barisyamann/2026_Arkhe/fpga/README.md

# FPGA/demo s?r?mleri

nexys_demo_20260908: d45 ortak SoC RTL + Pmod UART2 wrapper, 8 Eyl?l 16:18 bitstream'i, 17:31 demo sonu?lar?. Son UART FIFO d?zeltmesi dahil de?il.
JURI_FPGA_TESTI: 5 Eyl?l tek USB tan?lama firmware/wrapper/bitstream ve kart kay?tlar?. Bunun MCS/bit ?iftini di?er s?r?mle kar??t?rmay?n.

Her s?r?m?n kendi README/KULLANIM belgesini okuyun. Paketleme s?ras?nda kart programlanmad?; yeni fiziksel test yap?lmad?.
