barisyamann/2026_Arkhe/asic/reports/routing/wire_lengths.csv

net | length_um
clknet_2_3_1_clk_i | 6.9465mm
clknet_2_1_1_clk_i | 6.72806mm
clknet_2_0_1_clk_i | 6.52889mm
clknet_2_2_1_clk_i | 5.18468mm
clk_i | 4.64188mm
net4065 | 3.80295mm
net3651 | 3.62575mm
net3675 | 3.61629mm
_027918_ | 3.53636mm
net4210 | 3.467815mm
clknet_7_0_0_clk_i_regs | 3.466395mm
net9088 | 3.46326mm
net9084 | 3.46235mm
net4058 | 3.31082mm
net4142 | 3.075665mm
merged_m_araddr\[3\] | 3.00816mm
u_data_ram.aw_addr_reg\[3\] | 3.0053mm
clknet_7_3_0_clk_i_regs | 3.0016mm
net4051 | 2.89979mm
_027981_ | 2.88226mm
s10_rdata\[6\] | 2.72128mm
net3665 | 2.68324mm
net380 | 2.65649mm
net407 | 2.64611mm
net416 | 2.63029mm
_060634_ | 2.62514mm
net901 | 2.60818mm
net3990 | 2.58616mm
net9157 | 2.58393mm
net909 | 2.58384mm
net8920 | 2.583405mm
net8073 | 2.518835mm
net906 | 2.51304mm
net3401 | 2.49414mm
net2943 | 2.49351mm
net398 | 2.48853mm
net408 | 2.46272mm
net434 | 2.46176mm
net8071 | 2.46164mm
net389 | 2.43297mm
net11709 | 2.42556mm
net385 | 2.39201mm
s8_rdata\[16\] | 2.381375mm
net363 | 2.3696mm
net425 | 2.35906mm
net8077 | 2.353mm
net4400 | 2.34037mm
net371 | 2.33597mm
net8072 | 2.329685mm
net8079 | 2.3274mm
net4329 | 2.32138mm
net470 | 2.31865mm
net362 | 2.31157mm
net479 | 2.30705mm
net893 | 2.30635mm
net372 | 2.30579mm
net443 | 2.30098mm
net354 | 2.29474mm
net376 | 2.29187mm
net356 | 2.28807mm
net799 | 2.27771mm
net515 | 2.27461mm
net31530 | 2.25448mm
net419 | 2.25157mm
net18714 | 2.24152mm
net461 | 2.23207mm
net353 | 2.22472mm
net4248 | 2.21534mm
net987 | 2.21363mm
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
_029973_ | 479.51µm
_067338_ | 479.51µm
net6996 | 479.32µm
_054790_ | 479.28µm
_073847_ | 479.24µm
net2302 | 479.2µm
_049291_ | 479.09µm
_032130_ | 478.84µm
_054701_ | 478.52µm
_023765_ | 478.48µm
_041784_ | 478.37µm
_031653_ | 478.16µm
u_instruction_ram.aw_addr_reg\[6\] | 477.98µm
_028978_ | 477.77µm
_032556_ | 477.69µm
net1433 | 477.69µm
net1042 | 477.64µm
net317 | 477.52µm
_074388_ | 477.41µm
_037269_ | 477.32µm
net9256 | 477.24µm
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
