barisyamann/2026_Arkhe/asic/reports/signoff/full_disconnected_pins_table.txt

┏━━━━━━━━━━━━━━━━━━━━━━━━━━━━━━━━━━━┳━━━━━━━━━━━━━━━━━━━━━━━━━━━━━━━━━━━┳━━━━━━━━━━━━━━┳━━━━━━━━━━━━━━━━━━━━━━━━━━━━━━━━━━━┳━━━━━━━━━━━━━━━━━━━━━━━━━━━━━━━━━━━┓
┃ Macro/Instance                    ┃ Power Pins                        ┃ Disconnected ┃ Signal Pins                       ┃ Disconnected                      ┃
┡━━━━━━━━━━━━━━━━━━━━━━━━━━━━━━━━━━━╇━━━━━━━━━━━━━━━━━━━━━━━━━━━━━━━━━━━╇━━━━━━━━━━━━━━╇━━━━━━━━━━━━━━━━━━━━━━━━━━━━━━━━━━━╇━━━━━━━━━━━━━━━━━━━━━━━━━━━━━━━━━━━┩
│ u_data_ram.g_sram[0\].u_macro     │ u_data_ram.g_sram[0\].u_macro/vc… │              │ u_data_ram.g_sram[0\].u_macro/di… │ u_data_ram.g_sram[0\].u_macro/do… │
│                                   │ u_data_ram.g_sram[0\].u_macro/vs… │              │ u_data_ram.g_sram[0\].u_macro/di… │ u_data_ram.g_sram[0\].u_macro/do… │
│                                   │                                   │              │ u_data_ram.g_sram[0\].u_macro/di… │ u_data_ram.g_sram[0\].u_macro/do… │
│                                   │                                   │              │ u_data_ram.g_sram[0\].u_macro/di… │ u_data_ram.g_sram[0\].u_macro/do… │
│                                   │                                   │              │ u_data_ram.g_sram[0\].u_macro/di… │ u_data_ram.g_sram[0\].u_macro/do… │
│                                   │                                   │              │ u_data_ram.g_sram[0\].u_macro/di… │ u_data_ram.g_sram[0\].u_macro/do… │
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
│                                   │                                   │              │ u_instruction_ram.g_sram[3\].u_m… │                                   │
│                                   │                                   │              │ u_instruction_ram.g_sram[3\].u_m… │                                   │
│                                   │                                   │              │ u_instruction_ram.g_sram[3\].u_m… │                                   │
└───────────────────────────────────┴───────────────────────────────────┴──────────────┴───────────────────────────────────┴───────────────────────────────────┘
