barisyamann/2026_Arkhe/fpga/nexys_demo_20260908/demo/results/ARKHE_20260914_032433/report.md

# Demo Degerlendirme Raporu - ARKHE

- Tarih: 2026-09-14T03:25:24+03:00
- Harness surumu: 1.0.1
- Konfigurasyon kaynagi: `arkhe_icd.json`
- Etkin konfigurasyon: `config_used.json` (SHA256 `cae2893733a1b49e`)
- Veri seti: public_dataset/manifest.csv | seed: 1337
- Arayuzler: stream `COM12@1000000`, core `COM16@115200`

## 1. Ozet - RTL / Golden Model Uyumu

> **Olculen sey modelin dogrulugu degil, tasarimin golden modele sadakatidir.**
> Birincil olcut, donanimin urettigi sinifin golden modelin ayni vektor icin
> urettigi sinifla ayni olmasidir. Gercek etiket (truth) yalnizca bilgi
> amaciyla raporlanir ve puanlamada kullanilmaz.

| Metrik | Deger |
|---|---|
| Gonderilen ornek | 156 |
| Golden referansi olan | 156 |
| Yanitlanan | 154 |
| **Golden ile uyum** | 100.00 %  (154/154) |
| Uyusmazlik | 0 |
| Zaman asimi (referansli ornek) | 2 |
| Uyum (zaman asimlari da hata sayilirsa) | 98.72 % |
| **Golden skor hata orani (MAE)** | 0.0780 % |
| Skor karsilastirilan ornek | 154 |
| En yuksek ornek-bazli skor hatasi | 0.8675 % |
| Gecikme (medyan / p95 / max) | 23.95 / 24.25 / 29.03 ms |
| Olculen hizlanma (yazilim / donanim) | 59.2x |
| Saglamlik senaryolari | 9 / 10 (+1 opsiyonel atlandi) |

> Skor hata orani yalnizca ek bilgidir ve puanlamada kullanilmaz. UART'tan
> gelen dort skor, manifest'teki golden skorlarla ayni sinif sirasinda
> karsilastirilir. Deger 0'a yaklastikca sayisal uyum daha iyidir.

> Not: gecikme, cerceve yaziminin bittigi an ile sonuc satirinin son baytinin
> alindigi an arasidir; UART aktarim ve ISR suresini icerir. Saf hizlandirici
> cevrim sayisi icin RTL simulasyon capraz kontrolu esastir.

## 2. Uyum Matrisi (satir = golden referans, sutun = donanim ciktisi)

| golden \ donanim | silence | unknown | yes | no | TIMEOUT |
|---|---|---|---|---|---|
| **silence** | **6** | 0 | 0 | 0 | 0 |
| **unknown** | 0 | **16** | 0 | 0 | 0 |
| **yes** | 0 | 0 | **50** | 0 | 0 |
| **no** | 0 | 0 | 0 | **82** | 2 |

Kosegen = golden ile ayni sinif. Kosegen disi her hucre, RTL'in golden
modelden ayristigi bir ornektir.

### Bilgi amacli: gercek etikete (truth) gore dogruluk

_Bu bolum puanlamada KULLANILMAZ; veri setinin zorlugu hakkinda fikir verir._

| | Dogruluk |
|---|---|
| Donanim | 72.73 % |
| Golden model (yazilim) | 72.44 % |
| Fark | +0.29 puan |

## 3. Saglamlik Senaryolari (Secenek F)

| Senaryo | Sonuc | Aciklama |
|---|---|---|
| silence_zeros | PASS | cikti=no, gecikme=23.6 ms, sonraki gecerli cerceve yanitladi |
| silence_dither | PASS | cikti=no, gecikme=22.4 ms, sonraki gecerli cerceve yanitladi |
| saturate_max | PASS | cikti=unknown, gecikme=23.4 ms, sonraki gecerli cerceve yanitladi |
| saturate_min | PASS | cikti=silence, gecikme=23.8 ms, sonraki gecerli cerceve yanitladi |
| alternating | PASS | cikti=silence, gecikme=23.4 ms, sonraki gecerli cerceve yanitladi |
| back_to_back | FAIL | araliksiz 5 cerceveden 4 tanesi yanitlandi |
| truncated_frame | PASS | kesik cerceve sonrasi kurtarma basarili (cikti=no) |
| oversized_frame | PASS | fazladan bayt sonrasi kurtarma basarili (cikti=no) |
| peripheral_interleave | SKIP | ATLANDI (opsiyonel): hooks.interleave_core_hex tanimlanmamis; cevre birimi araya girme testi uygulanmadi. |
| determinism | PASS | 10 tekrarda 1 farkli sonuc; gecikme jitter=1.59 ms |
| recovery_after_idle | PASS | 3 s bosta bekledikten sonra yanit verdi (no) |

## 4. Golden Modelden Ayrisan Ornekler

| # | ornek | golden | donanim | truth (bilgi) | skor hata (%) | gecikme (ms) |
|---|---|---|---|---|---|---|
| 0 | go_f19279c4_nohash_0 | no | TIMEOUT | unknown | - | - |
| 1 | no_256c0a05_nohash_0 | no | TIMEOUT | no | - | - |

## 5. Dosyalar

- `samples.csv` - ornek bazli ham kayit ve skor hata bilgisi
- `robustness.csv` - senaryo sonuclari
- `summary.json` - makine okunabilir ozet
- `transcript.log` - core UART ham ciktisi
- `config_used.json` - kosumda gercekten kullanilan etkin ICD
