barisyamann/2026_Arkhe/docs/SARTNAME_UYUMU_VE_SAPMALAR.md

# Şartname Uyumu ve Sapmalar

**9 Eylül 2026 · Arkhe SoC · TEKNOFEST Çip Tasarım Yarışması, Mikrodenetleyici Kategorisi**

Bu belge, tasarımın 2026 Teknik Şartnamesi v1.3 ile uyumunu madde madde
kaydeder; kalan sapmaları ve yorum gerektiren noktaları açıkça belgeler. Şartname §4.2.2.1 ve EK-2
gereği alternatif bileşen kullanımı ve yorum farkları raporda ve sunumda
belirtilmek zorundadır; bu belge o yükümlülüğü karşılar.

Buradaki her sayı ölçülmüştür; kaynak dosya ve satır numarası verilmiştir.

---

## 0. RAPOR FARKI: ÖTR'de RV32IMFC, gerçekte RV32IMC

### Durum

Ön Tasarım Raporu (ÖTR) §3.6.2'de çekirdek komut seti **RV32IMFC**
olarak beyan edilmişti; **F** harfi tek duyarlıklı kayan nokta
(floating-point) eklentisini ifade eder.

Teslim edilen tasarımda **F eklentisi YOKTUR**. Gerçek komut seti
**RV32IMC**'dir.

Kanıt — `rtl/Memory/soc_top.sv` içindeki çekirdek örneklemesi:

    .COREV_PULP      (0),
    .FPU             (0),

### Neden

1. **Uygulama ihtiyacı yok.** TFLite Micro Speech modeli
   tamamen **INT8 tamsayı** aritmetiğiyle çalışır (EK-1: "1960 adet
   INT8 spektrogram değeri"). Softmax dahil tüm hesaplama NPU
   içinde Q0.12 sabit noktada yapılır. Ne firmware ne NPU tek bir
   kayan nokta buyruğu kullanır.

2. **Alan ve zamanlama maliyeti.** CV32E40P'nin FPU'su tasarımın
   en büyük tek bloğu olurdu. 46 KB SRAM zaten die alanının
   büyük kısmını tutuyor (23 makro, 6.544.380 µm²); FPU eklemek
   hem alanı hem kritik yolu belirgin biçimde büyütürdü.

3. **Şartname F eklentisini istemiyor.** §4.2.2.1 yalnızca
   "CV32E40P RISC-V çekirdek IP kullanılacaktır" der; hangi
   konfigürasyonun kullanılacağının "DDK tarafından
   netleştirileceği" yazılıdır. Zorunlu bir F isteri yoktur.

### Nerede doğru beyan ediliyor

`asic/README.md` satır 13 gerçeği yazar:

    CV32E40P (RV32IMC, FPU kapalı)

`asic/results/config/resolved.json` ve sentez raporları da
FPU'suz yapılandırmayı yansıtır; teslim edilen çıktılarla RTL
arasında **çelişki yoktur**.

### Sonuç

Bu bir tasarım eksikliği değil, **ÖTR'deki bir fazla beyandır**.
Final teslimde doğru ISA (RV32IMC) belgelenmiştir. Sunumda ÖTR'ye
atıf yapılırsa bu fark belirtilmelidir.

---

## 1. SAPMA: QSPI Flash parçası — S25FL128S

### Durum

| | |
|---|---|
| Şartnamede referans | MT25QL256ABA8E12 (Micron, 256 Mb) |
| Kullanılan | **Spansion/Cypress S25FL128S** (128 Mb, 16 MB) |
| Neden | Nexys A7-100T geliştirme kartının **üzerinde lehimli** olan parça budur |
| Kart üzerinde doğrulandı | RDID = `0xF0182001` → üretici `0x01`, tip `0x20`, kapasite `0x18` |

Şartname s.24 bu duruma izin verir:

> *"Eğer yarışan bir ekibin belirtilen bellek parçasına erişimi yoksa, bu
> bölümdeki tüm özellikleri desteklediği sürece herhangi bir NOR flash bellek
> kullanmakta özgürdür. (...) Yukarıda belirtilen parçanın kullanılmadığı her
> türlü senaryo, raporlarda ve sunumda açıkça belirtilmelidir."*

### Komut kümesi karşılaştırması — 17/17

Şartname s.24'te 17 zorunlu komut sayılır. S25FL128S bunların **tamamını**
destekler; QSPI Master RTL'inde de hepsi tanımlıdır
(`rtl/Cevre_Birimleri/qspi_master.sv:56-72`):

| Komut | Opcode | S25FL128S | RTL |
|---|---|:---:|:---:|
| READ | 0x03 | ✓ | ✓ |
| DOR (Read Dual Out) | 0x3B | ✓ | ✓ |
| QOR (Read Quad Out) | 0x6B | ✓ | ✓ |
| PP (Page Program) | 0x02 | ✓ | ✓ |
| QPP (Quad Page Program) | 0x32 | ✓ | ✓ |
| SE (Sector Erase) | 0xD8 | ✓ | ✓ |
| READ_ID | 0xAB | ✓ | ✓ |
| RDID | 0x9F | ✓ | ✓ |
| RES | 0xAB | ✓ | ✓ |
| RDSR1 | 0x05 | ✓ | ✓ |
| RDSR2 | 0x07 | ✓ | ✓ |
| RDCR | 0x35 | ✓ | ✓ |
| WRR | 0x01 | ✓ | ✓ |
| WRDI | 0x04 | ✓ | ✓ |
| WREN | 0x06 | ✓ | ✓ |
| CLSR | 0x30 | ✓ | ✓ |
| RESET | 0xF0 | ✓ | ✓ |

### Emsal DDK kararları

DDK bu konuda üç ayrı takıma cevap vermiş ve tutumu tutarlıdır:

| Tarih | Değişim | Eksik komut | DDK cevabı |
|---|---|---|---|
| 29 Ağu 2025 | S25FL128S → W25Q16BV | READ, RESET farkı | *"uygun olur"* |
| 18 Ağu 2026 | → W25Q128JV | CLSR yok | *"kullanabilirsiniz, açıkça belgelenmesi koşuluyla"* |
| 20 Ağu 2026 | → S25FL256L | READ_ID yok | *"kullanabilirsiniz, açıkça belgelenmesi koşuluyla"* |

Dikkat: 2025 şartnamesinde **referans parça S25FL128S'ti** — yani bizim
kullandığımız parça bir önceki yıl doğrudan şartname referansıydı.

**Bizim durumumuz bu üç örnekten daha rahattır: hiçbir komut eksiğimiz yok.**
Fark yalnızca parça numarası ve kapasitedir (128 Mb yerine 256 Mb). Tasarım
16 MB'ın tamamını adresleyebilir; kullanılan alan 24 kB'dır (uygulama 8 kB +
NPU ağırlıkları 16 kB).

---

## 2. ÇÖZÜLDÜ: I2C SCL = tam 400,000 kHz

### Önceki durum (9 Eylül 2026 öncesi)

`rtl/Cevre_Birimleri/i2c_peripheral.sv` SCL periyodunu **dört eşit çeyreğe**
bölüyordu:

```systemverilog
localparam int QUARTER = SYS_CLK_FREQ / (4 * I2C_FREQ);
```

50 MHz'de bu `31,25` eder; tamsayı bölme `31` verir ve gerçek SCL
**403,2 kHz** çıkardı — hedefin %0,8 üstünde.

### Kök neden

Sorun sistem saatinde değil, **eşit çeyrek varsayımındaydı**:

```
SCL periyodu = 50e6 / 400e3 = 125 çevrim     <- TAMSAYI
125 / 4 = 31,25                              <- tamsayı DEĞİL
```

Yani tam 400 kHz üretilebilirdi; yalnızca 125'i dörde eşit bölmek mümkün
değildi.

### Çözüm

Dört çeyreğin **toplamı** tam periyodu verecek şekilde son çeyreğe kalan
verildi:

```
31 + 31 + 31 + 32 = 125  ->  SCL = 50e6 / 125 = 400,000 kHz
```

```systemverilog
localparam int PERIYOT    = SYS_CLK_FREQ / I2C_FREQ;   // 125 @ 50 MHz
localparam int QUARTER    = PERIYOT / 4;               // 31
localparam int SON_CEYREK = PERIYOT - 3 * QUARTER;     // 32

assign ceyrek_uzunluk = (phase == 2'd3) ? SON_CEYREK : QUARTER;
```

Örnekleme noktası faz 2'nin **başında** olduğu için uzatmadan etkilenmez;
`bit_done` faz 3'ün sonunda olduğu için uzayan çeyrekle doğal olarak kayar.

### Ölçüm (simülasyon, 50 MHz sistem saati)

```
PERIYOT    = 125 çevrim
QUARTER    = 31
SON_CEYREK = 32
toplam     = 125

SCL periyot #1 = 125 çevrim = 400.0 kHz
SCL periyot #2 = 125 çevrim = 400.0 kHz
SCL periyot #3 = 125 çevrim = 400.0 kHz
...   (kararlı durumda hepsi 125 çevrim)
```

İlk periyot 156 çevrimdir; bu START koşulundan ilk bite geçiştir, veri
periyodu değildir.

### I2C Fast-mode zamanlama kontrolü

| Ölçüt | Değer | Standart isteri | Durum |
|---|---:|---:|:---:|
| t_LOW | 1,26 µs | ≥ 1,3 µs | sınıra çok yakın¹ |
| t_HIGH | 1,24 µs | ≥ 0,6 µs | ✓ rahat |
| LOW/HIGH oranı | 1,016 | — | dengeli |

¹ t_LOW hesabı (31+32)/50 MHz = 1,26 µs; standardın 1,3 µs isterinin %3
altında. 400 kHz'de bu değerler nominal olarak zaten sınırdadır (tam simetrik
bir 400 kHz saatte t_LOW = t_HIGH = 1,25 µs olurdu). Gerçek I2C hatlarında
yükselme süresi ve köle esnetmesi (clock stretching) bu marjı belirler.

### Doğrulama

| Test | Sonuç |
|---|---|
| Blok testi (`i2c`) | 38 denetim, geçti |
| Sistem testi (`sistem`) | 17 denetim, geçti |
| Frekans ölçümü | 125 çevrim = 400,000 kHz |

**Şartname EK-2 "SCL saat frekansı 400 kHz sabit hızında olacaktır" isteri
artık tam olarak karşılanmaktadır.**

---

## 3. YORUM FARKI: Timer TIM_PRE, PRE = 0xFFFFFFFF

### Şartnamenin kendi içindeki tutarsızlık

Şartname s.21 üç örnek verir:

| Örnek | Şartname der | `PRE+1` kuralı verir |
|---|---|---|
| `TIM_PRE = 0` | 1 periyotta 1 değişir | 1 ✓ |
| `TIM_PRE = 1` | 2 periyotta 1 değişir | 2 ✓ |
| `TIM_PRE = 0xFFFFFFFF` | **0x80000000** periyotta 1 | 0x100000000 ✗ |

İlk iki örnek `bölme oranı = PRE + 1` kuralını tanımlar. Üçüncü örnek aynı
kurala göre `0x100000000` (2³²) vermeliydi; metin `0x80000000` (2³¹) diyor —
**iki kat fark**.

Şartname v1.3 değişiklik listesinde *"[MİKRO] TMR TIM_PRE yazmaç örneği
düzeltildi"* notu bulunur; yani bu örnek bir kez düzeltilmiş, ancak hâlâ ilk
iki örnekle çelişmektedir.

### Bizim seçimimiz

RTL, **kuralı tanımlayan ilk iki örneğe** uyar
(`rtl/Cevre_Birimleri/timer_peripheral.sv:90`):

```systemverilog
if (prescaler_counter >= reg_tim_pre) begin   // PRE+1 çevrimde bir tick
```

Üçüncü örneğe uymak, ilk ikisini bozmak anlamına gelirdi.

### Kart üzerinde doğrulama

Aynı bekleme süresiyle iki ölçüm alınmıştır:

```
PRE = 0  ->  56038 sayım
PRE = 9  ->   5603 sayım        oran = 10,00×  =  (9+1)/(0+1)
```

`PRE+1` kuralı silikonda doğrulanmıştır.

---

## 4. ÇÖZÜLDÜ: QSPI 4 bayt adresleme — QSPI_FCR[2] ile

### Şartnamedeki boşluk

| Şartname konumu | İfade |
|---|---|
| s.24, anlatı | *"Tüm flash alanını kapsamak için **4-bayt adresleme modu desteği** bulunacaktır"* |
| s.26, QSPI_ADR | *"READ, DOR, QOR ve PP komutunda **3-bayt** olarak kullanılır. Yani QSPI_ADR[23:0] bitleri adres olarak gönderilir"* |
| s.25, CCR[24] | *"REZERVE"* |

4-baytı seçecek bir mekanizma **tanımlanmamıştır**.

### Neden CCR[24] değil de FCR[2]

İlk sürümde `CCR[24]` rezerve biti seçici yapılmıştı. Ancak şartname
metni yakından incelendiğinde şu ayrım görüldü:

| Yazmaç | Şartnamenin ifadesi |
|---|---|
| QSPI_CCR[24] | yalnızca *"REZERVE"* — başka hiçbir şey demiyor |
| QSPI_STA | *"Tanımlanmamış tüm bit konumları **Yarışmacı Tanımlı** / Rezerve'dir"* |
| QSPI_FCR | *"Tanımlanmamış tüm bit konumları **Yarışmacı Tanımlı** / Rezerve'dir"* |

**Rezerve bit kullanma iznimiz FCR için açıkça yazılı, CCR için değil.**
Bu yüzden 9 Eylül 2026'da mekanizma `QSPI_FCR[2]`'ye taşındı.

`QSPI_STA` da bu cümleyi taşır ama salt okunurdur (RO); yazılım oraya
yazamayacağı için kontrol biti olarak kullanılamaz. `QSPI_FCR` ise
yazılabilirdir (RW) ve `[0]`/`[1]` dışındaki 30 biti boştur.

### Çözüm

```systemverilog
assign ccr_addr_4byte = reg_adr_4byte || (reg_adr[31:24] != 8'h00);
```

| FCR[2] | ADR[31:24] | Adres | Gerekçe |
|:---:|:---:|---|---|
| 0 | 0x00 | 3 bayt | s.26 ile **birebir** (reset hali) |
| 0 | ≠ 0 | 4 bayt | adres 16 MB'ı aşıyor, zorunlu |
| 1 | 0x00 | 4 bayt | yazılım açık seçim yaptı |
| 1 | ≠ 0 | 4 bayt | ikisi birden |

**`QSPI_CCR[24]` hiç kullanılmaz ve daima 0 kalır.**

`FCR[2]` kalıcı bir kip bayrağıdır — `FCR[0]`/`FCR[1]` flush darbelerinin
aksine kendini sıfırlamaz. Geri okumada da görünür, böylece yazılım kipi
doğrulayabilir.

### Neden adres genişliği de kontrol ediliyor

Yalnızca adres genişliğine bakmak **yetmez**. `tb_qspi_mock`'un 4-bayt
bölümü bunu ölçtü: flash 4-bayt kipindeyken **düşük** adresler de
(örn. `0x00000008`) dört bayt gönderilmelidir; bu bilgi adresin kendisinde
yoktur.

```
Tek başına otomatik algılama denendi, iki denetim düştü:
  [HATA] 4-bayt: flash kelime 2: beklenen=0xa5a50002 gercek=0x000000ff
  [HATA] 4-bayt: flash kelime 3: beklenen=0xa5a50003 gercek=0x00000000
```

Bu yüzden açık seçim yolu (`FCR[2]`) korundu. Adres genişliği kontrolü ek
güvenlik sağlar: 16 MB'ı aşan bir adres verildiğinde yazılım `FCR[2]`'yi
kurmayı unutsa bile kontrolcü dört bayt basar.

### Elenen alternatifler

| Yöntem | Neden seçilmedi |
|---|---|
| CCR[24] rezerve biti | Kullanma izni şartnamede **yazılı değil** |
| 4-bayt komut varyantları (0x13, 0x12, 0x0C) | Şartnamenin **17 zorunlu komut listesinde yok** |
| Kip değiştirme komutları (0xB7 / 0xE9) | Aynı sebep; ayrıca karttaki S25FL128S 16 MB olduğu için gerçek donanımda **doğrulanamaz** |

### Ölçüm — SCK kenar sayımı (`tb_sartname_qspi`)

```
FCR[2]=0, ADR = 0x0012_3456   ->  40 kenar   (8 komut + 24 adres + 8 veri)
FCR[2]=1, ADR = 0x12AB_CDEF   ->  48 kenar   (8 komut + 32 adres + 8 veri)
FCR[2]=0, ADR = 0x34AB_CDEF   ->  48 kenar   (büyük adres, otomatik)
CCR[24]=1 yazıldı              ->  40 kenar   (bit etkisiz - GERÇEKTEN REZERVE)
```

Son satır kritiktir: `CCR[24]`'e 1 yazılsa bile davranış değişmiyor.

Ayrıca `tb_qspi_mock` (40 denetim) flash modelini 4-bayt kipine alıp
`FCR[2]=1` ile okuma yapar ve gelen verinin doğru kelime olduğunu denetler.
Test yorumu şöyle der:

> *"Bu test AYIRT EDICIDIR: 4-bayt bekleyen flash'a yalnızca 3 bayt adres
> gönderilirse model hâlâ adres fazındadır ve ilk veri baytını adresin son
> baytı sanıp yutar. Okunan kelime kayar, denetim düşer."*

### Yazılım etkisi

Yoktur. Mevcut yazılımların hiçbiri 16 MB'ı aşan adres kullanmaz (en yüksek
kullanılan adres `0x805E7F`) ve karttaki S25FL128S 16 MB'dır; 3 bayt adres
tüm alanı kapsar. `bootloader.S` ve `fpga_demo.c` hiçbir 4-bayt kip biti
yazmaz.

### Şartname uyumu

Bu değişiklikle QSPI bölümünde **şartnamede yazılı izni olmayan hiçbir
kullanım kalmamıştır**. `tb_sartname_qspi` 27 denetimin tamamını geçer.

---

## 5. Mimari not: NPU bellek erişimi

Bu bir sapma değildir; şartnameye uygunluğu kayda geçirmek için yazılmıştır.

### Yapı

```
              ANA AXI4-Lite INTERCONNECT  (tek interconnect)
                            │
            ┌───────────────┼────────────────┐
       Slave 9         Slave 10         (diğer 9 slave)
      NPU CSR        NPU BELLEĞİ       GPIO, UART×2, I2C,
    0x4006_0000      0x2001_0000       QSPI, Timer, DMA...
                          │
                  ┌───────┴───────┐
              Port A           Port B
            (yaz + oku)      (salt oku)
                  │                │
          AXI'den: CPU/DMA    yerel AXI4-Lite: NPU motoru
```

- NPU belleği **ana interconnect'te Slave 10**'dur; UART→DMA→bellek yolu
  tamamen ana AXI4-Lite üzerinden gider.
- NPU motoru ayrıca SRAM makrosunun **ikinci portundan** (Port B) okur. Bu
  ikinci bir veri yolu değil, `sky130_sram_2kbyte_1rw1r_32x512_8` makrosunun
  donanımsal olarak sunduğu porttur.
- Motorun bağlantısı da **tam AXI4-Lite**'tır (`npu_engine_axi_master.sv`:
  AW/W/B/AR/R beş kanal, valid-ready el sıkışması, bresp/rresp yanıtları).

### Şartname dayanağı

EK-2 girişi: *"bus mimarisi ve protokolü AXI-uyumlu (konfigürasyon için
AXI4-Lite, veri için AXI4/AXI4-Lite) bir arayüz olmalıdır"* — her iki yol da
AXI4-Lite'tır.

§4.2.2.2: *"YZ hızlandırıcı kendi bellek bölgesine sahip olacağı için SoC'de
aynı bellek üzerinde birden fazla master bulunmasına gerek yoktur."*

Bu mimari ÖTR ve DTR'de sunulmuş ve her iki rapor aşaması geçilmiştir.

### Ölçülen maliyet (alternatifin neden seçilmediği)

NPU motorunun TCM erişimi simülasyonda sayılmıştır
(`tb/npu_golden`, Port B sayacı):

| | Değer |
|---|---:|
| Okuma erişimi | **40.512** |
| Yazma erişimi | 4 |
| Çıkarım çevrimi | 85.589 |
| Erişim yoğunluğu | **%47,3** (her ~2 çevrimde bir) |

Motor ana yola taşınsaydı, AXI4-Lite'ta her okuma en az 2 çevrim sürdüğü için:

| Senaryo | Çevrim | Yavaşlama |
|---|---:|---:|
| Mevcut (Port B) | 85.589 | — |
| Ana yol, en iyi durum | 126.105 | 1,5× |
| Ana yol, gerçekçi | 207.137 | **2,4×** |
| Ana yol, CPU/DMA çakışması | 288.169 | 3,4× |

AXI4 burst da çözüm değildir: erişimlerin dağılımı ölçülmüştür —

| Tür | Adet | Ardışık mı |
|---|---:|---|
| FC ağırlık okuması | 4.000 | evet, burst edilebilir |
| **Konvolüsyon girdi okuması** | **36.512** | **hayır** — 10×8 pencere satır atlamalı |

Erişimlerin **%90'ı burst edilemez**; bu konvolüsyonun yapısal özelliğidir,
tasarım tercihi değil.

Şartname §4.2.2.1 hızlandırıcı performansının *"veri/saat döngüsü bazında"*
değerlendirileceğini söyler; 2,4× yavaşlama doğrudan puan kaybı olurdu.

---

## 6. Uyum özeti

### §4.2.2.1 Genel İsterler — 12/12

| İster | Durum |
|---|:---:|
| CV32E40P çekirdek | ✓ |
| 8 kB buyruk + 8 kB veri belleği | ✓ |
| 30 kB NPU belleği | ✓ |
| Boot ROM 512 B – 1 kB | ✓ (1 kB) |
| QSPI'den boot | ✓ |
| Reset'siz birim geçişi | ✓ |
| GPIO 32 pin (16 giriş + 16 çıkış) | ✓ |
| 2× UART (genel + stream) | ✓ |
| I2C Master / QSPI Master / Timer | ✓ |
| JTAG (opsiyonel, +3 bonus) | ✓ |
| AXI-uyumlu bus | ✓ |
| Bellek haritası yarışmacı tanımlı | ✓ |

### EK-1 YZ Hızlandırıcı — 6/6

| İster | Durum | Ölçüm |
|---|:---:|---|
| TFLite Micro Speech RTL gerçeklemesi | ✓ | DepthwiseConv2D + FC + Softmax |
| 1960 değer girdi → 4 sınıf | ✓ | kartta `[0, 225, 326, 3543]` |
| UART-stream → bellek → AXI → hızlandırıcı | ✓ | DMA zinciri |
| Kesme üretimi | ✓ | `irq_o` |
| Yazılıma karşı hızlanma | ✓ | **177×** (kart üzerinde ölçüldü, 14 Eylül) |
| %10 doğruluk penceresi | ✓ | altın referansla **birebir** |

### EK-2 Çevre Birimi Yazmaçları

| Birim | Durum |
|---|---|
| GPIO (IDR/ODR) | tam uyumlu |
| Timer (7 yazmaç) | tam uyumlu — PRE örneği için bkz. §3 |
| UART (CPB/STP/RDR/TDR/CFG) | tam uyumlu, v1.3 CFG[0] otomatik sıfırlama dahil |
| I2C (NBY/ADR/RDR/TDR/CFG) | tam uyumlu — SCL tam 400,000 kHz, bkz. §2 |
| QSPI (CCR/ADR/DR/STA/FCR) | tam uyumlu — 4-bayt için bkz. §4 |

### EK-3 Doğrulama

| Madde | Öncelik | Durum |
|---|---|:---:|
| Protokol kontrolleri | Zorunlu | ✓ UVM, **iki** AXI4-Lite agent, 401.729 işlem |
| YZ hızlandırıcı testleri | Zorunlu | ✓ self-checking |
| Sistem seviyesi testler | Zorunlu | ✓ |
| Çekirdek testleri (Spike ISS) | Elden gelenin en iyisi | ✓ 927 komut, 0 fark |
| Doğrulama planı | Elden gelenin en iyisi | ✓ |
| Blok seviyesi testler | Opsiyonel | ✓ **17 blok** |
| Code coverage | Opsiyonel | ✓ %81,6 satır / %74,9 dal (bizim RTL) |

**Güncel RTL ile regresyon: 37/37 test, 702 denetim, tamamı geçti** (13 Eylül 2026). Eklenen testler: 10-11 Eylül'de düzeltilen dört RTL hatası için `sram_w_yakalama`, `axi_w_yakalama`, `qspi_presc_sinir`, `axi_protokol`, `sinir_degerleri`; 12 Eylül'de ASIC saat hedefi için `i2c_scl_frekans` ve `i2c_scl_periyot`, UVM kapsam genişletmesinin açığa çıkardığı bayt-seçmeli yazma boşluğu için `wstrb_kismi_yazma`, hata enjeksiyonunun ortaya çıkardığı iki dekoratif test yerine `qspi_sck_olcum`, ve blok testi bulunmayan iki büyük modül için `interconnect_adres` (13 slave adres çözme) ile `npu_accelerator`; JTAG saat alani gecisi icin `jtag_cdc`; kullanilmayan giris portu taramasinin ortaya cikardigi iki islevsel eksiklik icin `jtag_yanit_kodu` (AXI yanit kodu denetimi) ve `i2c_saat_germe` (I2C clock stretching). 13 Eylul'de iki eksik daha kapatildi: regresyonda kayitli OLMAYAN `tb_sram_registered` (sram_module teslim edilen tasarimin parcasidir, filelist.f satir 23) eklendi; `npu_accelerator` hakemliginin MOTOR dali (A1) uyandirilip veri yolu denetimiyle dogrulandi. Ayrica aktif UVM testi (`uvm_aktif`) regresyona baglandi: kodda mevcut olan driver/sequencer/sequence altyapisi artik ana kosumda calisir ve pasif izlemenin uyaramadigi WSTRB/yanit kapsam bin'lerini kapatir.

Testlerin gerçekten hata yakaladığı **ölçülmüştür**: `scripts/hata_enjeksiyon.py` RTL'e kasıtlı hata sokup ilgili testin kırmızıya döndüğünü doğrular. 9/9 mutasyon yakalanmaktadır; kampanya sonrası 57/57 RTL dosyası birebir korunur. Döküm: `evidence/denetim_20260910/HATA_ENJEKSIYONU.md`.

### §5.2 Ödül Minimum Kriterleri

> Aşağıdaki tablo **kendi ölçümlerimizi** verir; puanlama jürinin
> takdirindedir. Her satırda hem sağlanan hem de açık kalan yön
> belirtilmiştir.

| Kriter | Ölçülen durum | Kanıt |
|---|---|---|
| FPGA'da test senaryoları | Kart üzerinde resmi araçla **156/156 örnek, altın referansla %100 uyum, 0 zaman aşımı**, ölçülen hızlanma **177×**. Ayrı bir koşumda dört sınıf skoru da altın referansla karşılaştırıldı: **MAE %0,078**. Sağlamlık senaryoları **9 PASS / 1 FAIL / 1 SKIP** — `back_to_back` beş çerçevenin dördüne yanıt veriyor (bilinen sınırlama, §6'da) | `evidence/fpga_demo_20260914_normal/`, `evidence/fpga_demo_20260914_skorlu/`, `evidence/FPGA_DEMO_A_IKI_KOSUM.md` |
| Self-checking boot + çevre birimi | Gerçek QSPI boot zinciri (Boot ROM → Flash → I-RAM → `jalr` → uygulama) simülasyonda; kart üzerinde **2×86 öztest**, 21 NPU çıkarımı, elle GPIO/LED kontrolleri dahil. **I2C harici ESP32 slave ile gerçek yaz-oku doğrulandı** | `sistem_gercek_boot`, `evidence/fpga_democ_20260914/` |
| AXI protokol kontrolü | 2 UVM pasif agent + 5 SVA checker, **401.729 işlem, 0 protokol ihlali**, 13 adres bölgesinin tamamı uyarıldı | `verification/AXI_UVM_KAPSAM_MATRISI.md` |
| YZ hızlandırıcı test senaryosu | Altın vektör + dört sınıflı doğruluk + sarmalayıcı entegrasyonu; kart üzerinde 21 çıkarım, referansla 0 uyuşmazlık | `npu_golden`, `npu_dogruluk`, `npu_accelerator` |
| GDSII üretimi ve fiziksel imzalama | GDSII üretildi. **Temiz:** LVS (GDS kaynaklı dahil), KLayout DRC, detailed-route DRC, XOR, anten, PDN — hepsi 0. **Açık:** Magic DRC 7.658 (tamamı `nwell.4`, makro kaynaklı), max slew 16.030, max cap 1.952, fanout 81 | `asic/README.md` §9, §11 |

**Üretime hazır (production-ready) iddiasında bulunmuyoruz.** Magic DRC
ve elektriksel DRV kalemleri açıktır; kök nedenleri ölçülmüş ve
`asic/README.md` §9'da belgelenmiştir. Şartname açık ihlallerin
teslimi geçersiz kılmadığını, ancak gizlenmemesi gerektiğini söyler.

---

## 7. Sunumda söylenecekler

Şartname §3.3.2 puanlama tablosunda *"Şartnameye göre eksikliklerin açık bir
şekilde anlatımı ve analizi"* başlığı vardır. Yukarıdaki dört madde sunumda
şu çerçevede aktarılmalıdır:

1. **Flash parçası** — kart üstü S25FL128S; 17/17 komut destekli; DDK'nın
   benzer üç başvuruya verdiği onaylar emsaldir.
2. **I2C** — 9 Eylül 2026'da tam 400,000 kHz'e çekildi (eşit olmayan
   çeyrek yapısı); sapma kalmadı.
3. **Timer PRE** — şartnamenin üç örneğinden ikisi `PRE+1` der, üçüncüsü
   çelişir; kuralı tanımlayan örneklere uyulmuştur.
4. **QSPI 4-bayt adresleme** — şartname 4-bayt ister ama seçim mekanizması
   tanımlamaz. Şartnamenin *"Yarışmacı Tanımlı"* dediği `QSPI_FCR[2]`
   kullanıldı; `CCR[24]` hiç kullanılmıyor.
