barisyamann/2026_Arkhe/evidence/coverage_islevsel/fcov_rapor/cekirdek_izi/functionalCoverageReport/grp0.html

Dashboard Groups

Group - tb_soc_top::cg_soc_verification

Group Info : cg_soc_verification

Score | Num Insts | Avg Insts Score | Weight | Goal | Merge Insts | Get Inst Crvg | Per Inst | Auto Bin Max | Print Missing | Comment
13.4375 | 1 | 13.4375 | 1 | 100 | 0 | 0 | 1 | 64 | 0

Source File(s) : C:/Users/ybari/2026_Arkhe/tb/tb_soc_top.sv

Group Instance[s] Info : 1 (Total)

Name⇅ | Score⇅ | Weight | Goal | At Least | Auto Bin Max | Print Missing | Comment
cg_inst | 13.4375 | 1 | 100 | 1 | 64 | 0

Instance : cg_inst

Instance Info : cg_inst

Score | Weight | Goal | At Least | Auto Bin Max | Print Missing | Is Instantized | Comment
13.4375 | 1 | 100 | 1 | 64 | 0 | 1

Instance Variable[s] Summary : cg_inst

Cover Points | Category | Expected | Uncovered | Covered | Avg Percent
15 | Variables | 35 | 28 | 7 | 14.3333
1 | Crosses | 4 | 4 | 0 | 0

Instance Cover Point[s] Details : cg_inst

Name⇅ | Expected | Uncovered | Covered | Percent⇅ | Goal | Weight | At Least | Auto Bin Max | Comment
cov_gpio | 5 | 4 | 1 | 20 | 100 | 1 | 1 | 64
cov_jta ...cov_jtag_tms | 2 | 1 | 1 | 50 | 100 | 1 | 1 | 64
cov_axi ...cov_axi_aw | 1 | 1 | 0 | 0 | 100 | 1 | 1 | 64
cov_axi ...cov_axi_w | 1 | 1 | 0 | 0 | 100 | 1 | 1 | 64
cov_axi ...cov_axi_ar | 1 | 1 | 0 | 0 | 100 | 1 | 1 | 64
cov_axi ...cov_axi_r | 1 | 1 | 0 | 0 | 100 | 1 | 1 | 64
cov_irq ...cov_irq_npu | 1 | 1 | 0 | 0 | 100 | 1 | 1 | 64
cov_irq ...cov_irq_timer | 1 | 1 | 0 | 0 | 100 | 1 | 1 | 64
cov_irq ...cov_irq_dma | 1 | 1 | 0 | 0 | 100 | 1 | 1 | 64
cov_irq ...cov_irq_fault | 1 | 1 | 0 | 0 | 100 | 1 | 1 | 64
cov_dma ...cov_dma_state | 6 | 5 | 1 | 16.6667 | 100 | 1 | 1 | 64
cov_uar ...cov_uart2_fifo | 5 | 4 | 1 | 20 | 100 | 1 | 1 | 64
cov_npu ...cov_npu_class | 4 | 3 | 1 | 25 | 100 | 1 | 1 | 64
cov_fau ...cov_fault_src | 2 | 1 | 1 | 50 | 100 | 1 | 1 | 64
cov_axi ...cov_axi_resp | 3 | 2 | 1 | 33.3333 | 100 | 1 | 1 | 64

Instance Cross[es] Details : cg_inst

Name⇅ | Expected | Uncovered | Covered | Percent⇅ | Goal | Weight | At Least | Comment
cov_irq ...cov_irq_npuxcov_npu_class | 4 | 4 | 0 | 0 | 100 | 1 | 1

Cover Points

Inst cg_inst

cov_gpio cov_jtag_tms cov_axi_aw cov_axi_w cov_axi_ar cov_axi_r cov_irq_npu cov_irq_timer cov_irq_dma cov_irq_fault cov_dma_state cov_uart2_fifo cov_npu_class cov_fault_src cov_axi_resp cov_irq_npuxcov_npu_class(cross)

Details of Instance Cover Point - cg_inst :: cov_gpio

Summary of Cover Point - cov_gpio

Category | Expected | Uncovered | Covered | Percent
User Defined Bins | 5 | 4 | 1 | 20

User Generated Bins for Instance Cover Point - cg_inst :: cov_gpio
Uncovered bins

Name ⇅ | Hit Count ⇅ | At least
cls_yes | 0 | 1
cls_no | 0 | 1
cls_sil | 0 | 1
cls_unk | 0 | 1

Covered bins

Name ⇅ | Hit Count ⇅ | At least
idle | 10008 | 1

Details of Instance Cover Point - cg_inst :: cov_jtag_tms

Summary of Cover Point - cov_jtag_tms

Category | Expected | Uncovered | Covered | Percent
User Defined Bins | 2 | 1 | 1 | 50

User Generated Bins for Instance Cover Point - cg_inst :: cov_jtag_tms
Uncovered bins

Name ⇅ | Hit Count ⇅ | At least
high | 0 | 1

Covered bins

Name ⇅ | Hit Count ⇅ | At least
low | 10008 | 1

Details of Instance Cover Point - cg_inst :: cov_axi_aw

Summary of Cover Point - cov_axi_aw

Category | Expected | Uncovered | Covered | Percent
User Defined Bins | 1 | 1 | 0 | 0

User Generated Bins for Instance Cover Point - cg_inst :: cov_axi_aw
Uncovered bins

Name ⇅ | Hit Count ⇅ | At least
hit | 0 | 1

Details of Instance Cover Point - cg_inst :: cov_axi_w

Summary of Cover Point - cov_axi_w

Category | Expected | Uncovered | Covered | Percent
User Defined Bins | 1 | 1 | 0 | 0

User Generated Bins for Instance Cover Point - cg_inst :: cov_axi_w
Uncovered bins

Name ⇅ | Hit Count ⇅ | At least
hit | 0 | 1

Details of Instance Cover Point - cg_inst :: cov_axi_ar

Summary of Cover Point - cov_axi_ar

Category | Expected | Uncovered | Covered | Percent
User Defined Bins | 1 | 1 | 0 | 0

User Generated Bins for Instance Cover Point - cg_inst :: cov_axi_ar
Uncovered bins

Name ⇅ | Hit Count ⇅ | At least
hit | 0 | 1

Details of Instance Cover Point - cg_inst :: cov_axi_r

Summary of Cover Point - cov_axi_r

Category | Expected | Uncovered | Covered | Percent
User Defined Bins | 1 | 1 | 0 | 0

User Generated Bins for Instance Cover Point - cg_inst :: cov_axi_r
Uncovered bins

Name ⇅ | Hit Count ⇅ | At least
hit | 0 | 1

Details of Instance Cover Point - cg_inst :: cov_irq_npu

Summary of Cover Point - cov_irq_npu

Category | Expected | Uncovered | Covered | Percent
User Defined Bins | 1 | 1 | 0 | 0

User Generated Bins for Instance Cover Point - cg_inst :: cov_irq_npu
Uncovered bins

Name ⇅ | Hit Count ⇅ | At least
fired | 0 | 1

Details of Instance Cover Point - cg_inst :: cov_irq_timer

Summary of Cover Point - cov_irq_timer

Category | Expected | Uncovered | Covered | Percent
User Defined Bins | 1 | 1 | 0 | 0

User Generated Bins for Instance Cover Point - cg_inst :: cov_irq_timer
Uncovered bins

Name ⇅ | Hit Count ⇅ | At least
fired | 0 | 1

Details of Instance Cover Point - cg_inst :: cov_irq_dma

Summary of Cover Point - cov_irq_dma

Category | Expected | Uncovered | Covered | Percent
User Defined Bins | 1 | 1 | 0 | 0

User Generated Bins for Instance Cover Point - cg_inst :: cov_irq_dma
Uncovered bins

Name ⇅ | Hit Count ⇅ | At least
fired | 0 | 1

Details of Instance Cover Point - cg_inst :: cov_irq_fault

Summary of Cover Point - cov_irq_fault

Category | Expected | Uncovered | Covered | Percent
User Defined Bins | 1 | 1 | 0 | 0

User Generated Bins for Instance Cover Point - cg_inst :: cov_irq_fault
Uncovered bins

Name ⇅ | Hit Count ⇅ | At least
fired | 0 | 1

Details of Instance Cover Point - cg_inst :: cov_dma_state

Summary of Cover Point - cov_dma_state

Category | Expected | Uncovered | Covered | Percent
User Defined Bins | 6 | 5 | 1 | 16.6667

User Generated Bins for Instance Cover Point - cg_inst :: cov_dma_state
Uncovered bins

Name ⇅ | Hit Count ⇅ | At least
read_req | 0 | 1
read_wait | 0 | 1
write_req | 0 | 1
write_wait | 0 | 1
done | 0 | 1

Covered bins

Name ⇅ | Hit Count ⇅ | At least
idle | 10008 | 1

Details of Instance Cover Point - cg_inst :: cov_uart2_fifo

Summary of Cover Point - cov_uart2_fifo

Category | Expected | Uncovered | Covered | Percent
User Defined Bins | 5 | 4 | 1 | 20

User Generated Bins for Instance Cover Point - cg_inst :: cov_uart2_fifo
Uncovered bins

Name ⇅ | Hit Count ⇅ | At least
az | 0 | 1
orta | 0 | 1
cok | 0 | 1
dolu | 0 | 1

Covered bins

Name ⇅ | Hit Count ⇅ | At least
bos | 10008 | 1

Details of Instance Cover Point - cg_inst :: cov_npu_class

Summary of Cover Point - cov_npu_class

Category | Expected | Uncovered | Covered | Percent
User Defined Bins | 4 | 3 | 1 | 25

User Generated Bins for Instance Cover Point - cg_inst :: cov_npu_class
Uncovered bins

Name ⇅ | Hit Count ⇅ | At least
unknown | 0 | 1
yes | 0 | 1
no | 0 | 1

Covered bins

Name ⇅ | Hit Count ⇅ | At least
silence | 10008 | 1

Details of Instance Cover Point - cg_inst :: cov_fault_src

Summary of Cover Point - cov_fault_src

Category | Expected | Uncovered | Covered | Percent
User Defined Bins | 2 | 1 | 1 | 50
Illegal bin[s] | 1

User Generated Bins for Instance Cover Point - cg_inst :: cov_fault_src
Uncovered bins

Name ⇅ | Hit Count ⇅ | At least
veri_kopru | 0 | 1

Covered bins

Name ⇅ | Hit Count ⇅ | At least
yok | 10008 | 1

Illegal Bins for Instance Cover Point - cg_inst :: cov_fault_src
Illegal bins

Name | Hit Count
buyruk_kopru | 0

Details of Instance Cover Point - cg_inst :: cov_axi_resp

Summary of Cover Point - cov_axi_resp

Category | Expected | Uncovered | Covered | Percent
User Defined Bins | 3 | 2 | 1 | 33.3333

User Generated Bins for Instance Cover Point - cg_inst :: cov_axi_resp
Uncovered bins

Name ⇅ | Hit Count ⇅ | At least
slverr | 0 | 1
decerr | 0 | 1

Covered bins

Name ⇅ | Hit Count ⇅ | At least
okay | 69 | 1

Details of Instance Cross Point - cg_inst :: cov_irq_npuxcov_npu_class

Samples Crossed : cov_irq_npuxcov_npu_class

Summary of Cross Point - cov_irq_npuxcov_npu_class

Category | Expected | Uncovered | Covered | Percent
Total | 4 | 4 | 0 | 0
Auto Generated Bins | 4 | 4 | 0 | 0

Automatically Generated Bins for Group Cross Point - cg_inst :: cov_irq_npuxcov_npu_class
Uncovered bins

cov_irq_npu | cov_npu_class | Hit Count | At least
fired | * | 0 | 1
