barisyamann/2026_Arkhe/evidence/coverage_islevsel/fcov_rapor/npu_blok/functionalCoverageReport/grp0.html

Dashboard Groups

Group - tb_npu_compute_engine::cg_npu_inference

Group Info : cg_npu_inference

Score | Num Insts | Avg Insts Score | Weight | Goal | Merge Insts | Get Inst Crvg | Per Inst | Auto Bin Max | Print Missing | Comment
100 | 1 | 100 | 1 | 100 | 0 | 0 | 1 | 64 | 0

Source File(s) : C:/Users/ybari/2026_Arkhe/tb/tb_npu_compute_engine.sv

Group Instance[s] Info : 1 (Total)

Name⇅ | Score⇅ | Weight | Goal | At Least | Auto Bin Max | Print Missing | Comment
cg_inst | 100 | 1 | 100 | 1 | 64 | 0

Instance : cg_inst

Instance Info : cg_inst

Score | Weight | Goal | At Least | Auto Bin Max | Print Missing | Is Instantized | Comment
100 | 1 | 100 | 1 | 64 | 0 | 1

Instance Variable[s] Summary : cg_inst

Cover Points | Category | Expected | Uncovered | Covered | Avg Percent
1 | Variables | 4 | 0 | 4 | 100

Instance Cover Point[s] Details : cg_inst

Name⇅ | Expected | Uncovered | Covered | Percent⇅ | Goal | Weight | At Least | Auto Bin Max | Comment
cov_cla ...cov_class | 4 | 0 | 4 | 100 | 100 | 1 | 1 | 64

Cover Points

Inst cg_inst

cov_class

Details of Instance Cover Point - cg_inst :: cov_class

Summary of Cover Point - cov_class

Category | Expected | Uncovered | Covered | Percent
User Defined Bins | 4 | 0 | 4 | 100

User Generated Bins for Instance Cover Point - cg_inst :: cov_class
Covered bins

Name ⇅ | Hit Count ⇅ | At least
silence | 427968 | 1
unknown | 2 | 1
yes | 2 | 1
no | 4 | 1
