barisyamann/2026_Arkhe/evidence/coverage_islevsel/fcov_rapor/sartname_uart_stream/functionalCoverageReport/grp0.html

Dashboard Groups

Group - tb_sartname_uart_stream::cg_stream

Group Info : cg_stream

Score | Num Insts | Avg Insts Score | Weight | Goal | Merge Insts | Get Inst Crvg | Per Inst | Auto Bin Max | Print Missing | Comment
100 | 1 | 100 | 1 | 100 | 0 | 0 | 1 | 64 | 0

Source File(s) : C:/Users/ybari/2026_Arkhe/tb/sartname/tb_sartname_uart_stream.sv

Group Instance[s] Info : 1 (Total)

Name⇅ | Score⇅ | Weight | Goal | At Least | Auto Bin Max | Print Missing | Comment
cg | 100 | 1 | 100 | 1 | 64 | 0

Instance : cg

Instance Info : cg

Score | Weight | Goal | At Least | Auto Bin Max | Print Missing | Is Instantized | Comment
100 | 1 | 100 | 1 | 64 | 0 | 1

Instance Variable[s] Summary : cg

Cover Points | Category | Expected | Uncovered | Covered | Avg Percent
2 | Variables | 9 | 0 | 9 | 100

Instance Cover Point[s] Details : cg

Name⇅ | Expected | Uncovered | Covered | Percent⇅ | Goal | Weight | At Least | Auto Bin Max | Comment
cov_fif ...cov_fifo_level | 5 | 0 | 5 | 100 | 100 | 1 | 1 | 64
cov_pac ...cov_pack_cnt | 4 | 0 | 4 | 100 | 100 | 1 | 1 | 64

Cover Points

Inst cg

cov_fifo_level cov_pack_cnt

Details of Instance Cover Point - cg :: cov_fifo_level

Summary of Cover Point - cov_fifo_level

Category | Expected | Uncovered | Covered | Percent
User Defined Bins | 5 | 0 | 5 | 100

User Generated Bins for Instance Cover Point - cg :: cov_fifo_level
Covered bins

Name ⇅ | Hit Count ⇅ | At least
bos | 534 | 1
az | 31604 | 1
orta | 64104 | 1
cok | 32134 | 1
dolu | 12232 | 1

Details of Instance Cover Point - cg :: cov_pack_cnt

Summary of Cover Point - cov_pack_cnt

Category | Expected | Uncovered | Covered | Percent
User Defined Bins | 4 | 0 | 4 | 100

User Generated Bins for Instance Cover Point - cg :: cov_pack_cnt
Covered bins

Name ⇅ | Hit Count ⇅ | At least
b0 | 140594 | 1
b1 | 4 | 1
b2 | 4 | 1
b3 | 4 | 1
