barisyamann/2026_Arkhe/evidence/coverage_islevsel/fcov_rapor/sistem/functionalCoverageReport/grp0.html

Dashboard Groups

Group - tb_soc_top::cg_soc_verification

Group Info : cg_soc_verification

Score | Num Insts | Avg Insts Score | Weight | Goal | Merge Insts | Get Inst Crvg | Per Inst | Auto Bin Max | Print Missing | Comment
100 | 1 | 100 | 1 | 100 | 0 | 0 | 1 | 64 | 0

Source File(s) : C:/Users/ybari/2026_Arkhe/tb/tb_soc_top.sv

Group Instance[s] Info : 1 (Total)

Name⇅ | Score⇅ | Weight | Goal | At Least | Auto Bin Max | Print Missing | Comment
cg_inst | 100 | 1 | 100 | 1 | 64 | 0

Instance : cg_inst

Instance Info : cg_inst

Score | Weight | Goal | At Least | Auto Bin Max | Print Missing | Is Instantized | Comment
100 | 1 | 100 | 1 | 64 | 0 | 1

Instance Variable[s] Summary : cg_inst

Cover Points | Category | Expected | Uncovered | Covered | Avg Percent
15 | Variables | 35 | 0 | 35 | 100
1 | Crosses | 4 | 0 | 4 | 100

Instance Cover Point[s] Details : cg_inst

Name⇅ | Expected | Uncovered | Covered | Percent⇅ | Goal | Weight | At Least | Auto Bin Max | Comment
cov_gpio | 5 | 0 | 5 | 100 | 100 | 1 | 1 | 64
cov_jta ...cov_jtag_tms | 2 | 0 | 2 | 100 | 100 | 1 | 1 | 64
cov_axi ...cov_axi_aw | 1 | 0 | 1 | 100 | 100 | 1 | 1 | 64
cov_axi ...cov_axi_w | 1 | 0 | 1 | 100 | 100 | 1 | 1 | 64
cov_axi ...cov_axi_ar | 1 | 0 | 1 | 100 | 100 | 1 | 1 | 64
cov_axi ...cov_axi_r | 1 | 0 | 1 | 100 | 100 | 1 | 1 | 64
cov_irq ...cov_irq_npu | 1 | 0 | 1 | 100 | 100 | 1 | 1 | 64
cov_irq ...cov_irq_timer | 1 | 0 | 1 | 100 | 100 | 1 | 1 | 64
cov_irq ...cov_irq_dma | 1 | 0 | 1 | 100 | 100 | 1 | 1 | 64
cov_irq ...cov_irq_fault | 1 | 0 | 1 | 100 | 100 | 1 | 1 | 64
cov_dma ...cov_dma_state | 6 | 0 | 6 | 100 | 100 | 1 | 1 | 64
cov_uar ...cov_uart2_fifo | 5 | 0 | 5 | 100 | 100 | 1 | 1 | 64
cov_npu ...cov_npu_class | 4 | 0 | 4 | 100 | 100 | 1 | 1 | 64
cov_fau ...cov_fault_src | 2 | 0 | 2 | 100 | 100 | 1 | 1 | 64
cov_axi ...cov_axi_resp | 3 | 0 | 3 | 100 | 100 | 1 | 1 | 64

Instance Cross[es] Details : cg_inst

Name⇅ | Expected | Uncovered | Covered | Percent⇅ | Goal | Weight | At Least | Comment
cov_irq ...cov_irq_npuxcov_npu_class | 4 | 0 | 4 | 100 | 100 | 1 | 1

Cover Points

Inst cg_inst

cov_gpio cov_jtag_tms cov_axi_aw cov_axi_w cov_axi_ar cov_axi_r cov_irq_npu cov_irq_timer cov_irq_dma cov_irq_fault cov_dma_state cov_uart2_fifo cov_npu_class cov_fault_src cov_axi_resp cov_irq_npuxcov_npu_class(cross)

Details of Instance Cover Point - cg_inst :: cov_gpio

Summary of Cover Point - cov_gpio

Category | Expected | Uncovered | Covered | Percent
User Defined Bins | 5 | 0 | 5 | 100

User Generated Bins for Instance Cover Point - cg_inst :: cov_gpio
Covered bins

Name ⇅ | Hit Count ⇅ | At least
idle | 2427192 | 1
cls_yes | 4695 | 1
cls_no | 1710573 | 1
cls_sil | 1710742 | 1
cls_unk | 1692934 | 1

Details of Instance Cover Point - cg_inst :: cov_jtag_tms

Summary of Cover Point - cov_jtag_tms

Category | Expected | Uncovered | Covered | Percent
User Defined Bins | 2 | 0 | 2 | 100

User Generated Bins for Instance Cover Point - cg_inst :: cov_jtag_tms
Covered bins

Name ⇅ | Hit Count ⇅ | At least
low | 7545706 | 1
high | 430 | 1

Details of Instance Cover Point - cg_inst :: cov_axi_aw

Summary of Cover Point - cov_axi_aw

Category | Expected | Uncovered | Covered | Percent
User Defined Bins | 1 | 0 | 1 | 100

User Generated Bins for Instance Cover Point - cg_inst :: cov_axi_aw
Covered bins

Name ⇅ | Hit Count ⇅ | At least
hit | 16297 | 1

Details of Instance Cover Point - cg_inst :: cov_axi_w

Summary of Cover Point - cov_axi_w

Category | Expected | Uncovered | Covered | Percent
User Defined Bins | 1 | 0 | 1 | 100

User Generated Bins for Instance Cover Point - cg_inst :: cov_axi_w
Covered bins

Name ⇅ | Hit Count ⇅ | At least
hit | 16297 | 1

Details of Instance Cover Point - cg_inst :: cov_axi_ar

Summary of Cover Point - cov_axi_ar

Category | Expected | Uncovered | Covered | Percent
User Defined Bins | 1 | 0 | 1 | 100

User Generated Bins for Instance Cover Point - cg_inst :: cov_axi_ar
Covered bins

Name ⇅ | Hit Count ⇅ | At least
hit | 1 | 1

Details of Instance Cover Point - cg_inst :: cov_axi_r

Summary of Cover Point - cov_axi_r

Category | Expected | Uncovered | Covered | Percent
User Defined Bins | 1 | 0 | 1 | 100

User Generated Bins for Instance Cover Point - cg_inst :: cov_axi_r
Covered bins

Name ⇅ | Hit Count ⇅ | At least
hit | 1 | 1

Details of Instance Cover Point - cg_inst :: cov_irq_npu

Summary of Cover Point - cov_irq_npu

Category | Expected | Uncovered | Covered | Percent
User Defined Bins | 1 | 0 | 1 | 100

User Generated Bins for Instance Cover Point - cg_inst :: cov_irq_npu
Covered bins

Name ⇅ | Hit Count ⇅ | At least
fired | 286175 | 1

Details of Instance Cover Point - cg_inst :: cov_irq_timer

Summary of Cover Point - cov_irq_timer

Category | Expected | Uncovered | Covered | Percent
User Defined Bins | 1 | 0 | 1 | 100

User Generated Bins for Instance Cover Point - cg_inst :: cov_irq_timer
Covered bins

Name ⇅ | Hit Count ⇅ | At least
fired | 720 | 1

Details of Instance Cover Point - cg_inst :: cov_irq_dma

Summary of Cover Point - cov_irq_dma

Category | Expected | Uncovered | Covered | Percent
User Defined Bins | 1 | 0 | 1 | 100

User Generated Bins for Instance Cover Point - cg_inst :: cov_irq_dma
Covered bins

Name ⇅ | Hit Count ⇅ | At least
fired | 748 | 1

Details of Instance Cover Point - cg_inst :: cov_irq_fault

Summary of Cover Point - cov_irq_fault

Category | Expected | Uncovered | Covered | Percent
User Defined Bins | 1 | 0 | 1 | 100

User Generated Bins for Instance Cover Point - cg_inst :: cov_irq_fault
Covered bins

Name ⇅ | Hit Count ⇅ | At least
fired | 464 | 1

Details of Instance Cover Point - cg_inst :: cov_dma_state

Summary of Cover Point - cov_dma_state

Category | Expected | Uncovered | Covered | Percent
User Defined Bins | 6 | 0 | 6 | 100

User Generated Bins for Instance Cover Point - cg_inst :: cov_dma_state
Covered bins

Name ⇅ | Hit Count ⇅ | At least
idle | 3627352 | 1
read_req | 3907020 | 1
read_wait | 1960 | 1
write_req | 7840 | 1
write_wait | 1960 | 1
done | 4 | 1

Details of Instance Cover Point - cg_inst :: cov_uart2_fifo

Summary of Cover Point - cov_uart2_fifo

Category | Expected | Uncovered | Covered | Percent
User Defined Bins | 5 | 0 | 5 | 100

User Generated Bins for Instance Cover Point - cg_inst :: cov_uart2_fifo
Covered bins

Name ⇅ | Hit Count ⇅ | At least
bos | 6655129 | 1
az | 319895 | 1
orta | 65500 | 1
cok | 32000 | 1
dolu | 473612 | 1

Details of Instance Cover Point - cg_inst :: cov_npu_class

Summary of Cover Point - cov_npu_class

Category | Expected | Uncovered | Covered | Percent
User Defined Bins | 4 | 0 | 4 | 100

User Generated Bins for Instance Cover Point - cg_inst :: cov_npu_class
Covered bins

Name ⇅ | Hit Count ⇅ | At least
silence | 4306823 | 1
unknown | 1574768 | 1
yes | 112047 | 1
no | 1552498 | 1

Details of Instance Cover Point - cg_inst :: cov_fault_src

Summary of Cover Point - cov_fault_src

Category | Expected | Uncovered | Covered | Percent
User Defined Bins | 2 | 0 | 2 | 100
Illegal bin[s] | 1

User Generated Bins for Instance Cover Point - cg_inst :: cov_fault_src
Covered bins

Name ⇅ | Hit Count ⇅ | At least
yok | 7546134 | 1
veri_kopru | 2 | 1

Illegal Bins for Instance Cover Point - cg_inst :: cov_fault_src
Illegal bins

Name | Hit Count
buyruk_kopru | 0

Details of Instance Cover Point - cg_inst :: cov_axi_resp

Summary of Cover Point - cov_axi_resp

Category | Expected | Uncovered | Covered | Percent
User Defined Bins | 3 | 0 | 3 | 100

User Generated Bins for Instance Cover Point - cg_inst :: cov_axi_resp
Covered bins

Name ⇅ | Hit Count ⇅ | At least
okay | 17059 | 1
slverr | 1 | 1
decerr | 1 | 1

Details of Instance Cross Point - cg_inst :: cov_irq_npuxcov_npu_class

Samples Crossed : cov_irq_npuxcov_npu_class

Summary of Cross Point - cov_irq_npuxcov_npu_class

Category | Expected | Uncovered | Covered | Percent
Total | 4 | 0 | 4 | 100
Auto Generated Bins | 4 | 0 | 4 | 100

Automatically Generated Bins for Group Cross Point - cg_inst :: cov_irq_npuxcov_npu_class
Covered bins

cov_irq_npu | cov_npu_class | Hit Count | At least
fired | silence | 71444 | 1
fired | unknown | 71577 | 1
fired | yes | 71577 | 1
fired | no | 71577 | 1
