barisyamann/2026_Arkhe/dtr_demo/Ekran çıktısı_demo_sonucu.png

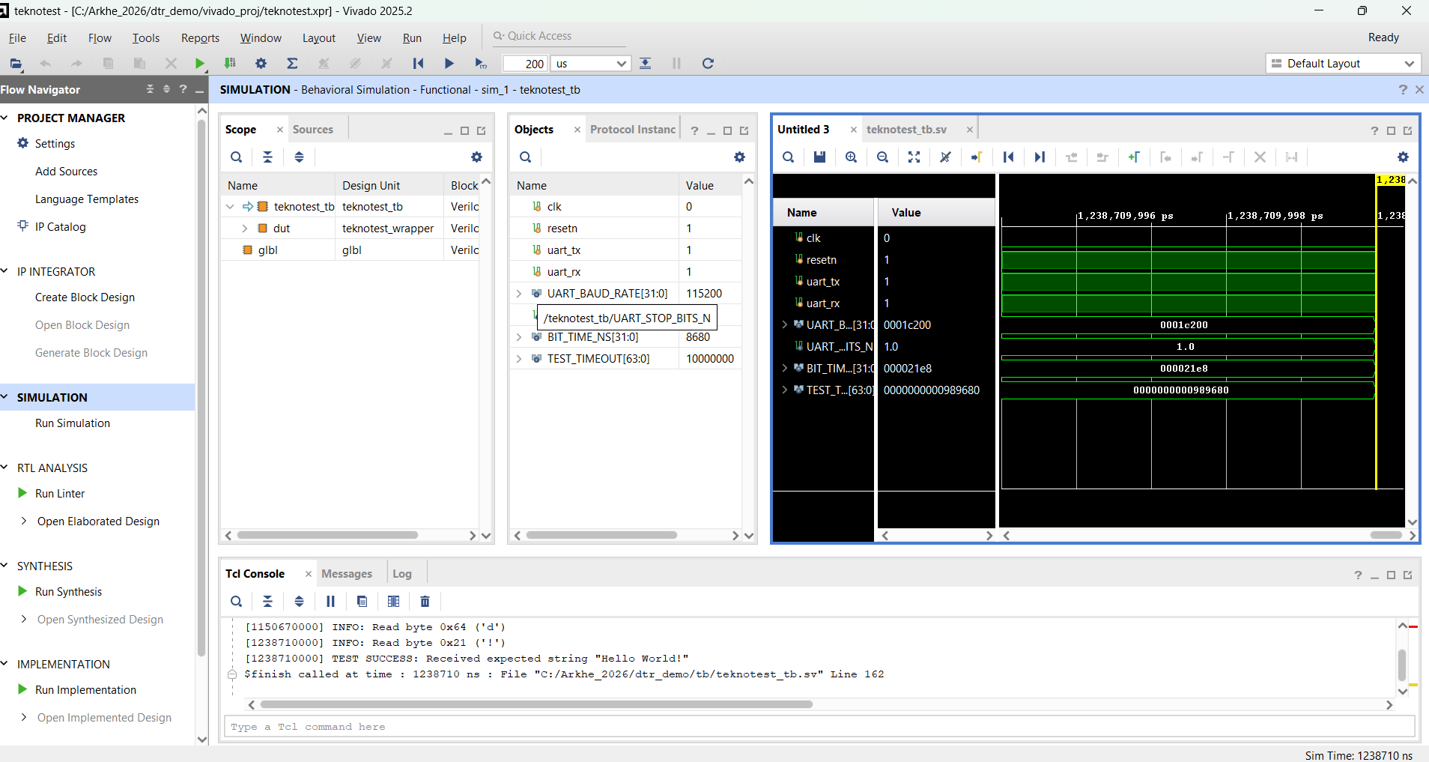
dtr_demo/Ekran çıktısı_demo_sonucu.png
