barisyamann/2026_Arkhe/sunum/arkhe_soc_top_6000px.png

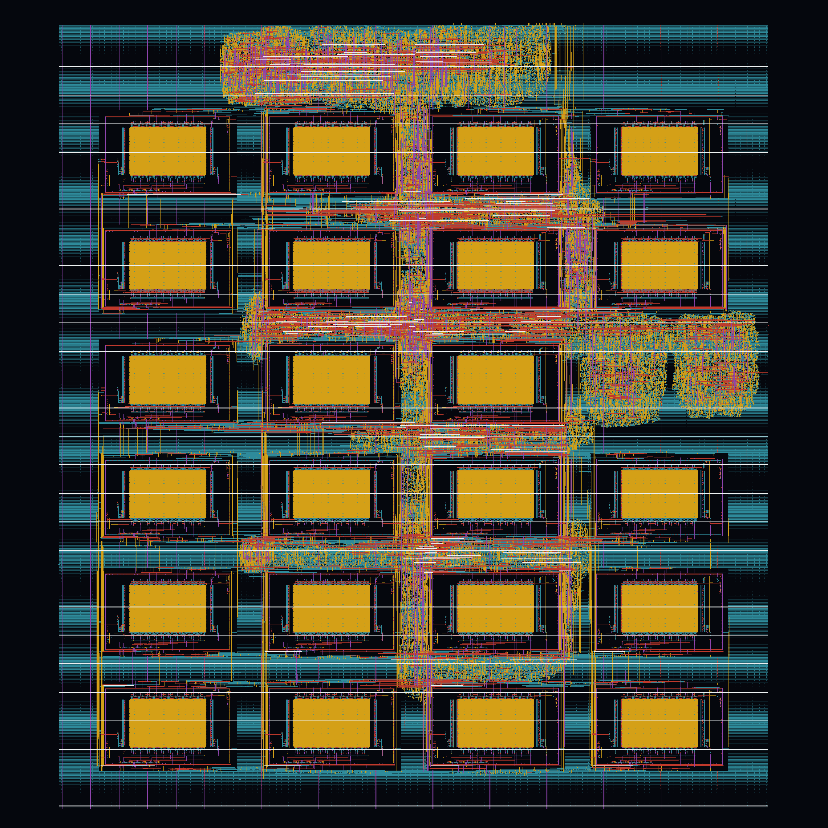
sunum/arkhe_soc_top_6000px.png
