barisyamann/2026_Arkhe/sunum/arkhe_soc_top_katmanli_5000px.png

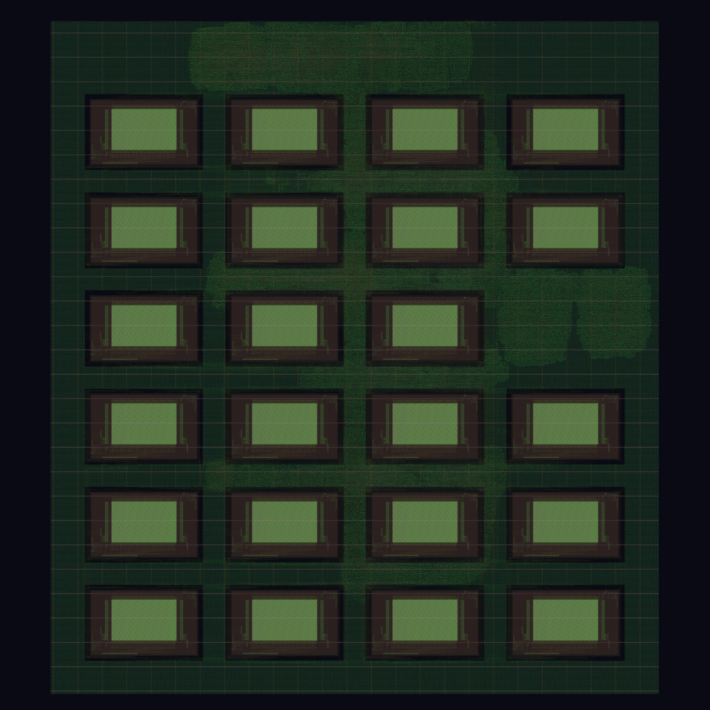
sunum/arkhe_soc_top_katmanli_5000px.png
