barisyamann/2026_Arkhe/fpga/JURI_FPGA_TESTI/build_result.txt

STATUS write_bitstream Complete!
WNS 1.397639
TNS 0.000000
WHS 0.082924
THS 0.000000
