barisyamann/2026_Arkhe/tb/T1.2_soc_system_level/T1.2_test_report.md

# T1.2: Sistem Seviyesi Entegrasyon Doğrulama Raporu

Bu rapor, Yeniden Yapılandırılmış Yapısal YZ Hızlandırıcı (NPU) ve işlemci çekirdeğinin (CV32E40P) entegre bir şekilde çalıştığı sistem seviyesi testbench ortamındaki (`tb_soc_top.sv`) doğrulama sonuçlarını belgelendirir.

---

## 1. Testin Amacı ve Kapsamı
Bu entegrasyon testinin amacı; RISC-V işlemci çekirdeği, QSPI denetleyicisi, interconnect yapısı, AXI/CSR ve NPU arasındaki veri akışı ve durum yönetim bütünlüğünü doğrulamaktır. 

Tasarımın şartname ve Ön Tasarım Raporu (ÖTR) gereksinimlerine göre otonom çalışması test edilmiş; NPU CSR bitleri, AXI bellek haberleşmeleri ve GPIO durum geçişleri izlenmiştir.

---

## 2. Doğrulama Senaryosu ve İş Akışı
Simülasyonda aşağıdaki adımlar otonom olarak gerçekleştirilmiştir:

1. **Boot ve Shadowing Aşaması:** İşlemci sıfırlamadan (Reset) kurtulduktan sonra QSPI Flash içerisine gömülü bootloader yazılımını çalıştırmıştır. QSPI RX FIFO'sundaki 24 kelimelik yapay zeka hızlandırıcı programını okuyarak veri veriyolu üzerinden **I-RAM (Instruction RAM)** bellek bölgesine kopyalamıştır.
2. **Jump ve NPU İlklendirme:** Shadowing tamamlandıktan sonra CPU, I-RAM başlangıç adresine (`0x01000000`) dallanmış (jump) ve programı I-RAM üzerinden çalıştırmaya başlamıştır.
3. **Bellek ve Tetikleme:** İşlemci, ses spektrogram girdi verisini (`0x55555555` - YES deseni) NPU TCM SRAM bellek alanının ilk kelimesine (`TCM[0] = 0x20010000`) yazmıştır. Ardından NPU CSR alanındaki `REG_CTRL` yazmacının `START` bitini (`REG_CTRL[0] = 1`) aktif ederek NPU'yu başlatmıştır.
4. **Polling ve Çıkarım Aşaması:** İşlemci, NPU'nun durumunu izlemek için `REG_STATUS` (`0x40060004`) yazmacını okumaya başlamıştır. Bu esnada NPU otonom olarak TCM bellekten verileri okumuş, ROM tabanlı ağırlıklarla DepthwiseConv2D, ReLU, FullyConnected, Softmax ve Argmax adımlarını 19.2 ms boyunca çalıştırmıştır.
5. **Sonuç Okuma ve Karar:** NPU çıkarımı tamamladığında `REG_STATUS` içindeki `DONE` bitini (`done_sticky = 1`) set etmiştir. Polling yapan CPU, durumun tamamlandığını görüp `REG_CLASS_OUT` (`0x40060010`) yazmacından çıkarım sınıfını okumuştur.
6. **GPIO Çıkışı:** Çıkarım sınıfı 2 (YES) olduğu için, işlemci `gpio_o` çıkış yazmacına `0x5555` değerini sürerek simülasyonu başarıyla sonlandırmıştır (`$finish`).

---

## 3. Simülasyon Konsol Çıktısı (Raw Trace Log)
Düzeltilen `last_pc` izleyicisi sayesinde elde edilen detaylı işlemci buyruk izleme (trace) ve donanım geçiş logları aşağıdadır:

```text
[0] SoC Simülasyonu Başlatıldı.
[0] GPIO Çıkışı Değişti: gpio_o = 16'h0000
[151000] Reset kaldırıldı. İşlemci çalışıyor...
[151000] NPU donanım motorunun tamamlanması bekleniyor...

// --- Bootloader Shadowing Aşaması (QSPI -> I-RAM) ---
[5690000] PC_ID=0x00000018 | x10(a0)=0x40050000 | ... | awaddr=0x01000038 | awvalid=0
[5730000] PC_ID=0x0000001c | x10(a0)=0x40050000 | ... | awaddr=0x01000038 | awvalid=0
[5830000] PC_ID=0x0000000c | x10(a0)=0x40050000 | ... | awaddr=0x01000038 | awvalid=0
...
[8810000] PC_ID=0x00000010 | x10(a0)=0x40050000 | ... | awaddr=0x40050008 | awvalid=0
[8830000] PC_ID=0x00000014 | x10(a0)=0x40050000 | ... | awaddr=0x40050008 | awvalid=0
[8930000] PC_ID=0x00000018 | x10(a0)=0x40050000 | ... | awaddr=0x0100005c | awvalid=0
[8970000] PC_ID=0x0000001c | x10(a0)=0x40050000 | ... | awaddr=0x0100005c | awvalid=0
[9010000] PC_ID=0x00000020 | x10(a0)=0x40050000 | ... | awaddr=0x0100005c | awvalid=0

// --- I-RAM Program Çalıştırma ve NPU Tetikleme ---
[9210000] PC_ID=0x01000000 | x10(a0)=0x40050000 | ... (I-RAM'e dallanma)
[9290000] PC_ID=0x01000004 | x10(a0)=0x40000000 | ... (GPIO Base ayarla)
[9450000] PC_ID=0x0100000c | x12(a2)=0x20010000 | ... (TCM SRAM Base ayarla)
[9610000] PC_ID=0x01000014 | x13(a3)=0x55555555 | ... (YES Girdi Verisi ayarla)
[9870000] PC_ID=0x01000020 | x10(a0)=0x40000000 | ... (GPIO MODE = Output)
[9990000] PC_ID=0x01000024 | x12(a2)=0x20010000 | ... (TCM[0] = 0x55555555 yaz)
[10010000] PC_ID=0x01000028 | x12(a2)=0x20010000 | ... (NPU REG_CTRL = 1 yaz -> Tetikle)

// --- NPU Hesaplama ve Polling Aşaması (19.2 ms) ---
[19291550000] NPU donanım motoru DONE sinyalini verdi!
[19291570000] GPIO girişleri 0xA5A5 olarak ayarlandı.

// --- Sonuç Değerlendirme ve Çıkış ---
[19291930000] PC_ID=0x01000038 | x15(a5)=0x00000002 | awaddr=0x40060004 (Durum oku - Done algılandı)
[19292030000] PC_ID=0x0100003c | x15(a5)=0x00000002 | awaddr=0x40060010 (Sınıfı oku -> Class 2)
[19292090000] PC_ID=0x01000040 | x15(a5)=0x00000002 | awaddr=0x40060010 (YES testi)
[19292250000] PC_ID=0x01000050 | x15(a5)=0x00000002 | awaddr=0x40060010 (Dallan)
[19292330000] GPIO Çıkışı Değişti: gpio_o = 16'h5555                  (GPIO çıkışı YES oldu)
[19292350000] PC_ID=0x01000054 | x10(a0)=0x40000000 | ... | awaddr=0x40000004 (GPIO ODR'ye yaz)
[19292490000] PC_ID=0x0100005c | x15(a5)=0x00000002 | awaddr=0x40000004 (Sonsuz döngü)
[19296570000] SoC Simülasyonu Tamamlandı.
```

---

## 4. Değerlendirme ve Sonuç
1. **İşlemci & NPU Eş Çalışması:** CV32E40P RISC-V işlemcisi ile NPU arasındaki kontrol (polling) ve veri haberleşmesi (TCM okuma/yazma) tam doğrulukla gerçekleşmiştir.
2. **Protokol Uyumluğu:** AXI-Lite veriyolu üzerinden yapılan CSR yazmaç erişimleri ve bellek veri transferleri sırasında hiçbir protokol hatası alınmamış, AXI denetleyicimiz (`npu_axi_controller.sv`) otonom ve sorunsuz çalışmıştır.
3. **GPIO Doğrulaması:** NPU çıkarımı tamamlandığında üretilen sınıf kararı işlemci tarafından okunmuş ve GPIO çıkışına **`16'h5555`** yansıtılarak sistem entegrasyonunun **başarılı olduğu kanıtlanmıştır.**
