barisyamann/2026_Arkhe/verification/testler/T2.1_core_trace/T2.1_test_report.md

# T2.1: Çekirdek Komut İzleme (Core Trace) Doğrulama Raporu

Bu rapor, RISC-V işlemci çekirdeğinin (CV32E40P) simülasyon sırasında yürüttüğü buyrukların (PC, register durumları ve bellek erişimleri) anlık takibiyle (Core Trace) gerçekleştirilen doğrulama sonuçlarını belgelendirir.

---

## 1. Testin Amacı ve Kapsamı
Bu doğrulama adımının amacı; işlemcinin bootloader ROM kodunu ve YZ Hızlandırıcı programını tam olarak doğru sırada, dallanma ve atlama hataları olmadan koşturup koşturmadığını kontrol etmektir. 

İzleme (trace) işlemi, simülasyondaki belirsizliklerin (X-propagation) ve yazılım hatalarının erken tespiti açısından kritik öneme sahiptir.

---

## 2. Doğrulama Metodolojisi ve İzleme Yapısı
* **İzleme Mekanizması:** [tb_soc_top.sv](file:///c:/Arkhe_2026/tb/tb_soc_top.sv) testbench dosyası içerisinde yer alan izleme bloğu, her saat çevriminde işlemci çekirdeğinin iç registers dosyasını (`register_file_i.mem`) ve o anki PC adresini (`pc_id_i`) takip eder.
* **Log Filtreleme:** Simülasyon loglarının kirlenmesini önlemek amacıyla, NPU'nun tamamlanmasını bekleyen polling döngüsü adresleri (`0x0100002c`, `0x01000030`, `0x01000034`) loglama dışında tutulmuştur.
* **İzlenen Sinyaller:** PC (Program Counter), `x10 (a0)`, `x12 (a2)`, `x13 (a3)`, `x14 (a4)`, `x15 (a5)` yazmaçları, AXI adresi (`awaddr`) ve QSPI FIFO durumları.

---

## 3. Komut Çalışma Akışı Analizi

Simülasyon loglarından elde edilen önemli işlem adımları ve karşılık gelen assembly komutları şunlardır:

### 3.1. QSPI'den I-RAM'e Shadowing Aşaması (Bootloader)
CPU, `0x00000000` başlangıç adresinden boot edip QSPI FIFO'sundan gelen AI hızlandırıcı kodunu I-RAM'e yazar:
* `[5690000] PC_ID=0x00000018 ... awaddr=0x01000038` -> Bootloader, I-RAM'in `0x01000038` adresine bir buyruk kopyalıyor.
* `[8810000] PC_ID=0x00000010 ... awaddr=0x40050008` -> QSPI FIFO'dan yeni kelime okuma (okuma pointer'ı güncelleniyor: `rx_rd=24`).
* `[9070000] PC_ID=0x00000024 ...` -> Shadowing işlemi biter ve I-RAM başlangıcına dallanır.

### 3.2. Ana AI Programının Koşturulması
* `[9210000] PC_ID=0x01000000` -> `0x01000000` adresindeki ilk program buyruğu çalıştırılıyor.
* `[9290000] PC_ID=0x01000004` -> `x10(a0)` yazmacına `0x40000000` (GPIO Base) adresi yükleniyor (`lui a0, 0x40000`).
* `[9450000] PC_ID=0x0100000c` -> `x12(a2)` yazmacına `0x20010000` (TCM Base) adresi yükleniyor (`lui a2, 0x20010`).
* `[9610000] PC_ID=0x01000014` -> `x13(a3)` yazmacına YES girdi deseni `0x55555555` yükleniyor (`addi a3, a3, 0x555`).
* `[9870000] PC_ID=0x01000020` -> `a3` değeri `GPIO_MODE` yazmacına (`awaddr=0x40000008`) yazılıyor. Tüm GPIO pinleri output olarak ayarlanıyor.
* `[9990000] PC_ID=0x01000024` -> `a3` değeri `TCM[0]` adresine (`awaddr=0x20010000`) yazılıyor (NPU Spektrogram girdisi).
* `[10010000] PC_ID=0x01000028` -> `a5` yazmacına `1` yüklenip `NPU_CSR` `REG_CTRL` adresine yazılıyor (NPU başlatılıyor).

### 3.3. NPU Polling ve Bitiş Kontrolü
* NPU çalışırken CPU polling döngüsüne girer.
* `[19291930000] PC_ID=0x01000038` -> Polling döngüsünden çıkılır. Durum registerından `class_in` değeri `2` (YES) olarak okunur (`x15(a5)=2`).
* `[19292030000] PC_ID=0x0100003c` -> Sınıf 2 karşılaştırması yapılır (`beq a5, t3, 16`).
* `[19292250000] PC_ID=0x01000050` -> Koşul sağlandığı için GPIO ODR güncelleme bloğuna dallanır.
* `[19292350000] PC_ID=0x01000054` -> GPIO çıkışına `0x5555` yazılır (`awaddr=0x40000004`).
* `[19292490000] PC_ID=0x0100005c` -> Sonsuz döngüye girilir (`jal zero, 0`).

---

## 4. Buyruk İzi Denetimi — Derlenmiş Programla Karşılaştırma

### 4.1 Önceki sürümün geri çekilmesi

Bu bölüm daha önce **"Spike ISS Referans Model Uyumluluk Karşılaştırması"**
başlığını taşıyordu ve `compare_trace.py` betiğinin çıktısını sunuyordu.
Denetim sırasında bu iddianın **dayanaksız** olduğu tespit edilmiştir:

* Spike ISS **hiçbir zaman kurulmadı ve koşturulmadı.** Betiğin "referans
  model" dediği şey, kaynak kodun içine elle yazılmış 20 elemanlı sabit bir
  adres dizisiydi (`reference_trace = [...]`).
* Dizi güncel bootloader ile **uyuşmuyordu.** `bootloader.S` içinde `0x08` ve
  `0x0a` adreslerindeki `li` buyrukları RV32C ile **2 bayta sıkıştırılmıştır**;
  sabit dizi her buyruğu 4 bayt varsayarak `0x0a`'yı tamamen atlıyordu.

İkinci madde ölçülebilir: yeni denetleyiciye eski dizi verildiğinde reddediliyor.

```text
[2] 0x00000008 (li) -> 0x0000000c  beklenmeyen gecis
[HATA] 1 tutarsizlik.
```

Bu nedenle `compare_trace.py` kaldırılmış, yerine referansı uydurmayan bir
denetleyici konmuştur.

### 4.2 Yeni yöntem — `trace_check.py`

Karşılaştırma noktası artık elle yazılmış bir dizi değil, **CPU'nun koşması
beklenen programın kendisidir.** Betik `bootloader.elf` dosyasını
`riscv-none-elf-objdump` ile ayrıştırır ve simülasyon izindeki her PC için
iki şeyi denetler:

| # | Denetim | Yakaladığı hata |
|---|---|---|
| 1 | Yürütülen PC, programda gerçekten var olan bir buyruk adresi mi? | Hizasız getirme, ölü adrese sıçrama, bozuk PC |
| 2 | Ardışık PC çifti meşru bir geçiş mi? (`pc + uzunluk`, ya da disassembly'deki dal hedefi) | Kaçırılan buyruk, yanlış dal hedefi, sıkıştırılmış buyruk hatası |

Buyruk uzunluğu disassembly'deki kodlama alanından okunur, dolayısıyla
2 baytlık RV32C buyrukları doğru ele alınır. `jr`/`jalr`/`ret`/`mret` gibi
hedefi yazmaçtan gelen atlamalarda 2. denetim uygulanamaz; bu durumda
1. denetim geçerlidir.

### 4.3 Denetleyicinin kendi doğrulaması

Betiğin gerçekten hata yakaladığı üç sentetik iz ile gösterilmiştir:

| İz | Beklenen | Sonuç |
|---|---|---|
| Sıralı + dal alınmış + dal alınmamış (meşru) | geçer | ✅ çıkış 0 |
| Sıkıştırılmış buyruğu atlayan (eski sabit dizi) | reddedilir | ✅ çıkış 1 |
| Programda olmayan `0xABCD` adresine sıçrama | reddedilir | ✅ çıkış 1 |

### 4.4 Koşum

İz toplama varsayılan olarak kapalıdır (her çevrim yazdırmak simülasyonu
yavaşlatır). Açmak için Vivado'da `TRACE_ON` tanımlanır:

> Simulation Settings → Verilog Options → Defines → `TRACE_ON`

```bash
python tb/T2.1_core_trace/trace_check.py
```

Betik çıkış kodu döndürür: `0` tutarlı, `1` tutarsızlık, `2` dosya/araç eksik.

### 4.5 Kapsam sınırı — açıkça belirtilir

Bu denetim **kontrol akışını** doğrular: hangi buyruğun yürütüldüğünü ve
hangi sırayla. **Yazmaç ve bellek değerlerinin aritmetik doğruluğunu
denetlemez** — bunun için gerçek bir ISS (Spike) karşılaştırması gerekir.

Aritmetik doğruluk projede ayrı bir yoldan sağlanmaktadır: NPU çıkarım
sonuçları ve çevre birimi davranışları 6 blok testi ve tam sistem
regresyonunda (77 denetim, 0 hata) beklenen değerlerle karşılaştırılır.
Bir aritmetik hata bu testlerde sonucu değiştirirdi.

ÖTR'de Spike karşılaştırması taahhüt edilmişti; bu taahhüt
**yerine getirilmemiştir** ve rapor artık bunu gizlemek yerine
belirtmektedir.

---

## 5. Değerlendirme ve Sonuç
İşlemci komut izleme (Core Trace) analizi sonucunda:
1. Bootloader'ın kod kopyalama (shadowing) mantığının adres kayması olmadan çalıştığı,
2. İşlemcinin yazmaç dosyasındaki (`x10`, `x12`, `x13`, `x14`, `x15`) veri güncellemelerinin assembly komutlarıyla eşleştiği,
3. Yürütülen bütün PC'lerin derlenmiş programın geçerli buyruk adresleri olduğu ve geçersiz/tanımsız buyruk (Illegal Instruction) tetiklenmediği

doğrulanmıştır.

**Kapsam:** kontrol akışı doğrulanmıştır; aritmetik sonuç doğruluğu bu
testin kapsamı dışındadır (bkz. 4.5). Spike ISS karşılaştırması
yapılmamıştır.
