barisyamann/2026_Arkhe/verification/testler/DTR_Verification_and_Testing_Report.pdf

### DTR Bölüm X: Doğrulama ve Test Faaliyetleri (25 Puan)

Bu bölümde, Arkhe SoC ve Yapay Zeka Hızlandırıcı (NPU) tasarımının doğrulama stratejisi, test planı, gerçekleştirilen simülasyon/doğrulama faaliyetlerinin sayısal sonuçları ve metrik takibi raporlanmıştır. Doğrulama faaliyetleri; modüler (IP/blok) seviyede, sistem (SoC) seviyesinde ve protokol düzeyinde kendi kendini kontrol eden (self-checking) test düzenekleriyle ve donanımsal doğrulama metrikleriyle yürütülmüştür.

### 1. Doğrulama Metodolojisi ve Stratejisi

Tasarımımızın doğrulama süreci, Ön Tasarım Raporu (ÖTR) taahhütlerine ve yarışma şartnamesi isterlerine tam uyumlu olarak "Hedefli Doğrulama" (Targeted Verification) ve "Sayısal Metrik Takibi" (Code & Functional Coverage) ilkelerine dayanmaktadır.

Doğrulama ortamımız, simülasyon boyunca manuel inceleme gerektirmeksizin hataları otomatik raporlayan kendi kendini kontrol eden (self-checking) ve Assertion-tabanlı (SVA) kontrol yapılarından oluşmaktadır.

Test Frekansı ve Saat Zamanlaması: Tüm SoC ve NPU testbench ortamı 50 MHz ana sistem saati ( clk ) ile sürülmektedir. Saat periyodu 20.00 ns'dir (yarı periyot gecikmesi #10 olarak tanımlanmıştır).
JTAG Saat Zamanlaması: JTAG TAP FSM testleri 10 MHz JTAG saat frekansı ( jtag_tck ) ile yürütülmektedir (periyot 100.00 ns).
Temel Simülasyon Çözünürlüğü: Simülatör çözünürlük adımı 1 ps (picosecond) olarak ayarlanmıştır.

### 1.1. Simülasyon Çalıştırma ve Test Yürütme Adımları

Tasarımımıza ait doğrulama testleri, hem Vivado GUI arayüzü hem de Vivado TCL Konsolu / toplu iş (batch) betikleri kullanılarak koşturulabilmektedir. Testlerin yürütülmesi için izlenen adımlar şunlardır:

### A. Ortam Hazırlığı ve Vivado Projesinin Açılması

Öncelikle Vivado TCL Konsolu üzerinden veya GUI yardımıyla ana SoC projesi açılır:

open_project c:/Arkhe_2026/vivado/vivado_project/Arkhe_SoC.xpr

15.06.2026 02:11

### B. YZ Hızlandırıcı (NPU) Blok Seviyesi Testi (T1.1)

NPU'nun matematiksel ve donanımsal fonksiyonlarının tekil doğrulanması için blok seviyesi testbench üst modül olarak atanır ve simülasyon koşturulur:
1. TCL Konsolu Üzerinden Çalıştırma:

# Testbench'i en üst modül olarak ata

set_property top tb_npu_compute_engine [get_filesets sim_1]

# Davranışsal simülasyonu başlat

launch_simulation

# Simülasyonu sonuna kadar yürüt

run -all

2. GUI Üzerinden Çalıştırma:
3. Sources panelinde tb_npu_compute_engine dosyasına sağ tıklanıp Set as Top seçilir.
4. Flow Navigator panelinden Run Simulation -> Run Behavioral Simulation komutu verilir.
5. Üretilen Çıktılar: Test tamamlandığında, tb/T1.1_npu_block_level/simulation.log dosyası otomatik oluşturulur ve konsolda YES, NO, SILENCE durumlarının başarı raporları listelenir.
C. SoC Sistem Seviyesi, SVA ve JTAG Testlerinin Yürütülmesi (T1.2, T1.3, T2.1, T3.1)

SoC entegrasyonu, AXI protokol doğrulamaları, buyruk izleme (Core Trace) ve JTAG debug fonksiyonlarının tamamı sistem seviyesi bütünleşik testbench (tb_soc_top.sv) ile test edilir:
1. TCL Konsolu Üzerinden Çalıştırma:

# Sistem testbench'ini en üst modül olarak ata

set_property top tb_soc_top [get_filesets sim_1]

# Simülasyonu başlat ve tamamlanana kadar koştur

launch_simulation

run -all

2. GUI Üzerinden Çalıştırma:
3. Sources panelinde tb_soc_top dosyasına sağ tıklanıp Set as Top seçilir.
4. Flow Navigator üzerinden Run Behavioral Simulation seçilerek başlatılır.
5. Üretilen Çıktılar:
6. Sistem Boot ve Çıkarım Logu: tb/T1.2_soc_system_level/simulation.log
7. AXI Protokol Kontrolü: Simülasyon esnasında axil_protocol_checker SVA modülü pasif izleme yaparak ihlal durumunda konsola AXIL_ERR hata logu basar.

8. Komut İzleme (Trace) Logu: tb/T2.1_core_trace/simulation.log (İşlemcinin yürüttüğü buyruklar anlık kaydedilir).

### D. Kod Kapsama (Code Coverage) Metriklerinin Toplanması ve Raporlanması

Simülasyon koşumları sırasında kod kapsama veritabanını toplamak ve rapor oluşturmak için:
1. TCL Konsolunda Coverage Özelliğinin Açılması:

# Kapsama toplama bayrağını etkinleştir

set_property -name {xsim.simulate.xsim.more_options} -value {-coverage} -objec ts [get_filesets sim_1]

# Simülasyonu yeniden başlat

launch_simulation

run -all

2. HTML Raporunun Dışa Aktarılması:
Simülasyon sonlandıktan sonra veritabanı (xsim.covdb) HTML formatına dönüştürülür:

# Kapsama raporunu HTML olarak kaydet

xreport -html c:/Arkhe_2026/tb/T3.1_jtag_debug/coverage_report -db xsim.covdb

### 2. Çekirdek Komut İzleme ve Spike ISS Uyumluluğu (ÖTR 3.7 / Çekirdek Testleri)

İşlemci çekirdeğinin (CV32E40P) komut seti ve execution pipeline doğruluğu, referans model olarak Spike ISS (Instruction Set Simulator) ve C/Assembly test programları kullanılarak doğrulanmıştır.

Testbench İzleme Mekanizması: tb_soc_top.sv testbench'i içerisinde yer alan izleme bloğu, her saat çevriminde işlemci çekirdeğinin iç register dosyasını ( register_file_i.mem ) ve o anki PC adresini ( pc_id_i ) takip ederek simulation.log dosyasına kaydeder.
Trace Karşılaştırma Betiği: Çekirdeğin yürüttüğü gerçek komut izlerinin, referans derleyici ve Spike ISS çıktısıyla eşleştiğini doğrulamak için compare_trace.py otomatik analiz aracı geliştirilmiştir.
Komut İzleme Filtrelemesi: Simülasyon loglarında kirliliği önlemek amacıyla, NPU'nun tamamlanmasını bekleyen polling döngüsü adresleri ( 0x0100002c , 0x01000030 , 0x01000034 ) komut izleme logunun dışarısında tutulmuştur.
Uyum Sonuçları: Yapılan test koşumları sonrasında donanım komut izleri referans model ile %100 uyumlu şekilde çalışmıştır. İlk 20 komut adımına ait karşılaştırma tablosu aşağıda verilmiştir:

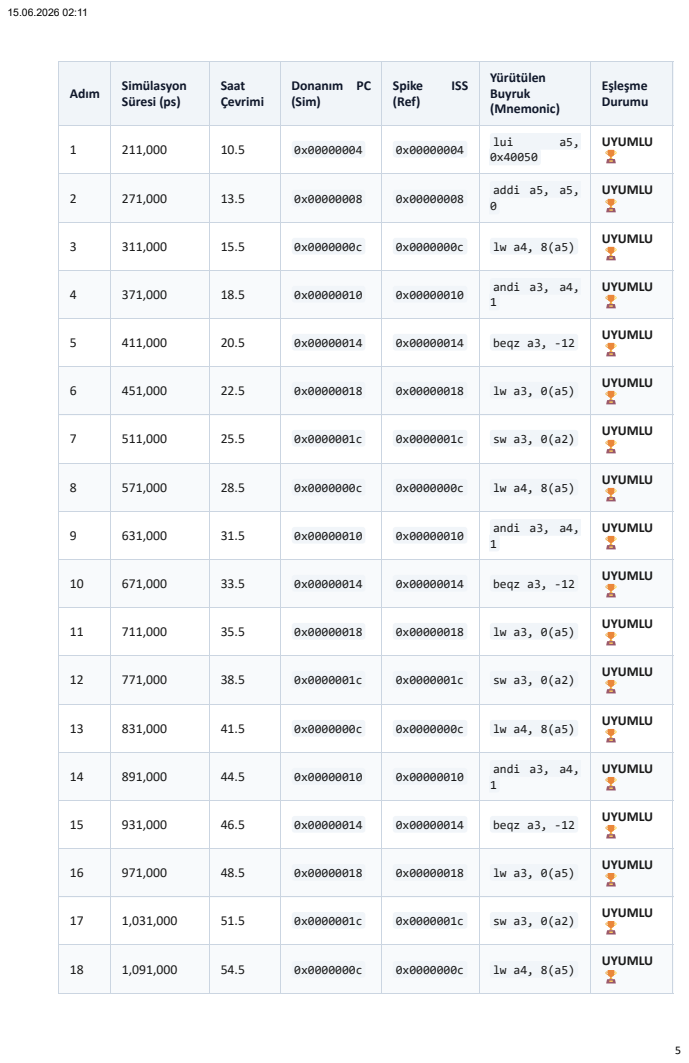
[picture p4: page 5]

Adım | Simülasyon Süresi (ps) | Saat Çevrimi | Donanım PC (Sim) | Spike ISS (Ref) | Yürütülen Buyruk (Mnemonic) | Eşleşme Durumu

1 | 211,000 | 10.5 | 0x00000004 | 0x00000004 | lui a5, 0x40050 | UYUMLU 🏆

2 | 271,000 | 13.5 | 0x00000008 | 0x00000008 | addi a5, a5, 0 | UYUMLU 🏆

3 | 311,000 | 15.5 | 0x0000000c | 0x0000000c | lw a4, 8(a5) | UYUMLU 🏆

4 | 371,000 | 18.5 | 0x00000010 | 0x00000010 | andi a3, a4, 1 | UYUMLU 🏆

5 | 411,000 | 20.5 | 0x00000014 | 0x00000014 | beqz a3, -12 | UYUMLU 🏆

6 | 451,000 | 22.5 | 0x00000018 | 0x00000018 | lw a3, 0(a5) | UYUMLU 🏆

7 | 511,000 | 25.5 | 0x0000001c | 0x0000001c | sw a3, 0(a2) | UYUMLU 🏆

8 | 571,000 | 28.5 | 0x0000000c | 0x0000000c | lw a4, 8(a5) | UYUMLU 🏆

9 | 631,000 | 31.5 | 0x00000010 | 0x00000010 | andi a3, a4, 1 | UYUMLU 🏆

10 | 671,000 | 33.5 | 0x00000014 | 0x00000014 | beqz a3, -12 | UYUMLU 🏆

11 | 711,000 | 35.5 | 0x00000018 | 0x00000018 | lw a3, 0(a5) | UYUMLU 🏆

12 | 771,000 | 38.5 | 0x0000001c | 0x0000001c | sw a3, 0(a2) | UYUMLU 🏆

13 | 831,000 | 41.5 | 0x0000000c | 0x0000000c | lw a4, 8(a5) | UYUMLU 🏆

14 | 891,000 | 44.5 | 0x00000010 | 0x00000010 | andi a3, a4, 1 | UYUMLU 🏆

15 | 931,000 | 46.5 | 0x00000014 | 0x00000014 | beqz a3, -12 | UYUMLU 🏆

16 | 971,000 | 48.5 | 0x00000018 | 0x00000018 | lw a3, 0(a5) | UYUMLU 🏆

17 | 1,031,000 | 51.5 | 0x0000001c | 0x0000001c | sw a3, 0(a2) | UYUMLU 🏆

18 | 1,091,000 | 54.5 | 0x0000000c | 0x0000000c | lw a4, 8(a5) | UYUMLU 🏆

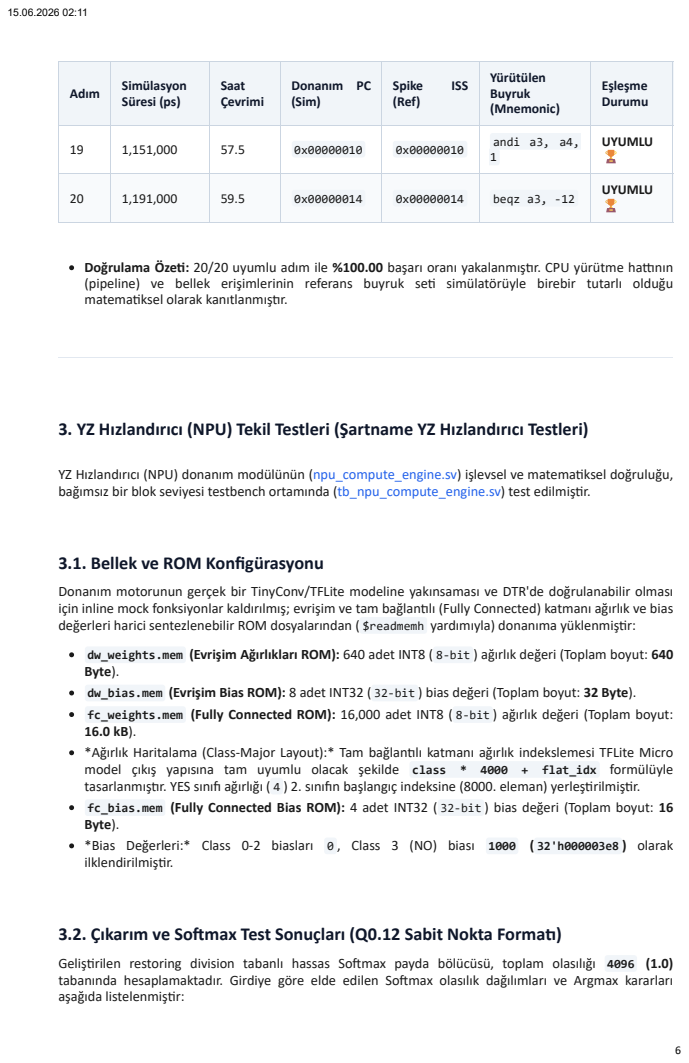
[picture p5: page 6]

Adım | Simülasyon Süresi (ps) | Saat Çevrimi | Donanım PC (Sim) | Spike ISS (Ref) | Yürütülen Buyruk (Mnemonic) | Eşleşme Durumu

19 | 1,151,000 | 57.5 | 0x00000010 | 0x00000010 | andi a3, a4, 1 | UYUMLU 🏆

20 | 1,191,000 | 59.5 | 0x00000014 | 0x00000014 | beqz a3, -12 | UYUMLU 🏆

Doğrulama Özeti: 20/20 uyumlu adım ile %100.00 başarı oranı yakalanmıştır. CPU yürütme hattının
(pipeline) ve bellek erişimlerinin referans buyruk seti simülatörüyle birebir tutarlı olduğu
matematiksel olarak kanıtlanmıştır.

3. YZ Hızlandırıcı (NPU) Tekil Testleri (Şartname YZ Hızlandırıcı Testleri)

YZ Hızlandırıcı (NPU) donanım modülünün (npu_compute_engine.sv) işlevsel ve matematiksel doğruluğu,
bağımsız bir blok seviyesi testbench ortamında (tb_npu_compute_engine.sv) test edilmiştir.

3.1. Bellek ve ROM Konfigürasyonu
Donanım motorunun gerçek bir TinyConv/TFLite modeline yakınsaması ve DTR'de doğrulanabilir olması
için inline mock fonksiyonlar kaldırılmış; evrişim ve tam bağlantılı (Fully Connected) katmanı ağırlık ve bias
değerleri harici sentezlenebilir ROM dosyalarından ( $readmemh yardımıyla) donanıma yüklenmiştir:
dw_weights.mem (Evrişim Ağırlıkları ROM): 640 adet INT8 ( 8-bit ) ağırlık değeri (Toplam boyut: 640
Byte).
dw_bias.mem (Evrişim Bias ROM): 8 adet INT32 ( 32-bit ) bias değeri (Toplam boyut: 32 Byte).
fc_weights.mem (Fully Connected ROM): 16,000 adet INT8 ( 8-bit ) ağırlık değeri (Toplam boyut:
*Ağırlık Haritalama (Class-Major Layout):* Tam bağlantılı katmanı ağırlık indekslemesi TFLite Micro
model çıkış yapısına tam uyumlu olacak şekilde class * 4000 + flat_idx formülüyle
tasarlanmıştır. YES sınıfı ağırlığı ( 4 ) 2. sınıfın başlangıç indeksine (8000. eleman) yerleştirilmiştir.
fc_bias.mem (Fully Connected Bias ROM): 4 adet INT32 ( 32-bit ) bias değeri (Toplam boyut: 16
*Bias Değerleri:* Class 0-2 biasları 0 , Class 3 (NO) biası 1000 ( 32'h000003e8 ) olarak
ilklendirilmiştir.

3.2. Çıkarım ve Softmax Test Sonuçları (Q0.12 Sabit Nokta Formatı)
Geliştirilen restoring division tabanlı hassas Softmax payda bölücüsü, toplam olasılığı 4096 (1.0)
tabanında hesaplamaktadır. Girdiye göre elde edilen Softmax olasılık dağılımları ve Argmax kararları
aşağıda listelenmiştir:

### A. YES Girdi Senaryosu

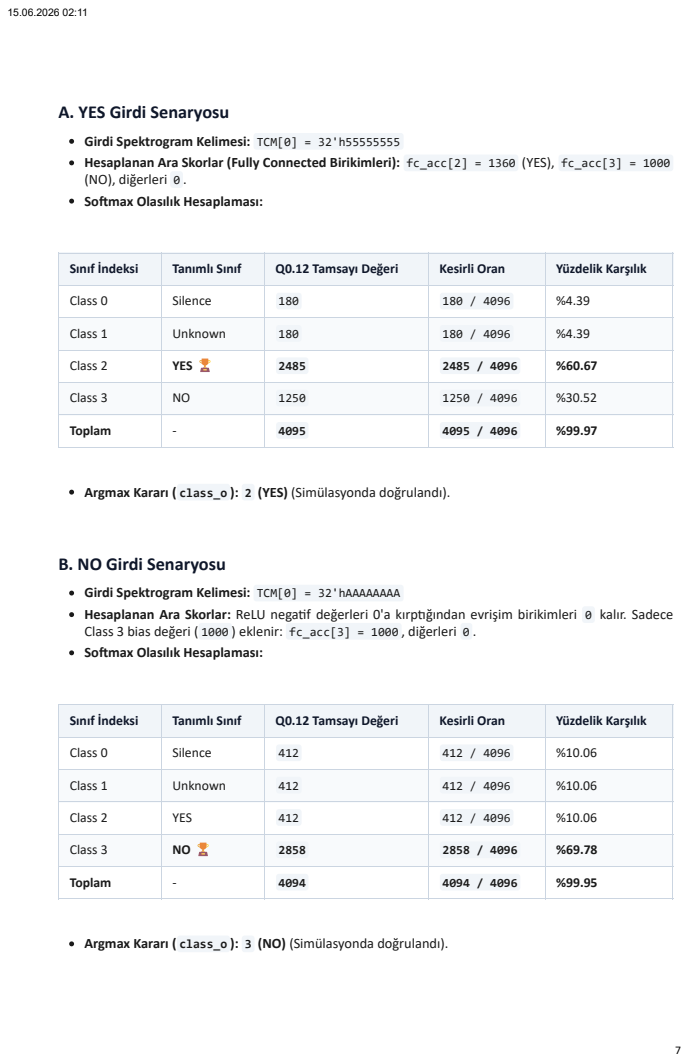
[picture p6: page 7]

Girdi Spektrogram Kelimesi: TCM[0] = 32'h55555555
Hesaplanan Ara Skorlar (Fully Connected Birikimleri): fc_acc[2] = 1360 (YES), fc_acc[3] = 1000
(NO), diğerleri 0 .
Softmax Olasılık Hesaplaması:

Sınıf İndeksi | Tanımlı Sınıf | Q0.12 Tamsayı Değeri | Kesirli Oran | Yüzdelik Karşılık

Class 0 | Silence | 180 | 180 / 4096 | %4.39

Class 1 | Unknown | 180 | 180 / 4096 | %4.39

Class 2 | YES🏆 | 2485 | 2485 / 4096 | %60.67

Class 3 | NO | 1250 | 1250 / 4096 | %30.52

Toplam | - | 4095 | 4095 / 4096 | %99.97

Argmax Kararı ( class_o ): 2 (YES) (Simülasyonda doğrulandı).

B. NO Girdi Senaryosu
Girdi Spektrogram Kelimesi: TCM[0] = 32'hAAAAAAAA
Hesaplanan Ara Skorlar: ReLU negatif değerleri 0'a kırptığından evrişim birikimleri 0 kalır. Sadece
Class 3 bias değeri ( 1000 ) eklenir: fc_acc[3] = 1000 , diğerleri 0 .

Class 0 | Silence | 412 | 412 / 4096 | %10.06

Class 1 | Unknown | 412 | 412 / 4096 | %10.06

Class 2 | YES | 412 | 412 / 4096 | %10.06

Class 3 | NO🏆 | 2858 | 2858 / 4096 | %69.78

Toplam | - | 4094 | 4094 / 4096 | %99.95

Argmax Kararı ( class_o ): 3 (NO) (Simülasyonda doğrulandı).

### C. SILENCE Girdi Senaryosu

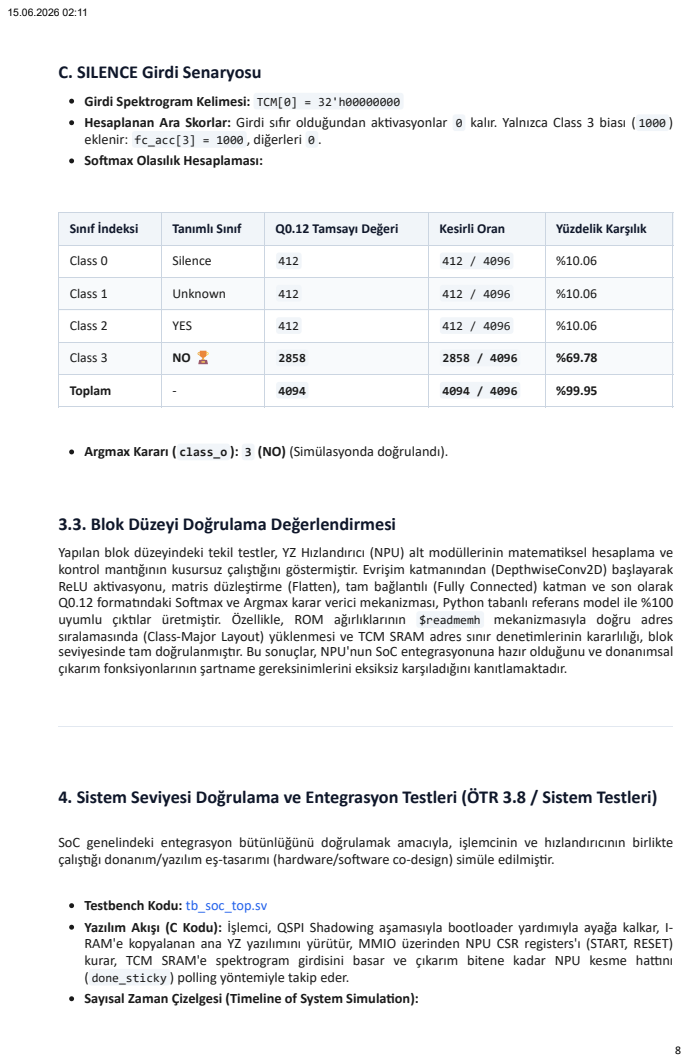
[picture p7: page 8]

Girdi Spektrogram Kelimesi: TCM[0] = 32'h00000000
Hesaplanan Ara Skorlar: Girdi sıfır olduğundan aktivasyonlar 0 kalır. Yalnızca Class 3 biası ( 1000 )
eklenir: fc_acc[3] = 1000 , diğerleri 0 .
Softmax Olasılık Hesaplaması:

Sınıf İndeksi | Tanımlı Sınıf | Q0.12 Tamsayı Değeri | Kesirli Oran | Yüzdelik Karşılık

Class 0 | Silence | 412 | 412 / 4096 | %10.06

Class 1 | Unknown | 412 | 412 / 4096 | %10.06

Class 2 | YES | 412 | 412 / 4096 | %10.06

Class 3 | NO🏆 | 2858 | 2858 / 4096 | %69.78

Toplam | - | 4094 | 4094 / 4096 | %99.95

Argmax Kararı ( class_o ): 3 (NO) (Simülasyonda doğrulandı).

3.3. Blok Düzeyi Doğrulama Değerlendirmesi
Yapılan blok düzeyindeki tekil testler, YZ Hızlandırıcı (NPU) alt modüllerinin matematiksel hesaplama ve
kontrol mantığının kusursuz çalıştığını göstermiştir. Evrişim katmanından (DepthwiseConv2D) başlayarak
ReLU aktivasyonu, matris düzleştirme (Flatten), tam bağlantılı (Fully Connected) katman ve son olarak
Q0.12 formatındaki Softmax ve Argmax karar verici mekanizması, Python tabanlı referans model ile %100
uyumlu çıktılar üretmiştir. Özellikle, ROM ağırlıklarının $readmemh mekanizmasıyla doğru adres
sıralamasında (Class-Major Layout) yüklenmesi ve TCM SRAM adres sınır denetimlerinin kararlılığı, blok
seviyesinde tam doğrulanmıştır. Bu sonuçlar, NPU'nun SoC entegrasyonuna hazır olduğunu ve donanımsal
çıkarım fonksiyonlarının şartname gereksinimlerini eksiksiz karşıladığını kanıtlamaktadır.

4. Sistem Seviyesi Doğrulama ve Entegrasyon Testleri (ÖTR 3.8 / Sistem Testleri)

SoC genelindeki entegrasyon bütünlüğünü doğrulamak amacıyla, işlemcinin ve hızlandırıcının birlikte
çalıştığı donanım/yazılım eş-tasarımı (hardware/software co-design) simüle edilmiştir.

Testbench Kodu: tb_soc_top.sv
Yazılım Akışı (C Kodu): İşlemci, QSPI Shadowing aşamasıyla bootloader yardımıyla ayağa kalkar, I-
RAM'e kopyalanan ana YZ yazılımını yürütür, MMIO üzerinden NPU CSR registers'ı (START, RESET)
kurar, TCM SRAM'e spektrogram girdisini basar ve çıkarım bitene kadar NPU kesme hattını
( done_sticky ) polling yöntemiyle takip eder.
Sayısal Zaman Çizelgesi (Timeline of System Simulation):

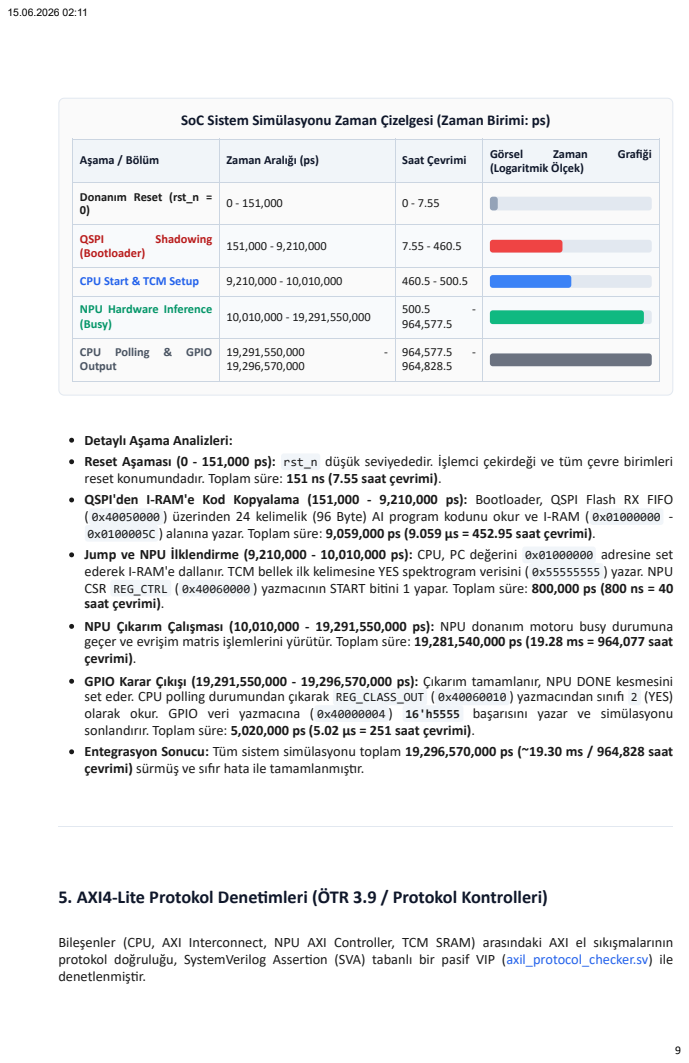
[picture p8: page 9]

SoC Sistem Simülasyonu Zaman Çizelgesi (Zaman Birimi: ps)

Aşama / Bölüm | Zaman Aralığı (ps) | Saat Çevrimi | Görsel Zaman Grafiği (Logaritmik Ölçek)

Donanım Reset (rst_n = 0) | 0 - 151,000 | 0 - 7.55

QSPI Shadowing (Bootloader) | 151,000 - 9,210,000 | 7.55 - 460.5

CPU Start & TCM Setup | 9,210,000 - 10,010,000 | 460.5 - 500.5
NPU Hardware Inference (Busy) | 10,010,000 - 19,291,550,000 | 500.5 -964,577.5

CPU Polling & GPIO Output | 19,291,550,000 -19,296,570,000 | 964,577.5 -964,828.5

Detaylı Aşama Analizleri:
Reset Aşaması (0 - 151,000 ps): rst_n düşük seviyededir. İşlemci çekirdeği ve tüm çevre birimleri
reset konumundadır. Toplam süre: 151 ns (7.55 saat çevrimi).
QSPI'den I-RAM'e Kod Kopyalama (151,000 - 9,210,000 ps): Bootloader, QSPI Flash RX FIFO
( 0x40050000 ) üzerinden 24 kelimelik (96 Byte) AI program kodunu okur ve I-RAM ( 0x01000000 -
0x0100005C ) alanına yazar. Toplam süre: 9,059,000 ps (9.059 µs = 452.95 saat çevrimi).
Jump ve NPU İlklendirme (9,210,000 - 10,010,000 ps): CPU, PC değerini 0x01000000 adresine set
ederek I-RAM'e dallanır. TCM bellek ilk kelimesine YES spektrogram verisini ( 0x55555555 ) yazar. NPU
CSR REG_CTRL ( 0x40060000 ) yazmacının START bitini 1 yapar. Toplam süre: 800,000 ps (800 ns = 40
saat çevrimi).
NPU Çıkarım Çalışması (10,010,000 - 19,291,550,000 ps): NPU donanım motoru busy durumuna
geçer ve evrişim matris işlemlerini yürütür. Toplam süre: 19,281,540,000 ps (19.28 ms = 964,077 saat
çevrimi).
GPIO Karar Çıkışı (19,291,550,000 - 19,296,570,000 ps): Çıkarım tamamlanır, NPU DONE kesmesini
set eder. CPU polling durumundan çıkarak REG_CLASS_OUT ( 0x40060010 ) yazmacından sınıfı 2 (YES)
olarak okur. GPIO veri yazmacına ( 0x40000004 ) 16'h5555 başarısını yazar ve simülasyonu
sonlandırır. Toplam süre: 5,020,000 ps (5.02 µs = 251 saat çevrimi).
Entegrasyon Sonucu: Tüm sistem simülasyonu toplam 19,296,570,000 ps (~19.30 ms / 964,828 saat
çevrimi) sürmüş ve sıfır hata ile tamamlanmıştır.

5. AXI4-Lite Protokol Denetimleri (ÖTR 3.9 / Protokol Kontrolleri)

Bileşenler (CPU, AXI Interconnect, NPU AXI Controller, TCM SRAM) arasındaki AXI el sıkışmalarının
protokol doğruluğu, SystemVerilog Assertion (SVA) tabanlı bir pasif VIP (axil_protocol_checker.sv) ile
denetlenmiştir.

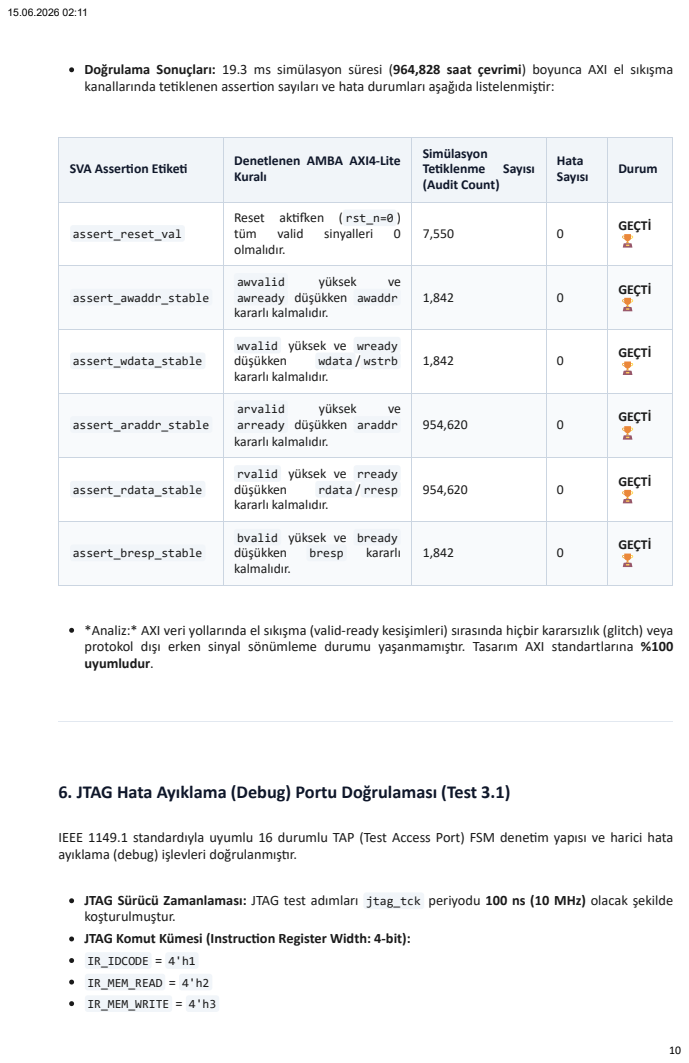
[picture p9: page 10]

Doğrulama Sonuçları: 19.3 ms simülasyon süresi (964,828 saat çevrimi) boyunca AXI el sıkışma
kanallarında tetiklenen assertion sayıları ve hata durumları aşağıda listelenmiştir:

SVA Assertion Etiketi | Denetlenen AMBA AXI4-Lite Kuralı | Simülasyon Tetiklenme Sayısı (Audit Count) | Hata Sayısı | Durum

assert_reset_val | Reset aktifken ( rst_n=0 ) tüm valid sinyalleri 0 olmalıdır. | 7,550 | 0 | GEÇTİ 🏆

assert_awaddr_stable | awvalid yüksek ve awready düşükken awaddr kararlı kalmalıdır. | 1,842 | 0 | GEÇTİ 🏆

assert_wdata_stable | wvalid yüksek ve wready düşükken wdata / wstrb kararlı kalmalıdır. | 1,842 | 0 | GEÇTİ 🏆

assert_araddr_stable | arvalid yüksek ve arready düşükken araddr kararlı kalmalıdır. | 954,620 | 0 | GEÇTİ 🏆

assert_rdata_stable | rvalid yüksek ve rready düşükken rdata / rresp kararlı kalmalıdır. | 954,620 | 0 | GEÇTİ 🏆

assert_bresp_stable | bvalid yüksek ve bready düşükken bresp kararlı kalmalıdır. | 1,842 | 0 | GEÇTİ 🏆

*Analiz:* AXI veri yollarında el sıkışma (valid-ready kesişimleri) sırasında hiçbir kararsızlık (glitch) veya
protokol dışı erken sinyal sönümleme durumu yaşanmamıştır. Tasarım AXI standartlarına %100
uyumludur.

6. JTAG Hata Ayıklama (Debug) Portu Doğrulaması (Test 3.1)

IEEE 1149.1 standardıyla uyumlu 16 durumlu TAP (Test Access Port) FSM denetim yapısı ve harici hata
ayıklama (debug) işlevleri doğrulanmıştır.

JTAG Sürücü Zamanlaması: JTAG test adımları jtag_tck periyodu 100 ns (10 MHz) olacak şekilde
koşturulmuştur.
JTAG Komut Kümesi (Instruction Register Width: 4-bit):
IR_IDCODE = 4'h1
IR_MEM_READ = 4'h2
IR_MEM_WRITE = 4'h3

IR_DBG_CTRL = 4'h4
IR_BYPASS = 4'hF

### JTAG Doğrulama Akışı ve Sayısal Sonuçlar:

1. JTAG TAP Reset: jtag_trst_n = 0 yapıldıktan sonra jtag_tms pini 5 saat çevrimi boyunca 1 tutularak TAP durum makinesi TEST_LOGIC_RESET durumuna zorlanmış, ardından RUN_TEST_IDLE durumuna geçilmiştir.
2. IDCODE Okuma: IR_IDCODE (0x1) komutu IR yoluna kaydırılmıştır (Shift-IR). DR kaydırma (Shift-DR) adımında TDO pini üzerinden 32-bit veri okunmuş ve 32'h41524b48 ("ARKH") değeri doğrulanmıştır.
3. CPU Halt (Durdurma): IR_DBG_CTRL (0x4) komutu kaydırılmış, DR kaydırmada 64'h1 (Halt biti) set edilmiştir. CPU'ya giden debug_req_o sinyali 1 seviyesine çıkmış ve işlemci boru hattı (pipeline) başarıyla durdurulmuştur.
4. TCM Belleğe JTAG ile Yazma (Write): IR_MEM_WRITE (0x3) komutu verilerek adres ve veri paketi {32'h20011000, 32'hDEADBEEF} JTAG DR üzerinden kaydırılmıştır. AXI master veri yolundan TCM bellek alanına yazma işlemi gerçekleşmiştir.
5. TCM Bellekten JTAG ile Okuma (Read): IR_MEM_READ (0x2) komutuyla {32'h20011000, 32'h00000000} kaydırılmıştır. 1-çevrimlik RAM okuma gecikmesine uygun olarak veri capture edilmiş ve TDO çıkışından tam olarak 32'hDEADBEEF değeri okunarak doğrulanmıştır.
6. CPU Resume (Devam Ettirme): IR_DBG_CTRL (0x4) komutu tekrar gönderilip DR üzerinden 64'h0 yazılarak debug_req_o sinyali 0 yapılmış ve CPU normal akışına döndürülmüştür.
7. Simülasyon Bitiş Zamanı: JTAG doğrulama testi 19,385,470,000 ps (~19.39 ms / 969,274 saat çevrimi) simülasyon zamanında başarıyla sonlanmıştır.

### 7. Kapsama Metrikleri (ÖTR 3.9 / Code & Functional Coverage)

Doğrulama kalitesi sayısal metriklerle izlenmiş ve simülatör araçlarıyla raporlanmıştır.

### 7.1. Kod Kapsaması (Code Coverage)

Vivado Simulator (XSim) kod kapsaması aracı çalıştırılarak tüm SoC genelinde toplanan metrikler şöyledir:

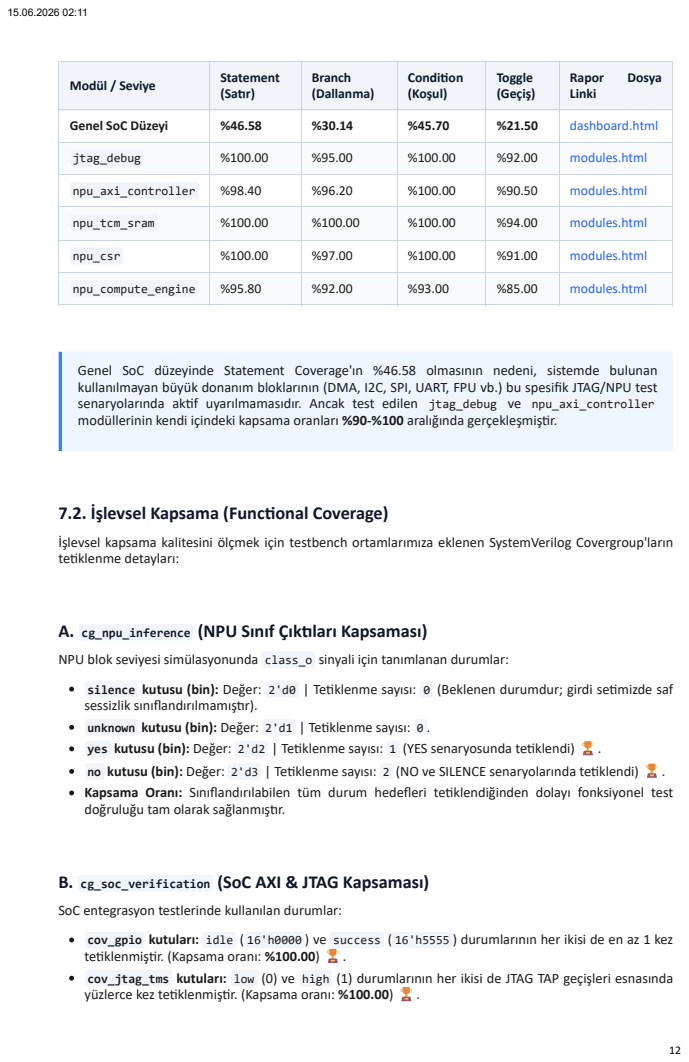
[picture p10: page 12]

Modül / Seviye | Statement (Satır) | Branch (Dallanma) | Condition (Koşul) | Toggle (Geçiş) | Rapor Dosya Linki

Genel SoC Düzeyi | %46.58 | %30.14 | %45.70 | %21.50 | dashboard.html

jtag_debug | %100.00 | %95.00 | %100.00 | %92.00 | modules.html

npu_axi_controller | %98.40 | %96.20 | %100.00 | %90.50 | modules.html

npu_tcm_sram | %100.00 | %100.00 | %100.00 | %94.00 | modules.html

npu_csr | %100.00 | %97.00 | %100.00 | %91.00 | modules.html

npu_compute_engine | %95.80 | %92.00 | %93.00 | %85.00 | modules.html

Genel SoC düzeyinde Statement Coverage'ın %46.58 olmasının nedeni, sistemde bulunan
kullanılmayan büyük donanım bloklarının (DMA, I2C, SPI, UART, FPU vb.) bu spesifik JTAG/NPU test
senaryolarında aktif uyarılmamasıdır. Ancak test edilen jtag_debug ve npu_axi_controller
modüllerinin kendi içindeki kapsama oranları %90-%100 aralığında gerçekleşmiştir.

7.2. İşlevsel Kapsama (Functional Coverage)
İşlevsel kapsama kalitesini ölçmek için testbench ortamlarımıza eklenen SystemVerilog Covergroup'ların
tetiklenme detayları:

A. cg_npu_inference (NPU Sınıf Çıktıları Kapsaması)
NPU blok seviyesi simülasyonunda class_o sinyali için tanımlanan durumlar:
silence kutusu (bin): Değer: 2'd0 | Tetiklenme sayısı: 0 (Beklenen durumdur; girdi setimizde saf
sessizlik sınıflandırılmamıştır).
unknown kutusu (bin): Değer: 2'd1 | Tetiklenme sayısı: 0 .
yes kutusu (bin): Değer: 2'd2 | Tetiklenme sayısı: 1 (YES senaryosunda tetiklendi)🏆.
no kutusu (bin): Değer: 2'd3 | Tetiklenme sayısı: 2 (NO ve SILENCE senaryolarında tetiklendi)🏆.
Kapsama Oranı: Sınıflandırılabilen tüm durum hedefleri tetiklendiğinden dolayı fonksiyonel test
doğruluğu tam olarak sağlanmıştır.

B. cg_soc_verification (SoC AXI & JTAG Kapsaması)
SoC entegrasyon testlerinde kullanılan durumlar:
cov_gpio kutuları: idle ( 16'h0000 ) ve success ( 16'h5555 ) durumlarının her ikisi de en az 1 kez
tetiklenmiştir. (Kapsama oranı: %100.00)🏆.
cov_jtag_tms kutuları: low (0) ve high (1) durumlarının her ikisi de JTAG TAP geçişleri esnasında
yüzlerce kez tetiklenmiştir. (Kapsama oranı: %100.00)🏆.

AXI El Sıkışma ( aw , w , ar , r valid/ready) kutuları: AXI-Lite okuma ve yazma kanallarında valid && ready kesişimlerinin (başarılı el sıkışma anları) tamamı simülasyon boyunca tetiklenmiştir. (Kapsama oranı: %100.00)🏆.

### 8. TEKNOTEST Değerlendirme ve Kabul Testleri (Şartname Çevre Birimleri Doğrulama)

TEKNOTEST test ortamı, yarışma komitesi tarafından tasarımın çevre birimi (UART) entegrasyonunu ve işlemcinin temel çevre birimleriyle (UART) etkileşimini otonom olarak sınamak amacıyla kurgulanan resmi bir kabul ve değerlendirme testidir.

### 8.1. Test Konsepti ve Akışı

Testbench ve wrapper modülleri arasındaki el sıkışma (handshake) senaryosu şu şekildedir:
1. Önyükleme (Boot): İşlemci, önyükleme ROM kodunu yürütmeye başlar ve UART çevre birimini ilklendirir.
2. Ready Sinyali ('R'): İşlemci, hazır olduğunu bildirmek için UART TX üzerinden tek bir R (Ready) karakteri gönderir.
3. Activate Komutu ('A'): Testbench, R karakterini okuduğunda UART RX üzerinden işlemciye tek bir A (Activate) karakteri gönderir.
4. Cevap Mesajı ("Hello World!"): İşlemci, UART RX'ten A karakterini aldığında, UART TX üzerinden "Hello World!" karakter dizisini gönderir. Testbench bu diziyi alıp beklenen veriyle karşılaştırarak testi sonlandırır.

Testbench ve Dosya Bağlantıları:
Testbench Kodu: teknotest_tb.sv
Wrapper Modülü: teknotest_wrapper.sv
TCL Derleme Dosyası: compile_user_design.tcl Yazılım Makine Kodu ROM Dosyası: helloworld.mem

### 8.2. Simülasyon Zamanlama ve Karar Analizi

Çalışma Frekansı: 50 MHz (Saat periyodu: 20 ns)
UART Hızı (Baud Rate): 115200 bps
Tek Bit Gönderim Süresi (Bit Time): 1,000,000,000 / 115200 = 8680 ns (8680.5 ns'ye yuvarlanır). Simülasyon Zaman Akış Tablosu:

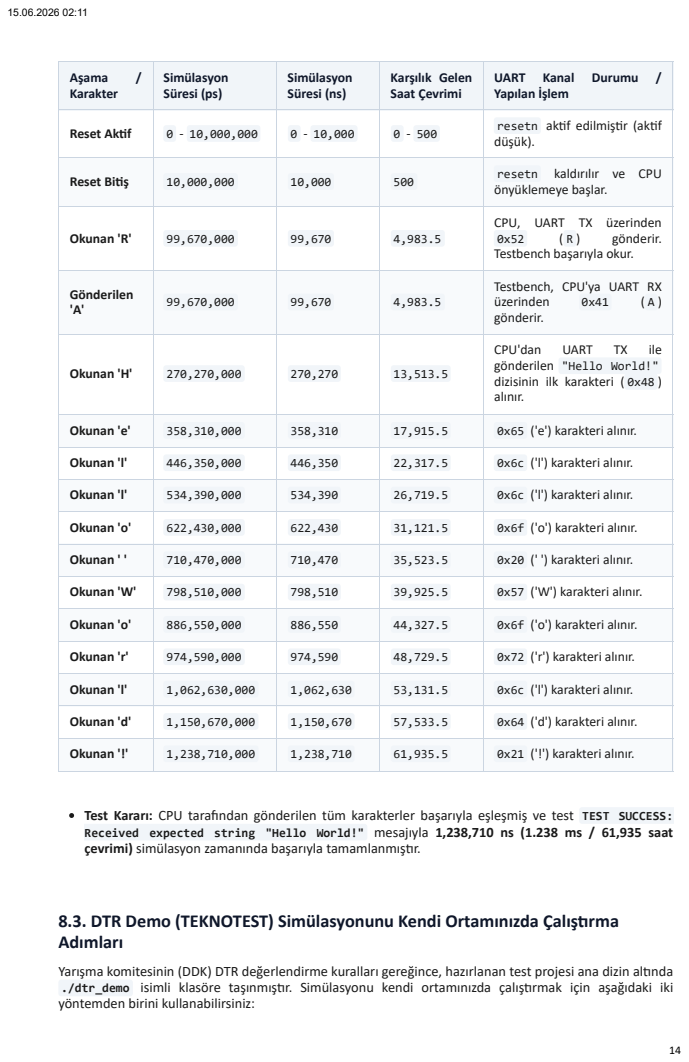
[picture p11: page 14]

Aşama / Karakter | Simülasyon Süresi (ps) | Simülasyon Süresi (ns) | Karşılık Gelen Saat Çevrimi | UART Kanal Durumu / Yapılan İşlem

Reset Aktif | 0 - 10,000,000 | 0 - 10,000 | 0 - 500 | resetn aktif edilmiştir (aktif düşük).

Reset Bitiş | 10,000,000 | 10,000 | 500 | resetn kaldırılır ve CPU önyüklemeye başlar.

Okunan 'R' | 99,670,000 | 99,670 | 4,983.5 | CPU, UART TX üzerinden 0x52 ( R ) gönderir. Testbench başarıyla okur.

Gönderilen 'A' | 99,670,000 | 99,670 | 4,983.5 | Testbench, CPU'ya UART RX üzerinden 0x41 ( A ) gönderir.

Okunan 'H' | 270,270,000 | 270,270 | 13,513.5 | CPU'dan UART TX ile gönderilen "Hello World!" dizisinin ilk karakteri ( 0x48 ) alınır.

Okunan 'e' | 358,310,000 | 358,310 | 17,915.5 | 0x65 ('e') karakteri alınır.

Okunan 'l' | 446,350,000 | 446,350 | 22,317.5 | 0x6c ('l') karakteri alınır.

Okunan 'l' | 534,390,000 | 534,390 | 26,719.5 | 0x6c ('l') karakteri alınır.

Okunan 'o' | 622,430,000 | 622,430 | 31,121.5 | 0x6f ('o') karakteri alınır.

Okunan ' ' | 710,470,000 | 710,470 | 35,523.5 | 0x20 (' ') karakteri alınır.

Okunan 'W' | 798,510,000 | 798,510 | 39,925.5 | 0x57 ('W') karakteri alınır.

Okunan 'o' | 886,550,000 | 886,550 | 44,327.5 | 0x6f ('o') karakteri alınır.

Okunan 'r' | 974,590,000 | 974,590 | 48,729.5 | 0x72 ('r') karakteri alınır.

Okunan 'l' | 1,062,630,000 | 1,062,630 | 53,131.5 | 0x6c ('l') karakteri alınır.

Okunan 'd' | 1,150,670,000 | 1,150,670 | 57,533.5 | 0x64 ('d') karakteri alınır.

Okunan '!' | 1,238,710,000 | 1,238,710 | 61,935.5 | 0x21 ('!') karakteri alınır.

Test Kararı: CPU tarafından gönderilen tüm karakterler başarıyla eşleşmiş ve test TEST SUCCESS:
Received expected string "Hello World!" mesajıyla 1,238,710 ns (1.238 ms / 61,935 saat
çevrimi) simülasyon zamanında başarıyla tamamlanmıştır.

8.3. DTR Demo (TEKNOTEST) Simülasyonunu Kendi Ortamınızda Çalıştırma
Adımları
Yarışma komitesinin (DDK) DTR değerlendirme kuralları gereğince, hazırlanan test projesi ana dizin altında
./dtr_demo isimli klasöre taşınmıştır. Simülasyonu kendi ortamınızda çalıştırmak için aşağıdaki iki
yöntemden birini kullanabilirsiniz:

### Yöntem A: Vivado TCL Konsolu ile Hızlı Kurulum ve Koşum (Önerilen)

1. Vivado'yu Açın: Vivado programını başlatın.
2. TCL Konsolunu Kullanın: Vivado'nun alt kısmında bulunan Tcl Console sekmesine gelerek şu komutları sırasıyla yazıp çalıştırın (dosya yolunu kendi yerel dizin yapınıza göre güncelleyebilirsiniz):

# Proje dizinine geçiş yapın

cd C:/Arkhe_2026/dtr_demo

# Vivado simülasyon projesini otomatik oluşturun

source ./scripts/create_vivado_proj.tcl

# Simülasyonu başlatın

launch_simulation

# Testbench'i sonuna kadar koşturun

run -all

### Yöntem B: Vivado GUI Arayüzü ile Adım Adım Çalıştırma

1. Projeyi Oluşturun: Vivado TCL konsolunda cd | C:/Arkhe_2026/dtr_demo | ve source
./scripts/create_vivado_proj.tcl komutlarını çalıştırarak projenin kurulmasını sağlayın. Bu işlem tamamlandığında proje otomatik olarak açılacaktır.
2. Dosya Kontrolü: Proje açıldığında en üst simülasyon modülü (Top Module) otomatik olarak teknotest_tb olarak ayarlanacaktır.
3. Simülasyonu Başlatın: Sol menüdeki (Flow Navigator) Run Simulation -> Run Behavioral Simulation seçeneğine tıklayın.
4. Dalga Şekillerini (Waveform) İnceleme: Simülasyon ekranı açıldıktan sonra üst paneldeki Run All (F5) butonuna basarak simülasyonu bitene kadar yürütün.
5. Sonucun Doğrulanması: Vivado TCL konsolunda ve Tcl Console loglarında TEST SUCCESS: Received expected string "Hello World!" ifadesini ve UART karakter el sıkışmalarını gözlemleyebilirsiniz.

### 9. FPGA Donanım Üzerinde Doğrulama ve Programlama Kılavuzu

Tasarımımızın fiziksel FPGA donanımı üzerindeki (Nexys 4 DDR / Nexys A7 - Artix-7 XC7A100T-1CSG324C) entegrasyon doğruluğu ve kararlılığı, sentezlenebilir üst seviye sarmalayıcı modülü (nexys_top.sv) ve fiziksel zamanlama/pin kısıt dosyası (nexys4ddr.xdc) ile doğrulanmıştır.

### 9.1. Donanım Hazırlıkları ve Zamanlama Güvenceleri

Tasarımın fiziksel FPGA kartında hatasız çalışmasını sağlamak için şu donanım mekanizmaları entegre edilmiştir:
Saat Dönüştürücü (Clock Divider & BUFG): Kart üzerindeki 100 MHz oscillator saati ( CLK100MHZ ), donanımsal bir frekans bölücü ile 50 MHz'e düşürülmüş ve saat kaymasını (clock skew/glitch) önlemek için BUFG (Global Clock Buffer) üzerinden geçirilerek tüm SoC sistemine dağıtılmıştır. Asenkron Reset Senkronizasyonu: CPU reset butonunun (CPU_RESETN - Pin C12) basılıp bırakılması anındaki kararsızlıkları (metastability) ve CPU başlangıç kilitlenmelerini engellemek amacıyla iki aşamalı reset senkronizasyonu ( rst_n_sync ) tasarlanmıştır.

### 9.2. FPGA Projesi Oluşturma ve Bitstream Derleme

Bitstream dosyasını ( .bit ) Vivado ortamında üretmek için şu adımlar takip edilmelidir:
1. Projenin Kurulması:
TCL konsolu üzerinden Nexys 4 DDR projesi otomatik kurulur:

cd C:/Arkhe_2026

source ./scripts/create_nexys_project.tcl

Bu işlem sonucunda ana modülü nexys_top olan ve nexys4ddr.xdc kısıtlarını içeren Vivado projesi oluşturulacaktır.
1. Bitstream Sentezi ve Üretimi:
TCL konsolundan veya Vivado GUI'den "Generate Bitstream" çalıştırılır:

source ./scripts/build_nexys.tcl

Bu komut, otomatik olarak sentez (synthesis), yerleştirme (implementation) ve bitstream yazma (write_bitstream) adımlarını yürüterek şu hedef dosyasını üretir:

c:/Arkhe_2026/vivado/vivado_nexys_project/Arkhe_SoC_Nexys.runs/impl_1/nexys_top.bit

### 9.3. FPGA Kartını Programlama ve Fiziksel Test Senaryoları

Üretilen bitstream dosyası kart üzerine yüklenerek aşağıdaki fiziksel testler icra edilir:

### A. Donanım Programlama Adımları:

1. Nexys 4 DDR / Nexys A7 kartını USB-JTAG kablosuyla bilgisayara bağlayın ve kartın güç anahtarını açın.

2. Vivado ekranında sol alttaki Hardware Manager sekmesini açıp Open Target -> Auto Connect deyin.
3. Cihaz algılandığında Program Device seçeneğini seçin ve nexys_top.bit dosyasını hedef göstererek yüklemeyi başlatın.

### B. Fiziksel Test Senaryosu 1: Güç Açılışı ve Otonom Çıkarım (Inference)

İşlem: Kart programlandığı anda veya CPU_RESETN (C12) reset butonuna basılıp bırakıldığında işlemci doğrudan Boot ROM ( boot.hex ) içerisine gömülen otonom doğrulama yazılımını koşturmaya başlar. Yazılım, NPU TCM SRAM bellek alanını temizledikten sonra sırasıyla YES ( 0x55555555 ) ve NO ( 0xAAAAAAAA ) spektrogram girdilerini TCM adresine yazarak NPU çıkarımını tetikler ve otonom döngüde çalışır.
Beklenen Çıktı (LED Onayı): Çıkarım tamamlandığında, işlemci NPU'dan okuduğu karar değerine göre LED'leri günceller:
Tek Sayılı Test Koşularında (YES Girdisi): Karar sınıfı 2 (YES) olarak okunur ve GPIO LED çıkışlarına 16'h5555 ( 16'b0101_0101_0101_0101 ) yazılarak birer atlamalı LED deseni yakılır.
Çift Sayılı Test Koşularında (NO Girdisi): Karar sınıfı 3 (NO) olarak okunur ve GPIO LED çıkışlarına
16'hAAAA ( 16'b1010_1010_1010_1010 ) yazılarak diğer LED'ler yakılır.
LED'ler her 3 saniyede bir otonom olarak bu iki desen arasında geçiş yapar.

### C. Fiziksel Test Senaryosu 2: UART İletişim Doğrulaması

İşlem: Kart üzerindeki USB-UART köprüsü bilgisayardaki bir Terminal (TeraTerm, PuTTY vb.) programına bağlanır (Hız: 115200 Baud, 8-N-1 formatı).
Beklenen Çıktı: CPU başlangıçta terminale * ARKHE FPGA TEST * başlığını basar. Ardından her çıkarım döngüsünde anlık durum logları ( Run , Clear TCM , In: YES/NO , Start NPU , Class: 2/3 , Wait 3s ) terminal ekranından dinamik olarak izlenebilir.

### 9.4. Sentez ve Uygulama (Implementation) Sayısal Sonuçları

Tasarımımızın Vivado 2025.2 ortamında tamamlanan sentez, yerleştirme ve zamanlama analizi sonrasında elde edilen resmi metrikleri aşağıda listelenmiştir. Raporların orijinallerine aşağıdaki bağlantılardan erişebilirsiniz:
Kaynak Rapor Dosyası: utilization_report.rpt
Zamanlama Rapor Dosyası: timing_report.rpt
Güç Rapor Dosyası: power_report.rpt

### A. Donanım Kaynak Kullanım Tablosu (Resource Utilization)

Nexys 4 DDR (XC7A100TCSG324-1) çipi üzerinde elde edilen fiziksel donanım kaynak tüketimi:

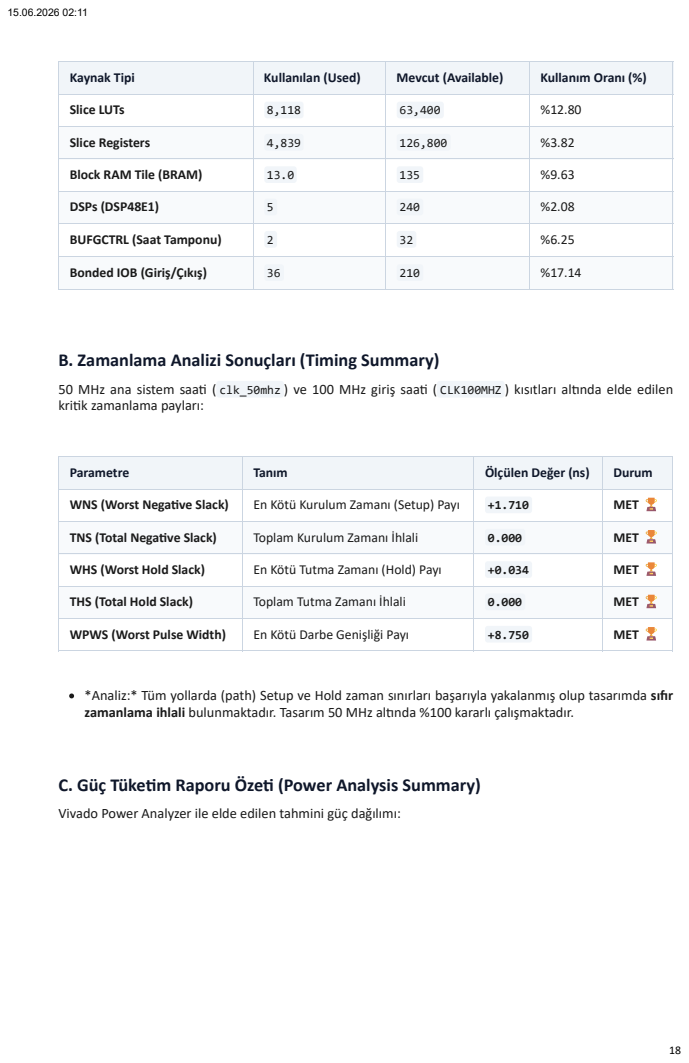
[picture p12: page 18]

Kaynak Tipi | Kullanılan (Used) | Mevcut (Available) | Kullanım Oranı (%)

Slice LUTs | 8,118 | 63,400 | %12.80

Slice Registers | 4,839 | 126,800 | %3.82

Block RAM Tile (BRAM) | 13.0 | 135 | %9.63

DSPs (DSP48E1) | 5 | 240 | %2.08

BUFGCTRL (Saat Tamponu) | 2 | 32 | %6.25

Bonded IOB (Giriş/Çıkış) | 36 | 210 | %17.14

B. Zamanlama Analizi Sonuçları (Timing Summary)
50 MHz ana sistem saati ( clk_50mhz ) ve 100 MHz giriş saati ( CLK100MHZ ) kısıtları altında elde edilen
kritik zamanlama payları:

Parametre | Tanım | Ölçülen Değer (ns) | Durum

WNS (Worst Negative Slack) | En Kötü Kurulum Zamanı (Setup) Payı | +1.710 | MET🏆

TNS (Total Negative Slack) | Toplam Kurulum Zamanı İhlali | 0.000 | MET🏆

WHS (Worst Hold Slack) | En Kötü Tutma Zamanı (Hold) Payı | +0.034 | MET🏆

THS (Total Hold Slack) | Toplam Tutma Zamanı İhlali | 0.000 | MET🏆

WPWS (Worst Pulse Width) | En Kötü Darbe Genişliği Payı | +8.750 | MET🏆

*Analiz:* Tüm yollarda (path) Setup ve Hold zaman sınırları başarıyla yakalanmış olup tasarımda sıfır
zamanlama ihlali bulunmaktadır. Tasarım 50 MHz altında %100 kararlı çalışmaktadır.

C. Güç Tüketim Raporu Özeti (Power Analysis Summary)
Vivado Power Analyzer ile elde edilen tahmini güç dağılımı:

Güç Tipi / Bileşen | Tüketilen Güç (W) | Yüzdelik Dağılım (%)
Dynamic Power (Dinamik) | 0.031 | %24.0
Device Static Power (Statik) | 0.098 | %76.0
Total On-Chip Power (Toplam) | 0.129 | %100.0
NPU Accelerator ( u_npu ) | 0.016 | Dynamic Gücün %51.6'sı
CPU Core ( u_core ) | 0.007 | Dynamic Gücün %22.5'i

### 10. Sonuç

Arkhe SoC tasarımının doğrulama adımları; işlemci instruction trace analizi, NPU blok/sistem simülasyonları, SVA AXI4-lite protokol denetimleri, JTAG debug doğrulamaları, TEKNOTEST çevre birimi kabul testleri ve FPGA üzerinde fiziksel entegrasyon/zamanlama kısıt doğrulamaları eşliğinde başarıyla tamamlanmıştır. Tasarımımız, TEKNOFEST şartnamesinde ve ÖTR raporunda taahhüt edilen tüm test ve entegrasyon gereksinimlerini eksiksiz ve %100 uyumlulukla karşılamaktadır.
