barisyamann/2026_Arkhe/fpga/nexys_demo_20260908/demo/results/ARKHE_20260913_231355/samples.csv

index | name | golden_ref | predicted | matches_golden | truth_info | matches_truth_info | golden_scores | scores | score_error_pct | latency_ms | tx_ms | timeout | retries | raw
0 | go_f19279c4_nohash_0 | no | no | 1 | unknown | 0 | -128;-107;-121;100 |  |  | 7.721 | 21.439 | 0 | 0 | [IRQ] Class: 3
1 | no_256c0a05_nohash_0 | no | no | 1 | no | 1 | -128;-127;-128;126 |  |  | 7.995 | 21.487 | 0 | 0 | [IRQ] Class: 3
2 | no_9be15e93_nohash_0 | no | no | 1 | no | 1 | -128;-127;-128;127 |  |  | 7.921 | 21.485 | 0 | 0 | [IRQ] Class: 3
3 | yes_ffb86d3c_nohash_0 | yes | yes | 1 | yes | 1 | -128;-127;127;-128 |  |  | 8.202 | 21.458 | 0 | 0 | [IRQ] Class: 2
4 | go_0c40e715_nohash_1 | no | no | 1 | unknown | 0 | -128;-124;-128;124 |  |  | 7.990 | 21.483 | 0 | 0 | [IRQ] Class: 3
5 | yes_7be9f58a_nohash_0 | yes | yes | 1 | yes | 1 | -128;-120;98;-105 |  |  | 8.475 | 21.441 | 0 | 0 | [IRQ] Class: 2
6 | yes_525eaa62_nohash_2 | yes | yes | 1 | yes | 1 | -128;-128;127;-127 |  |  | 7.327 | 21.457 | 0 | 0 | [IRQ] Class: 2
7 | no_c39703ec_nohash_4 | no | no | 1 | no | 1 | -128;-101;-126;98 |  |  | 7.844 | 21.459 | 0 | 0 | [IRQ] Class: 3
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
