barisyamann/2026_Arkhe/asic/results/images/soc_top.png

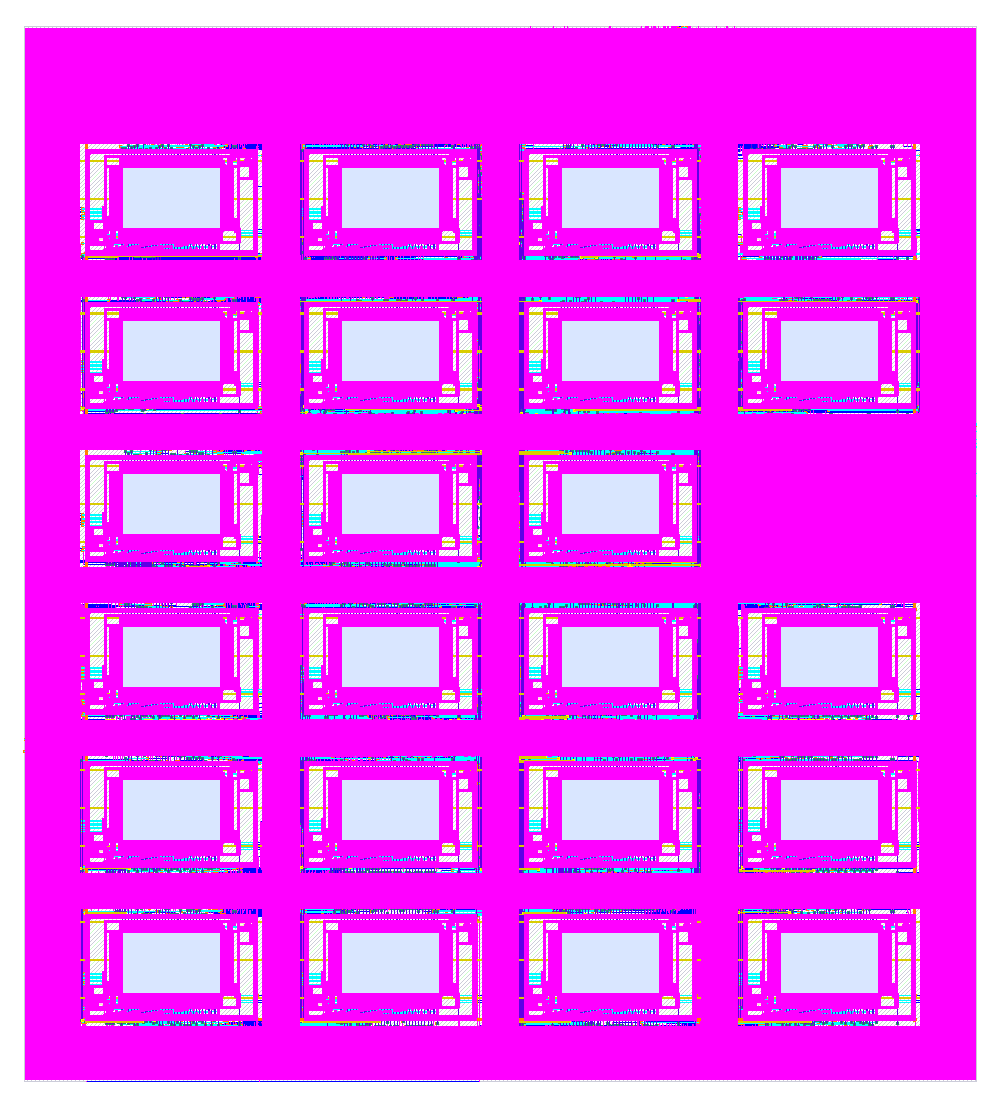
asic/results/images/soc_top.png
