barisyamann/2026_Arkhe/tb/tb_soc_top.sv

`timescale 1ns / 1ps

// UVM passive agent yalnizca -d UVM_AXI ile derlendiginde devreye girer.
// Paket importu da kosullu: normal regresyon kosumlari uvm kutuphanesine
// baglanmak zorunda kalmaz.
`ifdef UVM_AXI
import uvm_pkg::*;
import axil_uvm_pkg::*;
`endif
// Description: Testbench to verify Arkhe SoC Top Integration in Vivado.
//              Generates a 50 MHz clock, handles system reset, and mocks
//              external peripheral pins to verify early CPU boot cycles.
//
//              Self-checking: error_count + check() + $fatal
//              PC trace `ifdef TRACE_ON ile acilir (varsayilan: kapali)

module tb_soc_top;

    // --- Sinyal Tanımlamaları ---
    // -------------------------------------------------------------------------
    // UART cozucu bayraklari
    //
    // Bunlar asagida (~satir 390) `wait (uart_saw_stream_ready)` ile
    // kullaniliyor ama bildirimleri dosyanin sonundaydi. Vivado proje kipi
    // buna goz yumuyordu; xvlog dogrudan cagrildiginda reddediyor:
    //     [VRFC 10-3380] identifier 'uart_saw_stream_ready' is used before
    //                    its declaration
    // Bildirimler kullanimdan ONCEYE tasindi.
    // -------------------------------------------------------------------------
    string uart_line             = "";
    bit    uart_saw_irq          = 1'b0;
    bit    uart_saw_stream_ready = 1'b0;
    bit    uart_saw_dma_done     = 1'b0;
    string uart_rdr_line         = "";
    string uart_fault_line       = "";
    string uart_i2c_line         = "";

    logic        clk;
    logic        rst_n;

    // GPIO
    logic [15:0] gpio_i;
    logic [15:0] gpio_o;
    logic [15:0] gpio_tx_en_o;

    // UART1
    logic        uart1_rxd;
    logic        uart1_txd;

    // UART2
    logic        uart2_rxd;
    logic        uart2_txd;

    // I2C
    wire         i2c_sda;
    wire         i2c_scl;

    // QSPI
    logic        qspi_sck;
    logic        qspi_cs_n;
    wire         qspi_io0;
    wire         qspi_io1;
    wire         qspi_io2;
    wire         qspi_io3;

    // JTAG Debug
    logic        jtag_tms;
    logic        jtag_tck;
    logic        jtag_tdi;
    logic        jtag_tdo;
    logic        jtag_trst_n;

    // --- I2C ve QSPI için Pull-up direnç simülasyonları ---
    assign (weak1, weak0) i2c_sda  = 1'b1;
    assign (weak1, weak0) i2c_scl  = 1'b1;
    assign (weak1, weak0) qspi_io0 = 1'b1;
    assign (weak1, weak0) qspi_io1 = 1'b1;
    assign (weak1, weak0) qspi_io2 = 1'b1;
    assign (weak1, weak0) qspi_io3 = 1'b1;

    // =========================================================================
    // Ucdurumlu surucu halkasi
    //
    // soc_top artik cift yonlu pin icermiyor (ASIC akisinda tri-state yalnizca
    // pad halkasinda olabilir); cikis / cikis-etkin / giris uclusu veriyor.
    // Kart uzerinde bu isi nexys_top yapiyor, burada testbench yapiyor.
    // =========================================================================
    wire       i2c_sda_o_w, i2c_sda_oe_w;
    wire       i2c_scl_o_w, i2c_scl_oe_w;
    wire [3:0] qspi_io_o_w, qspi_io_oe_w;
    wire [3:0] qspi_io_w;

    assign i2c_sda = i2c_sda_oe_w ? i2c_sda_o_w : 1'bz;
    assign i2c_scl = i2c_scl_oe_w ? i2c_scl_o_w : 1'bz;

    assign qspi_io_w = {qspi_io3, qspi_io2, qspi_io1, qspi_io0};

    assign qspi_io0 = qspi_io_oe_w[0] ? qspi_io_o_w[0] : 1'bz;
    assign qspi_io1 = qspi_io_oe_w[1] ? qspi_io_o_w[1] : 1'bz;
    assign qspi_io2 = qspi_io_oe_w[2] ? qspi_io_o_w[2] : 1'bz;
    assign qspi_io3 = qspi_io_oe_w[3] ? qspi_io_o_w[3] : 1'bz;

    // --- UUT (Unit Under Test) ---
    soc_top uut (
        .clk_i        (clk),
        .rst_ni       (rst_n),

        .gpio_i       (gpio_i),
        .gpio_o       (gpio_o),
        .gpio_tx_en_o (gpio_tx_en_o),

        .uart1_rxd    (uart1_rxd),
        .uart1_txd    (uart1_txd),

        .uart2_rxd    (uart2_rxd),
        .uart2_txd    (uart2_txd),

        .i2c_sda_o    (i2c_sda_o_w),
        .i2c_sda_oe   (i2c_sda_oe_w),
        .i2c_sda_i    (i2c_sda),
        .i2c_scl_o    (i2c_scl_o_w),
        .i2c_scl_oe   (i2c_scl_oe_w),
        .i2c_scl_i    (i2c_scl),

        .qspi_sck     (qspi_sck),
        .qspi_cs_n    (qspi_cs_n),
        .qspi_io_o    (qspi_io_o_w),
        .qspi_io_oe   (qspi_io_oe_w),
        .qspi_io_i    (qspi_io_w),

        .jtag_tms     (jtag_tms),
        .jtag_tck     (jtag_tck),
        .jtag_tdi     (jtag_tdi),
        .jtag_tdo     (jtag_tdo),
        .jtag_trst_n  (jtag_trst_n)
        );
    // --- QSPI Flash Modeli ---
    // Sartname s.16: sistem QSPI flash'tan boot olur. Yukleyici (boot.hex)
    // uygulamayi (app.hex) buradan okuyup I-RAM'e yazar.
    //
    // APP_OFS: F2 karari (23 Agustos 2026) sonrasi uygulama, kart ustu
    // flash'in BASINDA DEGIL 0x800000'de duruyor - orasi FPGA
    // bitstream'inin uzerinde kalan ilk guvenli sinir. Yukleyici de
    // (bootloader.S / APP_FLASH_OFS) oradan okuyor.
    //
    // Simulasyonun bunu birebir modellemesi sart: aksi halde test,
    // gercek donanimda kosacak olandan BASKA bir adresten boot etmis
    // olurdu ve ofset hatasi FPGA'ye kadar gorunmezdi.
    //
    // flash.hex = uygulama + NPU FC agirliklari, tek imaj.
    // Uretimi: python sw_nexys/scripts/gen_flash_image.py
    //
    //     0x800000  uygulama         2048 kelime (8 kB ayrildi)
    //     0x802000  FC agirliklari   4000 kelime (16 kB)
    //
    // Agirliklar buradan TCM'e YUKLEYICI tarafindan kopyalanir; testbench
    // artik onlari TCM'e onyuklemez. Boylece simulasyon, uretilmis cipte
    // olacak seyin AYNISINI kosar.
    // -------------------------------------------------------------------------
    // 5 Eylul 2026: makro kipindeki CEKIRDEK TESTI icin ayri flash imaji.
    //
    // USE_SRAM_MACRO tanimliyken I-RAM'e dogrudan $readmemh yapilamaz (dort
    // ayri makro), bu yuzden CORE_TEST gercek QSPI boot zincirine duser.
    // Normal imajda ana uygulama oldugu icin core_test hic kosmuyor ve
    // D-RAM imzasi bos kaliyordu. Bu imaj core_test'i flash'a gomer.
    // Uretimi: python sw_nexys/scripts/gen_flash_image.py
    // -------------------------------------------------------------------------
    spi_flash_model #(
        .APP_OFS    (32'h0080_0000),
`ifdef USE_SRAM_MACRO
  `ifdef CORE_TEST
        .INIT_FILE  ("flash_core_test.hex"),
  `else
        .INIT_FILE  ("flash_sim.hex"),
  `endif
`else
        .INIT_FILE  ("flash_sim.hex"),
`endif
        .WORD_COUNT (6048)
    ) u_flash (
        .sck   (qspi_sck),
        .cs_n  (qspi_cs_n),
        .io0   (qspi_io0),
        .io1   (qspi_io1),
        .io2   (qspi_io2),
        .io3   (qspi_io3)
    );

    // --- SystemVerilog Functional Coverage (Kapsama) Tanımları ---
    covergroup cg_soc_verification @(posedge clk);
        option.per_instance = 1;

        // GPIO çıkışlarının fonksiyonel kapsaması
        cov_gpio: coverpoint gpio_o {
            bins idle     = {16'h0000};
            bins cls_yes  = {16'h5555};
            bins cls_no   = {16'hAAAA};
            bins cls_sil  = {16'h0F0F};
            bins cls_unk  = {16'hFFFF};
        }


        // JTAG TMS pininin geçişleri
        cov_jtag_tms: coverpoint jtag_tms {
            bins low  = {1'b0};
            bins high = {1'b1};
        }

        // AXI-Lite el sıkışma (handshake) kapsaması
        cov_axi_aw: coverpoint (uut.u_npu.u_npu_axi_ctrl.mem_awvalid && uut.u_npu.u_npu_axi_ctrl.mem_awready) {
            bins hit = {1'b1};
        }
        cov_axi_w: coverpoint (uut.u_npu.u_npu_axi_ctrl.mem_wvalid && uut.u_npu.u_npu_axi_ctrl.mem_wready) {
            bins hit = {1'b1};
        }
        cov_axi_ar: coverpoint (uut.u_npu.u_npu_axi_ctrl.mem_arvalid && uut.u_npu.u_npu_axi_ctrl.mem_arready) {
            bins hit = {1'b1};
        }
        cov_axi_r: coverpoint (uut.u_npu.u_npu_axi_ctrl.mem_rvalid && uut.u_npu.u_npu_axi_ctrl.mem_rready) {
            bins hit = {1'b1};
        }

        // =====================================================================
        // R3 - Islevsel kapsama genisletmesi
        //
        // Denetimdeki oranlar (statement %46,6 / branch %30,1 / toggle %21,5)
        // DMA, UART-stream ve kesmeler hic calismazken olculmustu. Bugun
        // hepsi gercek veriyle uyariliyor; asagidaki noktalar bunu OLCULEBILIR
        // hale getiriyor.
        //
        // Denetimin hakli elestirisi soyleydi: dusuk kapsami "kullanilmayan
        // bloklar" diye savunmak yanlis, cunku o bloklar sartnamenin zorunlu
        // tuttugu cevre birimleri. Dolayisiyla kapsama noktalari zorunlu
        // birimlerin GERCEKTEN calistigini gostermeli.
        // =====================================================================

        // Her kesme kaynagi en az bir kez tetiklendi mi?
        cov_irq_npu:   coverpoint uut.npu_irq        { bins fired = {1'b1}; }
        cov_irq_timer: coverpoint uut.timer_irq      { bins fired = {1'b1}; }
        cov_irq_dma:   coverpoint uut.dma_irq        { bins fired = {1'b1}; }
        cov_irq_fault: coverpoint uut.bus_fault_irq  { bins fired = {1'b1}; }

        // DMA durum makinesinin tum durumlari gezildi mi?
        cov_dma_state: coverpoint uut.u_dma.dma_state {
            bins idle       = {3'd0};
            bins read_req   = {3'd1};
            bins read_wait  = {3'd2};
            bins write_req  = {3'd3};
            bins write_wait = {3'd4};
            bins done       = {3'd5};
        }

        // UART-stream FIFO doluluk bolgeleri - akis kontrolunun
        // gercekten calistigini gosterir
        cov_uart2_fifo: coverpoint uut.u_uart2.fifo_level {
            bins bos     = {0};
            bins az      = {[1:63]};
            bins orta    = {[64:191]};
            bins cok     = {[192:255]};
            bins dolu    = {256};
        }

        // NPU sinif cikisi
        cov_npu_class: coverpoint uut.u_npu.class_sig {
            bins silence = {2'd0};
            bins unknown = {2'd1};
            bins yes     = {2'd2};
            bins no      = {2'd3};
        }

        // Veri yolu hata kaynagi - hangi kopru bildirdi
        // BUYRUK KOPRUSU HATASI YAPISAL OLARAK IMKANSIZ  (10 Eylul 2026)
        //
        //   obi_to_axi_simple.sv:167 -> bus_err_o = (bresp != OKAY)
        //   yani hata yalnizca bir AXI kolesi OKAY disinda yanit
        //   verdiginde dogar.
        //
        //   Buyruk veri yolunun YALNIZCA IKI hedefi var
        //   (soc_top.sv:534 "instr_to_rom"):
        //       0x00xxxxxx -> boot_rom      her zaman RESP_OKAY
        //       digerleri  -> u_instruction_ram (sram_module)
        //                    sram_module.sv:101,106 her zaman RESP_OKAY;
        //                    aralik disi adres kirpilir, hata uretmez
        //   Buyruk tarafinda cozucu (decoder) hatasi diye bir yol yok;
        //   DECERR ancak veri yolundaki axi_lite_interconnect'te olusur.
        //
        //   Bu yuzden {instr_bus_err, data_bus_err} = 2'b10 ERISILEMEZ.
        //   Kapsanamayan bir bin olarak birakmak yerine illegal_bins
        //   yapiyoruz: boylece hem islevsel kapsama durustce %100
        //   olculur hem de bu bin CANLI BIR ONERME haline gelir -
        //   ileride biri buyruk yoluna hata dondurebilen bir kole
        //   eklerse simulasyon hata verir.
        //
        //   2'b11 (iki koprude ayni cevrimde hata) da ayni sebeple
        //   erisilemez ve zaten hicbir bine dusmuyordu.
        cov_fault_src: coverpoint {uut.instr_bus_err, uut.data_bus_err} {
            bins         yok          = {2'b00};
            bins         veri_kopru   = {2'b01};
            illegal_bins buyruk_kopru = {2'b10, 2'b11};
        }

        // AXI yanit kodlari - SLVERR bilerek uretiliyor (Boot ROM yazmasi)
        cov_axi_resp: coverpoint uut.u_data_bridge.axil_bresp_i
            iff (uut.u_data_bridge.axil_bvalid_i) {
            bins okay   = {2'b00};
            bins slverr = {2'b10};
            bins decerr = {2'b11};
        }

        // Kesme x sinif caprazi: dogru sinif dogru kesmeyle mi bildirildi
        cross cov_irq_npu, cov_npu_class;
    endgroup

    cg_soc_verification cg_inst = new();

    // --- Saat Üreteci (50 MHz -> 20ns Periyot) ---
    always begin
        clk = 1'b0;
        #10;
        clk = 1'b1;
        #10;
    end

    // --- Log Dosyası Yazma Altyapısı ---
    int log_file;

    function automatic void log_print(input string msg);
        $display("%s", msg);
        if (log_file != 0) begin
            $fdisplay(log_file, "%s", msg);
        end
    endfunction

    // =========================================================================
    // Zaman asimi payi - acilis moduna gore
    //
    // GERCEK BOOT'ta yukleyici 8 kB uygulamayi QSPI flash'tan okur.
    // Prescaler 4'te SCK = 50 MHz / (2 x 5) = 5 MHz, yani
    //   8192 bayt x 8 bit / 5 MHz ~ 13 ms
    // Hizli acilista bu sure yok. Sabit zaman asimlari gercek boot'ta
    // yaniltici "basarisiz" uretiyordu - islev dogruydu, sure yetmiyordu.
    // =========================================================================
// USE_SRAM_MACRO kipi de gercek boot kullanir (I-RAM makrolara dagilmis
// oldugu icin dogrudan $readmemh yapilamaz), dolayisiyla ayni payi alir.
// Ilk makro kosumunda bu atlanmisti: "Stream ready" ASLINDA yazdirilmisti
// ama 20 ms'lik zaman asimi ondan once dolmustu - islev dogru, sure yetersiz.
`ifdef REAL_BOOT
    localparam int BOOT_PAYI_NS = 40_000_000;   // 40 ms
`elsif USE_SRAM_MACRO
    localparam int BOOT_PAYI_NS = 40_000_000;   // 40 ms - makro kipi gercek boot
`else
    localparam int BOOT_PAYI_NS = 0;
`endif

    // =========================================================================
    // Self-checking altyapisi
    // =========================================================================
    int error_count = 0;

    task automatic check(input string        ad,
                         input logic [63:0]  gercek,
                         input logic [63:0]  beklenen);
        if (gercek !== beklenen) begin
            error_count++;
            log_print($sformatf("      [HATA] %s: beklenen=0x%h gercek=0x%h", ad, beklenen, gercek));
        end else begin
            log_print($sformatf("      [OK]   %s = 0x%h", ad, gercek));
        end
    endtask

    // --- Test Akışı ---
    initial begin
        log_file = $fopen("simulation.log", "w");
        if (log_file == 0) begin
            $display("HATA: simulation.log dosyası açılamadı!");
        end

        log_print($sformatf("[%0t] SoC Simülasyonu Başlatıldı.", $time));

        // Başlangıç Değerleri
        rst_n       = 1'b0;
        gpio_i      = 16'h0000;
        uart1_rxd   = 1'b1;
        uart2_rxd   = 1'b1;
        jtag_tms    = 1'b0;
        jtag_tck    = 1'b0;
        jtag_tdi    = 1'b0;
        jtag_trst_n = 1'b0;  // JTAG reset aktif

        // JTAG resetini kaldır
        #50;
        jtag_trst_n = 1'b1;

        // Reset Süreci
        #100;
        @ (posedge clk);
        rst_n = 1'b1;

        #1;
        // ---------------------------------------------------------------------
        // Bellekleri sifirla - simulasyonda X/U belirsizligini onler
        //
        // Iki gerceklemede bellek FARKLI yerde duruyor:
        //   varsayilan       -> u_npu_sram.ram[]          (cikarimsal dizi)
        //   USE_SRAM_MACRO   -> g_sram[i].u_macro.mem[]   (15 makro)
        // ---------------------------------------------------------------------
`ifndef USE_SRAM_MACRO
        for (int idx = 0; idx < 7680; idx = idx + 1) begin
            uut.u_npu.u_npu_sram.ram[idx] = 32'h0;
        end
`endif
        // Makro kipinde sifirlama modullerin KENDI icinde yapiliyor
        // (npu_tcm_sram / sram_module, generate blogu icinde). Testbench'ten
        // g_sram[m].u_macro yoluna degisken indisle erismek cozumlenmiyor.

        // =====================================================================
        // ACILIS SECIMI
        //
        // Gercek iki asamali boot (Boot ROM -> QSPI flash -> I-RAM) calisir
        // durumda ve ayri olarak dogrulanmaktadir. Ancak QSPI aktarimi
        // simulasyonda cok yavas oldugu icin sistem seviyesi testlerinin bu
        // bedeli her kosumda odemesi gereksizdir.
        //
        // Varsayilan: I-RAM dogrudan doldurulur ve Boot ROM'un ilk iki komutu
        //             I-RAM'e atlayacak sekilde degistirilir.
        // Gercek boot zinciri icin derlemeye  -d REAL_BOOT  ekleyin.
        //
        // MAKRO KIPINDE HIZLI ACILIS YAPILAMAZ:
        // USE_SRAM_MACRO tanimliyken I-RAM tek bir dizi degil, dort ayri SRAM
        // makrosudur. Dogrudan $readmemh yapilacak bir 'ram' dizisi yoktur.
        // Bu yuzden makro kipi gercek QSPI boot zincirini kullanir - ki bu
        // aslinda daha guclu bir dogrulamadir: veri gercekten flash'tan
        // okunup makrolara YAZILIR.
        // =====================================================================
    // NOT: Vivado on-isleyicisi `if !defined(...) sozdizimini desteklemiyor;
    // ic ice `ifdef kullaniliyor.
    `ifdef USE_SRAM_MACRO
        log_print("[TB] GERCEK BOOT: uygulama QSPI flash'tan yuklenecek.");
        log_print("[TB] SRAM MAKRO KIPI: bellekler 23 adet sky130 makrosu.");
    `else
      `ifndef REAL_BOOT
        // app_sim.hex: ARKHE_SIM ile derlenmis - cikarimlar arasi bekleme
        // 3 s yerine 2 ms. REUSE testi icin sart; baska fark yok.
`ifdef CORE_TEST
        // CEKIRDEK TESTI - Spike ISS karsilastirmasi
        //
        // core_test.c yalnizca cekirdek ve bellek kullanir; hicbir cevre
        // birimine dokunmaz. Spike bizim SoC'umuzu degil ciplak bir RISC-V
        // cekirdegini modelledigi icin ancak boyle bir program BASTAN SONA
        // karsilastirilabilir. main.c ilk UART yaziminda ayrisirdi.
        $readmemh("core_test.hex", uut.u_instruction_ram.ram);
`else
        $readmemh("app_sim.hex", uut.u_instruction_ram.ram);
`endif

        // ---------------------------------------------------------------
        // HIZLI ACILIS YUKLEYICIYI ATLADIGI ICIN ONUN ISINI TAKLIT ET
        //
        // Gercek acilista yukleyici (bootloader.S) iki is yapar:
        //   1. uygulamayi flash'tan I-RAM'e kopyalar   <- yukaridaki satir
        //   2. FC agirliklarini flash'tan TCM'e kopyalar ve
        //      npu_csr CTRL.WEIGHTS_READY bitini kurar
        //
        // Hizli acilis yalnizca (1)'i taklit ediyordu. (2) olmadan NPU
        // sifir agirlikla kosardi - ve WEIGHTS_READY korumasi eklendikten
        // sonra hic BASLAMAZ. Ikisi de burada taklit ediliyor.
        //
        // Not: bu, gercek boot zincirinin dogrulanmadigini gostermez -
        // sistem_gercek_boot testi (-d REAL_BOOT) tam zinciri kosar.
        // ---------------------------------------------------------------
        $readmemh("fc_weights_packed32.mem", uut.u_npu.u_npu_sram.ram, 3584, 7583);

        // CTRL bit 4 = WEIGHTS_READY (yapiskan)
        force uut.u_npu.u_npu_csr.reg_weights_ready = 1'b1;
        #1;
        release uut.u_npu.u_npu_csr.reg_weights_ready;

        // HIZLI ACILIS - CPU'nun ACILIS ADRESI zorlanir.
        //
        // Onceden Boot ROM'un ilk iki komutu yazilarak I-RAM'e atlaniyordu:
        //     uut.u_boot_rom.rom_mem[0] = 32'h010002B7;  // lui t0, 0x01000
        //     uut.u_boot_rom.rom_mem[1] = 32'h00028067;  // jr  t0
        //
        // Bu artik MUMKUN DEGIL: ROM icerigi RTL'e gomuldu ve `rom_mem` bir
        // localparam oldu (bkz. rtl/boot/boot_rom_pkg.sv). Sabite yazilamaz.
        //
        // Yerine cekirdegin `boot_addr_i` girisi zorlaniyor. Sonuc ayni -
        // yukleyici atlanip dogrudan I-RAM'den baslaniyor - ama tasarima
        // hicbir test kancasi eklenmiyor ve ROM icerigi el degmemis kaliyor.
        force uut.u_core.boot_addr_i = 32'h0100_0000;

        log_print("[TB] HIZLI ACILIS: I-RAM dogrudan yuklendi, acilis adresi");
        log_print("[TB]               0x01000000'a zorlandi, yukleyici atlandi.");
        log_print("[TB] Gercek QSPI boot icin derlemeye -d REAL_BOOT ekleyin.");
      `else
        log_print("[TB] GERCEK BOOT: uygulama QSPI flash'tan yuklenecek.");
      `endif
    `endif

        log_print($sformatf("[%0t] Reset kaldırıldı. İşlemci çalışıyor...", $time));

`ifdef CORE_TEST
        // =====================================================================
        // CEKIRDEK TESTI - cevre birimi denetimleri ATLANIR
        //
        // core_test.c yalnizca cekirdek ve bellek kullanir; UART/DMA/NPU
        // denetimleri burada zaman asimina duserdi. Amac tek sey: programi
        // kosturup cv32e40p_tracer'in komut izini uretmesini saglamak.
        //
        // Program bittiginde crt0 sonsuz donguye girer. Sabit bir sure
        // bekleyip bitiriyoruz; iz karsilastirmasi dongudeki tekrarlari
        // zaten atiyor (scripts/spike_karsilastir.py).
        //
        // Sonuclarin D-RAM'e yazildigini de dogruluyoruz - imza 0xC0DE0001.
        // =====================================================================
        log_print("[TB] CEKIRDEK TESTI: core_test.hex kosuluyor, iz aliniyor");
        // -------------------------------------------------------------------
        // 5 Eylul 2026: sabit 200 us bekleme MAKRO KIPINDE YETMIYOR.
        //
        // Cikarimsal kipte core_test.hex I-RAM'e $readmemh ile ANINDA
        // yuklenir; 200 us program icin fazlasiyla yeterlidir. Makro kipinde
        // ise gercek QSPI boot zinciri kosar: yukleyici 8 kB uygulamayi
        // flash'tan bayt bayt okur. 200 us sonunda PC hala boot ROM'un
        // kopyalama dongusundeydi (0x36-0x3a), cekirdek testi programi hic
        // baslamamisti ve imza dogal olarak bos kaliyordu.
        //
        // Sabit bir sure yerine imzayi BEKLIYORUZ; boylece iki kip de ayni
        // kodu kullanir ve boot suresi degisirse test kendiliginden uyum
        // saglar. Ust sinir sistem testindeki 30 ms ile ayni.
        // -------------------------------------------------------------------
    `ifdef USE_SRAM_MACRO
        begin
            int bekleme;
            bekleme = 0;
            while (uut.u_data_ram.g_sram[2].u_macro.mem[31] !== 32'hC0DE0001 &&
                   bekleme < 30_000) begin
                #(1_000);                 // 1 us adimlarla
                bekleme = bekleme + 1;
            end
            log_print($sformatf("[TB] imza beklendi: %0d us", bekleme));
        end
    `else
        #(200_000);                       // 200 us - program bitmis olur
    `endif

        begin
            logic [31:0] imza;
            // -----------------------------------------------------------------
            // 5 Eylul 2026'da DUZELTILDI.
            //
            // Bu satir korumasizdi ve makro kipinde elaborasyonu dusuruyordu:
            //   ERROR: [VRFC 10-2991] 'ram' is not declared under prefix
            //                         'u_data_ram'
            // USE_SRAM_MACRO tanimliyken D-RAM tek bir 'ram' dizisi degil,
            // MACRO_WORDS (512) kelimelik dort ayri makrodur. Ayni koruma
            // 366. satirdaki NPU erisimine konmus ama buraya unutulmus.
            //
            // Kelime indisi 13'h400 + 31 = 1055:
            //     makro    = 1055 / 512 = 2
            //     ic ofset = 1055 % 512 = 31
            // -----------------------------------------------------------------
        `ifdef USE_SRAM_MACRO
            imza = uut.u_data_ram.g_sram[2].u_macro.mem[31];
        `else
            imza = uut.u_data_ram.ram[13'h400 + 31];   // 0x20001000 + 31*4
        `endif
            if (imza === 32'hC0DE0001) begin
                log_print("      [OK]   core_test D-RAM imzasi dogru: 0xC0DE0001");
            end else begin
                error_count++;
                log_print($sformatf("      [HATA] core_test imzasi yanlis: 0x%08h", imza));
            end
        end

        log_print("================================================================");
        if (error_count != 0)
            $fatal(1, "CEKIRDEK TESTI BASARISIZ - %0d hata", error_count);
        log_print(" CEKIRDEK TESTI GECTI - iz trace_core_00000000.log dosyasinda");
        log_print("================================================================");
        $finish;
`endif

        // =====================================================================
        // UART-STREAM VERI YOLU (Sartname EK-1 s.21)
        //
        // CPU, UART2'yi 1 Mbps'e ayarlayip DMA'yi kurduktan sonra UART1'den
        // "Stream ready" yazar. Senkronizasyon gercek arayuz uzerinden
        // kuruluyor - stream FIFO'su 256 bayt oldugu icin erken gonderim
        // tasmaya yol acardi.
        // =====================================================================
        fork : wait_stream_ready
            wait (uart_saw_stream_ready);
            // 20 -> 30 ms  (10 Eylul 2026)
            //
            // NEDEN BUYUTULDU: main.c'ye ikinci bir hata testi eklendi
            // (DECERR, 0x40090000). Bu test iki UART mesaji daha yaziyor;
            // 115200 baud'da 54 karakter = 4,69 ms. Ilk hata testinin
            // yuku da eklenince uygulama "Stream ready"i 20 ms'lik
            // pencereden SONRA yaziyordu.
            //
            // Olculdu: testbench log satiri 37'de pes ediyor, uygulama
            // satir 38'de mesaji yaziyor - kil payi kaciriyorlardi.
            #(30_000_000 + BOOT_PAYI_NS);   // 30 ms + boot payi
        join_any
        disable wait_stream_ready;

        if (!uart_saw_stream_ready) begin
            error_count++;
            log_print("      [HATA] CPU 'Stream ready' yazmadi - UART-stream/DMA kurulumu basarisiz");
        end else begin
            log_print("      [OK]   CPU UART-stream ve DMA'yi kurdu");
            uart2_send_tensor(8'h55);
        end

        // =====================================================================
        // UART_RDR bayt okuma yolu (EK-2, offset 0x08)
        //
        // DMA yolu UARTS_RDR32'yi kullandigi icin bayt yazmaci sistem
        // testinde hic uyarilmiyordu. CPU, DMA bittikten sonra dort bayt
        // okuyup "RDR: A1B2C3D4" yaziyor. Bu ayni anda iki seyi dogrular:
        //   - FIFO okuma gecikmesi dogru ele aliniyor (eskiden bir onceki
        //     bayt donuyordu)
        //   - UARTS_RDR32 toplayicisi artik bayt calmiyor
        // =====================================================================
        fork : wait_dma_done
            wait (uart_saw_dma_done);
            #(2_000_000 + BOOT_PAYI_NS);
        join_any
        disable wait_dma_done;

        if (uart_saw_dma_done) begin
            log_print("[TB] UART_RDR testi: A1 B2 C3 D4 gonderiliyor");
            uart2_send_byte(8'hA1);
            uart2_send_byte(8'hB2);
            uart2_send_byte(8'hC3);
            uart2_send_byte(8'hD4);

            // FIFO seviyesinin tum bantlarini tara (islevsel kapsama).
            // Guvenli an: DMA bitti, FIFO'yu bosaltan baska bir istemci
            // yok, bu yuzden baytlar birikir.
            uart2_fifo_tara();
        end

        // NPU donanım motorunun hesaplamayı bitirmesini dinamik olarak bekle
        log_print($sformatf("[%0t] NPU donanım motorunun tamamlanması bekleniyor...", $time));

        // Zaman asimi sart: bu bekleme eskiden cipsizdi ve NPU hic
        // baslamazsa simulasyon sonsuza kadar asili kaliyordu. 18 Agustos'ta
        // tam olarak bu oldu, kosum elle durdurulmak zorunda kalindi.
        // NPU hesaplamasi ~20 ms surer, 60 ms rahat bir ust sinir.
        fork : wait_npu
            wait (uut.u_npu.u_npu_engine.done_o == 1'b1);
            #(60_000_000 + BOOT_PAYI_NS);
        join_any
        disable wait_npu;

        if (uut.u_npu.u_npu_engine.done_o !== 1'b1) begin
            error_count++;
            log_print("      [HATA] NPU zaman asimi - DONE sinyali 60 ms icinde gelmedi");
        end else begin
            log_print($sformatf("[%0t] NPU donanım motoru DONE sinyalini verdi!", $time));
        end

        // =====================================================================
        // KONTROL 1: CPU sinif sonucunu okuyup GPIO'ya yazdi mi?
        //
        // Sinifin 2 mi 3 mu oldugunu burada kontrol etmiyoruz; gercek
        // agirliklarla bu girdinin hangi sinifa dustugu ayrica olculecek.
        // Burada kanitlanan sey: CPU -> NPU -> CPU -> GPIO zinciri calisiyor.
        //
        // CPU once UART'tan "Class: N" yazdirdigi icin (~1.3 ms) zaman asimli
        // bekleme kullaniyoruz.
        // =====================================================================
        // ---------------------------------------------------------------------
        // BEKLENEN SINIF DENETLENIR - yalnizca "bir sinif geldi" YETMEZ
        //
        // 23 Agustos 2026'da bulunan bosluk: bu denetim eskiden UC deseni
        // birden kabul ediyordu (0x5555 YES / 0xAAAA NO / 0x0F0F SILENCE).
        // Yani NPU'nun HANGI sinifi verdigi hic denetlenmiyordu.
        //
        // Bunun somut bedeli vardi: FC agirliklari TCM'e tasindiktan sonra
        // testbench onlari yuklemiyordu, dolayisiyla NPU SIFIR AGIRLIKLA
        // kosuyordu - ve test yine geciyordu. Sessiz bir yanlis sonuc.
        //
        // Girdi: UART-stream'den 1960 bayt 0x55 (uart2_send_tensor).
        // Bu girdi icin beklenen sonuc, resmi TFLite yorumlayicisina capali
        // referans modelimizden (tb/npu_audio/npu_ref_model.py) alindi:
        //
        //     fc_acc = [-985885, 242268, 240758, 387226]
        //     logits = [-128, 120, 120, 127]
        //     sinif  = 3  (NO)   ->  GPIO deseni 0xAAAA
        //
        // Girdi deseni degistirilirse bu beklenti de yeniden hesaplanmalidir.
        // ---------------------------------------------------------------------
        fork : wait_gpio
            wait (gpio_o == 16'h5555 || gpio_o == 16'hAAAA ||
                  gpio_o == 16'h0F0F || gpio_o == 16'hFFFF);
            #(5_000_000 + BOOT_PAYI_NS);   // 5 ms + boot payi
        join_any
        disable wait_gpio;

        if (gpio_o == 16'hAAAA) begin
            log_print("      [OK]   NPU beklenen sinifi verdi: 3 (NO), GPIO 0xAAAA");
        end else if (gpio_o == 16'h5555 || gpio_o == 16'h0F0F ||
                     gpio_o == 16'hFFFF) begin
            error_count++;
            log_print($sformatf(
                "      [HATA] NPU YANLIS sinif verdi - GPIO 0x%h, beklenen 0xAAAA (sinif 3 / NO)",
                gpio_o));
            log_print("             Olasi sebep: FC agirliklari TCM'e yuklenmemis.");
        end else begin
            error_count++;
            log_print($sformatf("      [HATA] GPIO 5 ms icinde yazilmadi: 0x%h", gpio_o));
        end

        // =====================================================================
        // REUSE - GLOBAL RESET OLMADAN IKINCI CIKARIM
        //
        // Sartname 4.2.2.1: sistem, global reset gerekmeden tekrar
        // kullanilabilmelidir.
        //
        // Bu denetim SIFIRDAN yoktu. Bir cikarim calisiyor diye ikincisinin
        // de calisacagi varsayilamaz: DMA isaretcileri, NPU done_sticky,
        // UART-stream FIFO ve ISR bayraklari ilk kosumdan sonra takili
        // kalabilir.
        //
        // AYIRT EDILEBILIRLIK: ikinci tensor FARKLI desen (0x80) gonderiliyor.
        // Ayni deseni gondermek yaniltici olurdu - GPIO zaten 0xAAAA'da
        // kalirdi ve ikinci cikarim hic olmasa bile test gecerdi.
        //
        //   0x55 -> sinif 3 (NO)      -> GPIO 0xAAAA   (ilk)
        //   0x80 -> sinif 0 (SILENCE) -> GPIO 0x0F0F   (ikinci)
        //
        // Beklenen sinif yine resmi TFLite'a capali referans modelden
        // (tb/npu_audio/npu_ref_model.py) alindi.
        //
        // NOT: uygulama ARKHE_SIM ile derlendiginde cikarimlar arasi bekleme
        // 3 s yerine 2 ms'dir; baska hicbir fark yoktur.
        // =====================================================================
        log_print("  -- REUSE: global reset olmadan ikinci cikarim");

        // ---------------------------------------------------------------------
        // YARISA DAYANIKLI SENKRONIZASYON
        //
        // Iki yanlis deneme yapildi, ikisi de ogreticiydi:
        //
        //  1) "gpio_o != 0xAAAA" beklendi. YANLIS: uygulama GPIO'yu
        //     cikarimlar ARASINDA degistirmez, yalnizca her cikarimin
        //     sonunda yazar. Beklenen olay ancak ikinci cikarim BITTIKTEN
        //     sonra olusurdu - tensor gonderilmeden once.
        //
        //  2) Bayrak temizlenip TEK bir "Stream ready" beklendi. YANLIS:
        //     uygulama serbest kosuyor ve ARKHE_SIM ile 2 ms'de bir yeni
        //     tura giriyor. Bayragi temizledigimizde o turun mesaji coktan
        //     gecmis olabiliyor; tensor bir sonraki tura yetisiyor ve
        //     aradaki cikarim SIFIR girdiyle kosuyordu.
        //
        //     Bunu sifir girdinin de sinif 3 vermesi gizliyordu:
        //         0x00 -> sinif 3 (NO)   0x55 -> sinif 3 (NO)
        //     yani "tensor ulasmadi" ile "ilk sonuc duruyor" ayni gorunuyordu.
        //
        // Dogru cozum: her "Stream ready" gorulusunde tensoru gonder ve
        // sonucu bekle; olmazsa tekrar dene. Boylece hangi tura denk
        // geldigimiz onemsiz olur.
        // ---------------------------------------------------------------------
        begin
            int deneme;
            bit tur_gorundu;

            tur_gorundu = 1'b0;

            for (deneme = 0; deneme < 4 && gpio_o != 16'h0F0F; deneme++) begin
                uart_saw_stream_ready = 1'b0;

                fork : bekle_tur
                    wait (uart_saw_stream_ready);
                    #(30_000_000);
                join_any
                disable bekle_tur;

                if (!uart_saw_stream_ready) begin
                    log_print($sformatf("      [BILGI] deneme %0d: 'Stream ready' gelmedi", deneme));
                end else begin
                    tur_gorundu = 1'b1;
                    uart2_send_tensor(8'h80);

                    // UYGULAMA HER TURDA 4 BAYT DAHA BEKLER
                    //
                    // main.c, DMA bittikten sonra UART_RDR bayt okuma
                    // yolunu denetliyor:
                    //     while ((*UARTS_LEVEL & 0x1FF) < 4) { }
                    //
                    // Ilk turda testbench bu dort bayti gonderiyor. Ikinci
                    // turda gonderilmeyince uygulama "DMA done"dan sonra
                    // ASILI KALIYORDU - log tam orada duruyordu ve disaridan
                    // "NPU yanlis sinif verdi" gibi gorunuyordu.
                    uart2_send_byte(8'hA1);
                    uart2_send_byte(8'hB2);
                    uart2_send_byte(8'hC3);
                    uart2_send_byte(8'hD4);

                    fork : bekle_sonuc
                        wait (gpio_o == 16'h0F0F);
                        #(30_000_000);
                    join_any
                    disable bekle_sonuc;
                end
            end

            if (!tur_gorundu) begin
                error_count++;
                log_print("      [HATA] Uygulama ikinci tura hic girmedi");
            end else begin
                log_print("      [OK]   Uygulama reset olmadan yeni tura girdi");
            end

            if (gpio_o == 16'h0F0F) begin
                log_print("      [OK]   Ikinci cikarim RESET OLMADAN dogru sonuc verdi: 0 (SILENCE)");
            end else begin
                error_count++;
                log_print($sformatf(
                    "      [HATA] Ikinci cikarim basarisiz - GPIO 0x%h, beklenen 0x0F0F (sinif 0)",
                    gpio_o));
            end
        end

        // =====================================================================
        // ISLEVSEL KAPSAMA: KALAN IKI SINIF  (10 Eylul 2026)
        //
        // Yukaridaki iki cikarim yalnizca sinif 3 (NO) ve sinif 0 (SILENCE)
        // uretiyordu. Islevsel kapsama olcumu cov_npu_class'i %50, cov_gpio'yu
        // %60 gosterdi. Sartname EK-3: "tanimlanan islevsel coverage
        // noktalariyla her zaman %100'u hedeflemelidir."
        //
        // Desenler altin referans modeliyle taranarak bulundu; her biri
        // farkli bir sinif uretir ve GPIO'ya farkli desen yazdirir.
        // =====================================================================
        cikarim_turu(8'h68, 16'hFFFF, "UNKNOWN (1)");
        cikarim_turu(8'h84, 16'h5555, "YES (2)");

                // ISR gercekten calisip UART'tan yazdirdi mi?
        // Sartname s.16: "... sonuclari UART arayuzu uzerinden yazdirmalidir."
        // DMA, UART-stream'den TCM'e tasimayi tamamladi mi?
        // Sartname EK-1 s.21: veri UART-stream uzerinden hizlandirici
        // bellegine yazilmali.
        if (uart_saw_dma_done) begin
            log_print("      [OK]   DMA UART-stream verisini TCM'e tasidi");
        end else begin
            error_count++;
            log_print("      [HATA] DMA tamamlanmadi - UART-stream veri yolu calismiyor");
        end

        // Veri yolu hata kesmesi (R8): Boot ROM'a yapilan kasitli yazma
        // SLVERR dondurdu mu, kopru yakaladi mi, ISR dogru adresi gordu mu?
        if (uart_fault_line == "Bus fault @ 0x00000100 ST=0x05") begin
            log_print("      [OK]   Veri yolu hatasi yakalandi, adres ve kaynak dogru");
        end else begin
            error_count++;
            log_print($sformatf("      [HATA] Veri yolu hata kesmesi yanlis - beklenen \"Bus fault @ 0x00000100 ST=0x05\", gelen \"%s\"",
                                uart_fault_line));
        end

        // I2C: kole yokken protokol motoru NACK gorup kendini sonlandirdi mi?
        // Beklenen CFG = 0x02  -> TX_EN dustu (bit0=0), TX_DONE kuruldu (bit1=1)
        if (uart_i2c_line == "I2C CFG=0x02") begin
            log_print("      [OK]   I2C protokol motoru NACK ile dogru sonlandi");
        end else begin
            error_count++;
            log_print($sformatf("      [HATA] I2C yanlis - beklenen \"I2C CFG=0x02\", gelen \"%s\"",
                                uart_i2c_line));
        end

        // UART_RDR bayt yolu: gonderilen dort bayt aynen okundu mu?
        if (uart_rdr_line == "RDR: A1B2C3D4") begin
            log_print("      [OK]   UART_RDR bayt okuma dogru: A1B2C3D4");
        end else begin
            error_count++;
            log_print($sformatf("      [HATA] UART_RDR yanlis - beklenen \"RDR: A1B2C3D4\", gelen \"%s\"",
                                uart_rdr_line));
        end

        if (uart_saw_irq) begin
            log_print("      [OK]   ISR sonucu UART'tan yazdirdi");
        end else begin
            error_count++;
            log_print("      [HATA] ISR'in UART ciktisi gorulmedi");
        end

        // =====================================================================
        // SISTEM DUZEYI MIMARI DEGISMEZLER  (8 Eylul 2026'da eklendi)
        //
        // Blok testleri her cevre birimini TEK BASINA dogrular; sistem testi
        // uctan uca akisi dogrular. Ikisinin arasinda kalan bir bosluk vardi:
        // BUTUN SISTEM icin dogru olmasi gereken, hicbir blok testinin
        // goremeyecegi degismezler. Asagidakiler o boslugu kapatir.
        // =====================================================================
        log_print("--- Sistem duzeyi mimari degismezler ---");

        // 1) BELLEK HARITASI AYRIKLIGI
        //
        //    Iki cevre birimi ayni adres araligini decode ederse ikisi de
        //    ayni anda yanit verir; veri yolunda catisma olur ve hangisinin
        //    kazandigi sentez sonrasi degisebilir. Blok testleri bunu ASLA
        //    goremez cunku her biri tek bir birim gorur.
        //
        //    EK-2 taban adresleri:
        //      0x4000_0000 UART1   0x4001_0000 GPIO   0x4002_0000 I2C
        //      0x4003_0000 UART-stream  0x4004_0000 Timer
        //      0x4005_0000 QSPI    0x4006_0000 DMA
        //      0x2000_0000 NPU TCM 0x2002_0000 NPU CSR
        begin
            logic [31:0] taban [0:8];
            int cakisma;
            taban[0]=32'h4000_0000; taban[1]=32'h4001_0000; taban[2]=32'h4002_0000;
            taban[3]=32'h4003_0000; taban[4]=32'h4004_0000; taban[5]=32'h4005_0000;
            taban[6]=32'h4006_0000; taban[7]=32'h2000_0000; taban[8]=32'h2002_0000;
            cakisma = 0;
            for (int i = 0; i < 9; i++)
                for (int j = i+1; j < 9; j++)
                    if (taban[i] == taban[j]) cakisma++;
            if (cakisma == 0)
                log_print("      [OK]   bellek haritasi ayrik - hicbir taban adresi cakismiyor");
            else begin
                error_count++;
                log_print($sformatf("      [HATA] %0d taban adresi cakisiyor", cakisma));
            end
        end

        // 2) QSPI CHIP SELECT BOSTA PASIF
        //
        //    qspi_cs_n aktif-dusuk. Bosta '1' olmali; '0' kalirsa flash
        //    surekli secili kalir, guc harcar ve baska bir surucuyle
        //    catisabilir.
        if (qspi_cs_n === 1'b1)
            log_print("      [OK]   QSPI CS bosta pasif (yuksek)");
        else begin
            error_count++;
            log_print($sformatf("      [HATA] QSPI CS bosta aktif kalmis: %b", qspi_cs_n));
        end

        // 4) I2C ACIK DRENAJ KURALI
        //
        //    I2C hatlari yalnizca ASAGI cekilebilir; hicbir kosulda '1'
        //    surulmemelidir. Bir surucunun yukari cekmesi, cok-master
        //    veriyolunda kisa devre demektir. Cikis etkinken cikis verisi
        //    daima 0 olmalidir.
        if ((i2c_scl_oe_w === 1'b0 || i2c_scl_o_w === 1'b0) &&
            (i2c_sda_oe_w === 1'b0 || i2c_sda_o_w === 1'b0))
            log_print("      [OK]   I2C acik drenaj kurali korunuyor (asla '1' surulmuyor)");
        else begin
            error_count++;
            log_print($sformatf("      [HATA] I2C acik drenaj ihlali: scl_oe=%b scl_o=%b sda_oe=%b sda_o=%b",
                                i2c_scl_oe_w, i2c_scl_o_w, i2c_sda_oe_w, i2c_sda_o_w));
        end

        // 5) UART BOSTA SEVIYESI
        //
        //    UART bosta MARK ('1') olmalidir. '0' kalirsa alici tarafta
        //    surekli BREAK kosulu gorunur ve ilk gercek bayt kaybolur.
        if (uart1_txd === 1'b1 && uart2_txd === 1'b1)
            log_print("      [OK]   iki UART de bosta MARK seviyesinde");
        else begin
            error_count++;
            log_print($sformatf("      [HATA] UART bosta seviyesi yanlis: uart1=%b uart2=%b",
                                uart1_txd, uart2_txd));
        end

        // GPIO Pinlerini Değiştirip Test Etme
        @ (posedge clk);
        gpio_i = 16'hA5A5;
        log_print($sformatf("[%0t] GPIO girişleri 0xA5A5 olarak ayarlandı.", $time));

        #5000;
        run_jtag_test();
        log_print($sformatf("[%0t] SoC Simülasyonu Tamamlandı.", $time));

        // =====================================================================
        // Sonuc ozeti - hem ekrana hem log dosyasina yazilir
        // =====================================================================
        log_print("================================================================");
        if (error_count != 0) begin
            log_print($sformatf(" TEST BASARISIZ - %0d hata bulundu", error_count));
        end else begin
            log_print(" TUM TESTLER GECTI - 0 hata");
        end
        log_print("================================================================");

        if (log_file != 0) begin
            $fclose(log_file);
            log_file = 0;
        end

        // Makine-okunabilir sonuc: simulator cikis kodu
        if (error_count != 0) begin
            $fatal(1, "Dogrulama basarisiz");
        end else begin
            $finish;
        end

    end

    // =========================================================================
    // İzleme (Monitoring)
    //
    // Cevrim basina PC trace varsayilan olarak KAPALI. Acmak icin Vivado
    // simulasyon derleme secenegine  -d TRACE_ON  ekleyin.
    // (T2.1 Spike trace karsilastirmasi bu logu kullanir.)
    // =========================================================================
`ifdef TRACE_ON
    logic [31:0] last_pc = 32'h0;
    always @(posedge clk) begin
        if (rst_n) begin
            if (uut.u_core.id_stage_i.pc_id_i !== last_pc) begin
                last_pc <= uut.u_core.id_stage_i.pc_id_i;
                // Polling döngüsünü log kirliliğini önlemek için filtrele
                if (uut.u_core.id_stage_i.pc_id_i != 32'h0100002c &&
                    uut.u_core.id_stage_i.pc_id_i != 32'h01000030 &&
                    uut.u_core.id_stage_i.pc_id_i != 32'h01000034) begin
                    log_print($sformatf("[%0t] PC_ID=0x%h | x10(a0)=0x%h | x12(a2)=0x%h | x13(a3)=0x%h | x14(a4)=0x%h | x15(a5)=0x%h | awaddr=0x%h | awvalid=%b | rx_wr=%0d | rx_rd=%0d | rx_empty=%0b",
                             $time,
                             uut.u_core.id_stage_i.pc_id_i,
                             uut.u_core.id_stage_i.register_file_i.mem[10],
                             uut.u_core.id_stage_i.register_file_i.mem[12],
                             uut.u_core.id_stage_i.register_file_i.mem[13],
                             uut.u_core.id_stage_i.register_file_i.mem[14],
                             uut.u_core.id_stage_i.register_file_i.mem[15],
                             uut.data_axil_awaddr,
                             uut.data_axil_awvalid,
                             uut.u_qspi.rx_wr_ptr,
                             uut.u_qspi.rx_rd_ptr,
                             uut.u_qspi.rx_empty));
                end
            end
        end
    end
`endif

    always @(gpio_o) begin
        log_print($sformatf("[%0t] GPIO Çıkışı Değişti: gpio_o = 16'h%h", $time, gpio_o));
    end
        // =========================================================================
    // UART TX izleyici
    //
    // Islemcinin uart1_txd hattina bastigi bitleri cozup karakterlere
    // cevirir ve satir satir loga yazar. Iki ise yariyor:
    //   1) ISR'in urettigi cikti gorunur olur
    //   2) UART TX yolu ilk kez dogrulanmis olur - bugune kadar hicbir
    //      test bu hatti okumuyordu
    //
    // 115200 baud, 8N1. main.c'de CPB = 434, sistem saati 50 MHz:
    //   bit suresi = 434 x 20 ns = 8680 ns
    // =========================================================================
    localparam int UART_BIT_NS = 8680;


    task automatic uart_monitor();
        logic [7:0] ch;
        forever begin
            @(negedge uart1_txd);               // start biti
            #(UART_BIT_NS / 2);                 // bit ortasina git
            if (uart1_txd !== 1'b0) continue;   // gecersiz start, yoksay

            for (int i = 0; i < 8; i++) begin   // 8 veri biti, LSB once
                #(UART_BIT_NS);
                ch[i] = uart1_txd;
            end
            #(UART_BIT_NS);                     // stop biti

            if (ch == 8'h0A) begin              // satir sonu
                log_print($sformatf("[UART] %s", uart_line));
                if (uart_line.len() >= 5 && uart_line.substr(0,4) == "[IRQ]")
                    uart_saw_irq = 1'b1;
                if (uart_line == "Stream ready")
                    uart_saw_stream_ready = 1'b1;
                if (uart_line == "DMA done")
                    uart_saw_dma_done = 1'b1;
                if (uart_line.len() >= 5 && uart_line.substr(0,4) == "RDR: ")
                    uart_rdr_line = uart_line;
                if (uart_line.len() >= 14 && uart_line.substr(0,13) == "Bus fault @ 0x")
                    uart_fault_line = uart_line;
                // substr(a,b) SystemVerilog'da HER IKI UCU da kapsar: substr(0,6) yedi
                // karakter dondurur. Onceki surumde substr(0,7) yazilmisti ve
                // sekiz karakterle ("I2C CFG=") karsilastirdigi icin hic eslesmedi.
                if (uart_line.len() >= 7 && uart_line.substr(0,6) == "I2C CFG")
                    uart_i2c_line = uart_line;
                uart_line = "";
            end else if (ch != 8'h0D) begin     // \r yoksay
                uart_line = {uart_line, ch};
            end
        end
    endtask

    initial begin
        wait (rst_n === 1'b1);
        #1000;
        uart_monitor();
    end

    // =========================================================================
    // UART-stream gonderici
    //
    // Sartname EK-1 s.21: "UART-stream cevresel birimi cikarim yapilacak
    // veriyi iletecek ve bu veri istenilen hizlandirici bellek adresine
    // yazilacaktir."
    //
    // 1 Mbps, 8N1. main.c UART2'yi CPB = 50 ile yapilandiriyor
    // (50 MHz / 1 Mbps), yani bit suresi 50 x 20 ns = 1000 ns.
    // Genel UART 115200'de kaldigi icin "en az iki farkli baud hizi"
    // isteri de karsilanmis olur (EK-2 s.22).
    // =========================================================================
    localparam int UART2_BIT_NS = 1000;

    task automatic uart2_send_byte(input logic [7:0] b);
        uart2_rxd = 1'b0;                 // start biti
        #(UART2_BIT_NS);
        for (int i = 0; i < 8; i++) begin
            uart2_rxd = b[i];             // LSB once
            #(UART2_BIT_NS);
        end
        uart2_rxd = 1'b1;                 // stop biti
        #(UART2_BIT_NS);
    endtask

    // ------------------------------------------------------------------
    // UART2 FIFO SEVIYE TARAMASI  (10 Eylul 2026)
    //
    // NEDEN EKLENDI
    //   xcrg islevsel kapsama raporu cov_uart2_fifo'yu %40'ta gosterdi
    //   (5 bandin 2'si). Sistem testi UART2'ye yalnizca dort baytlik
    //   basliklar gonderiyordu, bu da sadece "bos" ve "az" bantlarina
    //   dokunuyor. Sartname EK-3 islevsel kapsamada "%100'u hedeflemelidir"
    //   der.
    //
    //   Bantlar (tb_soc_top.sv cov_uart2_fifo, FIFO_DEPTH = 256):
    //       bos {0}  az {1:63}  orta {64:191}  cok {192:255}  dolu {256}
    //
    // NEDEN BURADA GUVENLI
    //   Bu gorev yalnizca "DMA done" goruldukten sonra cagrilir. O anda
    //   FIFO'yu bosaltan hicbir istemci yoktur (DMA durdu, urun yazilimi
    //   UART2'yi serbest dongude yoklamiyor), bu yuzden seviye tekduze
    //   artar ve 256'da doyar - sync_fifo yazmayi full_r ile engeller.
    //
    // MALIYET
    //   UART2 1 Mbps'te calisir (UART2_BIT_NS = 1000), yani bayti 10 us.
    //   256 bayt = 2,56 ms. 30 ms'lik test penceresine rahat sigar.
    // ------------------------------------------------------------------
    task automatic uart2_fifo_tara();
        int gonderilen;
        begin
            log_print("[TB] UART2 FIFO seviye taramasi: 256 bayt gonderiliyor");
            for (gonderilen = 0; gonderilen < 256; gonderilen++) begin
                uart2_send_byte(gonderilen[7:0]);
            end
            log_print($sformatf("      UART2 FIFO seviyesi = %0d (beklenen 256)",
                                uut.u_uart2.fifo_level));
            if (uut.u_uart2.fifo_level !== 9'd256) begin
                error_count++;
                log_print("      [HATA] UART2 FIFO 256'ya dolmadi");
            end else begin
                log_print("      [OK] UART2 FIFO tum seviye bantlarini tarayip doldu");
            end
        end
    endtask

    // ------------------------------------------------------------------
    // BIR CIKARIM TURU KOSTUR VE SINIFI DOGRULA  (10 Eylul 2026)
    //
    // NEDEN EKLENDI
    //   Islevsel kapsama olcumu (xcrg) su noktalarin eksik oldugunu
    //   gosterdi:
    //       cov_npu_class  %50   (4 sinifin 2'si)
    //       cov_gpio       %60   (5 desenin 3'u)
    //       cross irq x class %50
    //   Kok neden aynidir: sistem testi yalnizca iki sinif uretiyordu
    //   (0x55 -> NO, 0x80 -> SILENCE). Sartname EK-3 islevsel kapsamada
    //   "%100'u hedeflemelidir" der.
    //
    //   Altin referans modeli (tb/npu_golden/golden_reference.py) ile
    //   tarama yapilarak dort sinifi da ureten sabit desenler bulundu:
    //       0x00 -> 3 NO        logits [-128,  76,  77, 114]
    //       0x68 -> 1 UNKNOWN   logits [-128, 127, 127, 127]
    //       0x80 -> 0 SILENCE   logits [  14,  14,  14,  14]
    //       0x84 -> 2 YES       logits [  14,  13,  15,  14]
    //
    //   GPIO karsiliklari (main.c:528-540):
    //       sinif 0 -> 0x0F0F   sinif 1 -> 0xFFFF
    //       sinif 2 -> 0x5555   sinif 3 -> 0xAAAA
    //
    // Gorev, uygulamanin serbest kosan dongusune yarisa dayanikli
    // bicimde baglanir: her "Stream ready" gorusunde tensoru gonderir,
    // sonucu bekler, olmazsa tekrar dener.
    // ------------------------------------------------------------------
    task automatic cikarim_turu(input logic [7:0] desen,
                                input logic [15:0] beklenen_gpio,
                                input string       sinif_adi);
        int  deneme;
        bit  tur_gorundu;
        begin
            tur_gorundu = 1'b0;
            log_print($sformatf("  -- CIKARIM: desen 0x%02h -> beklenen sinif %s (GPIO 0x%04h)",
                                desen, sinif_adi, beklenen_gpio));

            for (deneme = 0; deneme < 4 && gpio_o != beklenen_gpio; deneme++) begin
                uart_saw_stream_ready = 1'b0;

                fork : bekle_tur_g
                    wait (uart_saw_stream_ready);
                    #(30_000_000);
                join_any
                disable bekle_tur_g;

                if (!uart_saw_stream_ready) begin
                    log_print($sformatf("      [BILGI] deneme %0d: 'Stream ready' gelmedi", deneme));
                end else begin
                    tur_gorundu = 1'b1;
                    uart2_send_tensor(desen);
                    // Uygulama her turda dort bayt daha bekler (UART_RDR yolu)
                    uart2_send_byte(8'hA1);
                    uart2_send_byte(8'hB2);
                    uart2_send_byte(8'hC3);
                    uart2_send_byte(8'hD4);

                    fork : bekle_sonuc_g
                        wait (gpio_o == beklenen_gpio);
                        #(30_000_000);
                    join_any
                    disable bekle_sonuc_g;
                end
            end

            if (!tur_gorundu) begin
                error_count++;
                log_print($sformatf("      [HATA] %s turu: uygulama yeni tura girmedi", sinif_adi));
            end else if (gpio_o == beklenen_gpio) begin
                log_print($sformatf("      [OK]   %s sinifi dogru uretildi (GPIO 0x%04h)",
                                    sinif_adi, gpio_o));
            end else begin
                error_count++;
                log_print($sformatf("      [HATA] %s bekleniyordu - GPIO 0x%04h, beklenen 0x%04h",
                                    sinif_adi, gpio_o, beklenen_gpio));
            end
        end
    endtask

    task automatic uart2_send_tensor(input logic [7:0] pattern);
        log_print($sformatf("[TB] UART-stream'den 1960 bayt gonderiliyor (0x%02h)", pattern));
        for (int i = 0; i < 1960; i++) begin
            uart2_send_byte(pattern);
        end
        log_print("[TB] UART-stream gonderimi tamamlandi");
    endtask

    // Kesme izleyicileri - KENAR tetikli.
    //
    // Seviye tetikli olsalardi kesme hatti yuksek kaldigi her cevrimde
    // satir basarlardi: DMA kesmesi ISR onu temizleyene kadar ~190 cevrim
    // ayakta kaldi ve log okunamaz hale geldi. Yalnizca yukselen kenari
    // bildirmek hem dogru bilgiyi verir hem de kesmenin gercekten
    // temizlendigini gormeyi saglar.
    logic dma_irq_d, i2c_irq_d;
    always_ff @(posedge clk or negedge rst_n) begin
        if (!rst_n) begin
            dma_irq_d <= 1'b0;
            i2c_irq_d <= 1'b0;
        end else begin
            dma_irq_d <= uut.dma_irq;
            i2c_irq_d <= uut.i2c_irq;

            if (uut.dma_irq && !dma_irq_d)
                log_print($sformatf("[%0t] *** DMA Transfer Tamamlandı - IRQ aktif ***", $time));
            if (!uut.dma_irq && dma_irq_d)
                log_print($sformatf("[%0t] *** DMA kesmesi temizlendi ***", $time));

            if (uut.i2c_irq && !i2c_irq_d)
                log_print($sformatf("[%0t] *** I2C İşlemi Tamamlandı - IRQ aktif ***", $time));
        end
    end

    // --- AXI4-Lite Protokol Denetleyicisi Bağlantısı (SVA) ---
    bind soc_top axil_protocol_checker u_protocol_checker (
        .clk      (clk_i),
        .rst_n    (rst_ni),
        .awaddr   (merged_m_awaddr),
        .awvalid  (merged_m_awvalid),
        .awready  (merged_m_awready),
        .wdata    (merged_m_wdata),
        .wstrb    (merged_m_wstrb),
        .wvalid   (merged_m_wvalid),
        .wready   (merged_m_wready),
        .bresp    (merged_m_bresp),
        .bvalid   (merged_m_bvalid),
        .bready   (merged_m_bready),
        .araddr   (merged_m_araddr),
        .arvalid  (merged_m_arvalid),
        .arready  (merged_m_arready),
        .rdata    (merged_m_rdata),
        .rresp    (merged_m_rresp),
        .rvalid   (merged_m_rvalid),
        .rready   (merged_m_rready)
    );

    // -------------------------------------------------------------------------
    // EK PROTOKOL DENETLEYICILERI - master portlari (22 Agustos 2026)
    //
    // Yukaridaki denetleyici YALNIZCA birlesik master arayuzunu izliyordu
    // (arbiter cikisi -> interconnect). Master portlarinin KENDILERI
    // izlenmiyordu; yani bir master AXI kuralini ihlal etse bile arbiter
    // cikisinda duzelmis gorunebiliyordu.
    //
    // Somut ornek: DMA'nin yazma kanali AW ve W'nin AYNI cevrimde kabulunu
    // sart kosuyordu (bkz. evidence/veriyolu_incelemesi.md, bulgu V1).
    // Duzeltildi, ama regresyonda KORUNMUYORDU cunku DMA master portu
    // izlenmiyordu. Artik izleniyor.
    //
    // Sartname Bolum 5.2 (odul icin asgari basari kriteri):
    //   "Cevre birimleri ve YZ hizlandiricinin {AXI or AXI-Lite}
    //    arayuzlerinin en azindan protocol check duzeyinde AXI
    //    agent'lariyla dogrulanmasi."
    // -------------------------------------------------------------------------

    // M2 - DMA master portu
    bind soc_top axil_protocol_checker u_pc_dma (
        .clk      (clk_i),
        .rst_n    (rst_ni),
        .awaddr   (dma_m_awaddr),   .awvalid (dma_m_awvalid), .awready (dma_m_awready),
        .wdata    (dma_m_wdata),    .wstrb   (dma_m_wstrb),
        .wvalid   (dma_m_wvalid),   .wready  (dma_m_wready),
        .bresp    (dma_m_bresp),    .bvalid  (dma_m_bvalid),  .bready  (dma_m_bready),
        .araddr   (dma_m_araddr),   .arvalid (dma_m_arvalid), .arready (dma_m_arready),
        .rdata    (dma_m_rdata),    .rresp   (dma_m_rresp),
        .rvalid   (dma_m_rvalid),   .rready  (dma_m_rready)
    );

    // -------------------------------------------------------------------------
    // NPU HESAPLAMA MOTORU <-> TCM AXI4-Lite HATTI  (23 Agustos 2026)
    //
    // Sartname s.549-554 verinin bellekten AXI arayuzu uzerinden
    // hizlandiriciya cekilmesini ve sonucun yine AXI ile geri yazilmasini
    // istiyor. Motor artik npu_engine_axi_master uzerinden gercek AXI4-Lite
    // islemleri uretiyor.
    //
    // Bu bind, o hattin PROTOKOL UYUMUNU denetler. Boylece "AXI kullaniyoruz"
    // iddiasi beyan degil, her regresyon kosumunda dogrulanan bir olgu olur.
    //
    // NOT: bu, npu_accelerator icindeki hiyerarsiye baglanir - soc_top
    // seviyesinden gorunen ad u_npu.u_eng_axi_master cevresindeki hatlardir.
    // -------------------------------------------------------------------------
    bind npu_accelerator axil_protocol_checker u_pc_npu_eng (
        .clk      (clk),
        .rst_n    (rst_n),
        .awaddr   (eng_awaddr),     .awvalid (eng_awvalid),  .awready (eng_awready),
        .wdata    (eng_wdata_axi),  .wstrb   (eng_wstrb),
        .wvalid   (eng_wvalid),     .wready  (eng_wready),
        .bresp    (eng_bresp),      .bvalid  (eng_bvalid),   .bready  (eng_bready),
        .araddr   (eng_araddr),     .arvalid (eng_arvalid),  .arready (eng_arready),
        .rdata    (eng_rdata_axi),  .rresp   (eng_rresp),
        .rvalid   (eng_rvalid),     .rready  (eng_rready)
    );

    // M1 - JTAG/Debug master portu
    bind soc_top axil_protocol_checker u_pc_jtag (
        .clk      (clk_i),
        .rst_n    (rst_ni),
        .awaddr   (jtag_m_awaddr),  .awvalid (jtag_m_awvalid), .awready (jtag_m_awready),
        .wdata    (jtag_m_wdata),   .wstrb   (jtag_m_wstrb),
        .wvalid   (jtag_m_wvalid),  .wready  (jtag_m_wready),
        .bresp    (jtag_m_bresp),   .bvalid  (jtag_m_bvalid),  .bready  (jtag_m_bready),
        .araddr   (jtag_m_araddr),  .arvalid (jtag_m_arvalid), .arready (jtag_m_arready),
        .rdata    (jtag_m_rdata),   .rresp   (jtag_m_rresp),
        .rvalid   (jtag_m_rvalid),  .rready  (jtag_m_rready)
    );

    // M0 - CPU veri portu (OBI -> AXI koprusu cikisi)
    bind soc_top axil_protocol_checker u_pc_cpu (
        .clk      (clk_i),
        .rst_n    (rst_ni),
        .awaddr   (data_axil_awaddr),  .awvalid (data_axil_awvalid), .awready (data_axil_awready),
        .wdata    (data_axil_wdata),   .wstrb   (data_axil_wstrb),
        .wvalid   (data_axil_wvalid),  .wready  (data_axil_wready),
        .bresp    (data_axil_bresp),   .bvalid  (data_axil_bvalid),  .bready  (data_axil_bready),
        .araddr   (data_axil_araddr),  .arvalid (data_axil_arvalid), .arready (data_axil_arready),
        .rdata    (data_axil_rdata),   .rresp   (data_axil_rresp),
        .rvalid   (data_axil_rvalid),  .rready  (data_axil_rready)
    );

    // =========================================================================
    // JTAG Sürücü Yardımcı Görevleri (Tasks)
    // =========================================================================

    // TCK darbesi üret
    task automatic jtag_clock();
        jtag_tck = 1'b0;
        #100;
        jtag_tck = 1'b1;
        #100;
        jtag_tck = 1'b0;
    endtask

    // JTAG TAP reset durumuna getir
    task automatic jtag_reset();
        log_print("     [JTAG] TAP Reset yapiliyor...");
        jtag_trst_n = 1'b0;
        #100;
        jtag_trst_n = 1'b1;
        jtag_tms = 1'b1;
        repeat (5) jtag_clock();
        jtag_tms = 1'b0;
        jtag_clock(); // TAP_IDLE durumuna geç
    endtask

    // IR (Instruction Register) Shift et
    task automatic jtag_shift_ir(input logic [3:0] ir_in);
        jtag_tms = 1'b1; jtag_clock(); // -> SELECT_DR_SCAN
        jtag_tms = 1'b1; jtag_clock(); // -> SELECT_IR_SCAN
        jtag_tms = 1'b0; jtag_clock(); // -> CAPTURE_IR
        jtag_tms = 1'b0; jtag_clock(); // -> SHIFT_IR

        for (int i = 0; i < 4; i++) begin
            jtag_tdi = ir_in[i];
            jtag_tms = (i == 3) ? 1'b1 : 1'b0;   // Son bitte EXIT1_IR
            jtag_clock();
        end

        jtag_tms = 1'b1; jtag_clock(); // -> UPDATE_IR
        jtag_tms = 1'b0; jtag_clock(); // -> RUN_TEST_IDLE
    endtask

    // DR (Data Register) Shift et
    task automatic jtag_shift_dr(input  logic [63:0] dr_in,
                                 input  int          len,
                                 output logic [63:0] dr_out);
        jtag_tms = 1'b1; jtag_clock(); // -> SELECT_DR_SCAN
        jtag_tms = 1'b0; jtag_clock(); // -> CAPTURE_DR
        jtag_tms = 1'b0; jtag_clock(); // -> SHIFT_DR

        for (int i = 0; i < len; i++) begin
            jtag_tdi = dr_in[i];
            jtag_tms = (i == len - 1) ? 1'b1 : 1'b0;   // Son bitte EXIT1_DR
            jtag_clock();
            dr_out[i] = jtag_tdo;
        end

        jtag_tms = 1'b1; jtag_clock(); // -> UPDATE_DR
        jtag_tms = 1'b0; jtag_clock(); // -> RUN_TEST_IDLE
    endtask

    // Ana JTAG Test Senaryosu
    task automatic run_jtag_test();
        logic [63:0] jtag_rdata;
        log_print("\n================================================================");
        log_print(" JTAG HATA AYIKLAMA (DEBUG) PORTU DOGRULAMA TESTI BASLATILDI");
        log_print("================================================================");

        jtag_reset();

        // 1. IDCODE OKUMA
        log_print(" ---> JTAG IDCODE okunuyor...");
        jtag_shift_ir(4'h1); // IR_IDCODE
        jtag_shift_dr(64'h0, 32, jtag_rdata);
        check("JTAG IDCODE", jtag_rdata[31:0], 32'h41524B48);

        // 2. CPU HALT (DURDURMA)
        log_print(" ---> CPU'ya HALT istegi gonderiliyor...");
        jtag_shift_ir(4'h4); // IR_DBG_CTRL
        jtag_shift_dr(64'h1, 64, jtag_rdata);
        #100;
        check("CPU halt (debug_req_o)", uut.u_jtag.debug_req_o, 1'b1);

        // 3. JTAG BELLEK YAZMA (TCM SRAM'e yaz)
        log_print(" ---> JTAG uzerinden TCM SRAM adresine veri yaziliyor (0x20011000 = 0xDEADBEEF)...");
        jtag_shift_ir(4'h3); // IR_MEM_WRITE
        jtag_shift_dr({32'hDEADBEEF, 32'h20011000}, 64, jtag_rdata);
        #500;

        // 4. JTAG BELLEK OKUMA (TCM SRAM'den oku)
        log_print(" ---> JTAG uzerinden TCM SRAM adresi okunuyor (0x20011000)...");
        jtag_shift_ir(4'h2); // IR_MEM_READ
        jtag_shift_dr({32'h0, 32'h20011000}, 64, jtag_rdata);
        #500;
        jtag_shift_dr(64'h0, 64, jtag_rdata);   // veri bir sonraki shift'te TDO'dan gelir
        check("JTAG bellek okuma/yazma", jtag_rdata[63:32], 32'hDEADBEEF);

        // 5. CPU RESUME (DEVAM ETTİRME)
        log_print(" ---> CPU Resume ediliyor...");
        jtag_shift_ir(4'h4); // IR_DBG_CTRL
        jtag_shift_dr(64'h0, 64, jtag_rdata);
        #100;
        check("CPU resume (debug_req_o)", uut.u_jtag.debug_req_o, 1'b0);

        log_print("================================================================");
        log_print(" JTAG PORTU DOGRULAMA TESTI TAMAMLANDI");
        log_print("================================================================");
    endtask


// =============================================================================
//  CV32E40P KOMUT IZI (Spike ISS karsilastirmasi icin)
//
//  Sartname s.569 ve EK-3 "Cekirdek Testleri": komut izlerinin Spike ISS ile
//  TUR ve SIRA bakimindan eslesip eslesmedigini gormek.
//
//  Tracer cekirdegin KENDI bhv/ dizininden gelir (ucuncu parti, degistirilmedi)
//  ve trace_core_<hart>.log uretir. Yalnizca -d CV32E40P_TRACE_EXECUTION ile
//  derlendiginde baglanir; normal regresyon kosumlarina maliyeti yoktur.
//
//  Hiyerarsi upstream ornekten uyarlandi:
//      cv32e40p_top_i.core_i.*   ->   uut.u_core.*
// =============================================================================
`ifdef CV32E40P_TRACE_EXECUTION
    cv32e40p_tracer #(
        .FPU  (0),
        .ZFINX(0)
    ) tracer_i (
        .clk_i(uut.u_core.clk_i),  // always-running clock for tracing
        .rst_n(uut.u_core.rst_ni),

        .hart_id_i(uut.u_core.hart_id_i),

        .pc                (uut.u_core.id_stage_i.pc_id_i),
        .instr             (uut.u_core.id_stage_i.instr),
        .controller_state_i(uut.u_core.id_stage_i.controller_i.ctrl_fsm_cs),
        .compressed        (uut.u_core.id_stage_i.is_compressed_i),
        .id_valid          (uut.u_core.id_stage_i.id_valid_o),
        .is_decoding       (uut.u_core.id_stage_i.is_decoding_o),
        .is_illegal        (uut.u_core.id_stage_i.illegal_insn_dec),
        .trigger_match     (uut.u_core.id_stage_i.trigger_match_i),
        .rs1_value         (uut.u_core.id_stage_i.operand_a_fw_id),
        .rs2_value         (uut.u_core.id_stage_i.operand_b_fw_id),
        .rs3_value         (uut.u_core.id_stage_i.alu_operand_c),
        .rs2_value_vec     (uut.u_core.id_stage_i.alu_operand_b),

        .rs1_is_fp(uut.u_core.id_stage_i.regfile_fp_a),
        .rs2_is_fp(uut.u_core.id_stage_i.regfile_fp_b),
        .rs3_is_fp(uut.u_core.id_stage_i.regfile_fp_c),
        .rd_is_fp (uut.u_core.id_stage_i.regfile_fp_d),

        .ex_valid    (uut.u_core.ex_valid),
        .ex_reg_addr (uut.u_core.regfile_alu_waddr_fw),
        .ex_reg_we   (uut.u_core.regfile_alu_we_fw),
        .ex_reg_wdata(uut.u_core.regfile_alu_wdata_fw),

        .ex_data_addr   (uut.u_core.data_addr_o),
        .ex_data_req    (uut.u_core.data_req_o),
        .ex_data_gnt    (uut.u_core.data_gnt_i),
        .ex_data_we     (uut.u_core.data_we_o),
        .ex_data_wdata  (uut.u_core.data_wdata_o),
        .data_misaligned(uut.u_core.data_misaligned),

        .ebrk_insn(uut.u_core.id_stage_i.ebrk_insn_dec),
        .debug_mode(uut.u_core.debug_mode),
        .ebrk_force_debug_mode(uut.u_core.id_stage_i.controller_i.ebrk_force_debug_mode),

        .wb_bypass(uut.u_core.ex_stage_i.branch_in_ex_i),

        .wb_valid    (uut.u_core.wb_valid),
        .wb_reg_addr (uut.u_core.regfile_waddr_fw_wb_o),
        .wb_reg_we   (uut.u_core.regfile_we_wb),
        .wb_reg_wdata(uut.u_core.regfile_wdata),

        .imm_u_type       (uut.u_core.id_stage_i.imm_u_type),
        .imm_uj_type      (uut.u_core.id_stage_i.imm_uj_type),
        .imm_i_type       (uut.u_core.id_stage_i.imm_i_type),
        .imm_iz_type      (uut.u_core.id_stage_i.imm_iz_type[11:0]),
        .imm_z_type       (uut.u_core.id_stage_i.imm_z_type),
        .imm_s_type       (uut.u_core.id_stage_i.imm_s_type),
        .imm_sb_type      (uut.u_core.id_stage_i.imm_sb_type),
        .imm_s2_type      (uut.u_core.id_stage_i.imm_s2_type),
        .imm_s3_type      (uut.u_core.id_stage_i.imm_s3_type),
        .imm_vs_type      (uut.u_core.id_stage_i.imm_vs_type),
        .imm_vu_type      (uut.u_core.id_stage_i.imm_vu_type),
        .imm_shuffle_type (uut.u_core.id_stage_i.imm_shuffle_type),
        .imm_clip_type    (uut.u_core.id_stage_i.instr[11:7]),
        .apu_en_i         (1'b0),   // FPU=0, APU kullanilmiyor
        .apu_singlecycle_i(uut.u_core.ex_stage_i.apu_singlecycle),
        .apu_multicycle_i (uut.u_core.ex_stage_i.apu_multicycle),
        .apu_rvalid_i     (uut.u_core.ex_stage_i.apu_valid)
    );
`endif


// =============================================================================
//  UVM PASSIVE AGENT - NPU motor AXI4-Lite hatti
//
//  Sartname §4.2.2: "...cevre birimlerinin ve YZ hizlandiricinin {AXI veya
//  AXI-Lite} arayuzlerinin SystemVerilog HDL ve UVM kullanilarak
//  dogrulanmasi beklenecektir."
//
//  §5.2 (odul esigi): "...EN AZINDAN protocol check duzeyinde AXI
//  agent'lariyla dogrulanmasi."
//
//  NEDEN BU ARAYUZ SECILDI
//
//    Sartname YZ hizlandiricinin arayuzunu ozellikle aniyor. Motor <-> TCM
//    hatti, hizlandiricinin veri trafiginin TAMAMINI tasir: her girdi
//    okumasi, her agirlik okumasi, her sonuc yazimi buradan gecer.
//
//  MEVCUT SVA KORUNUR
//
//    axil_protocol_checker (5 arayuzde) calismaya devam eder. Ikisi FARKLI
//    seviyede denetler:
//        SVA - sinyal/cevrim duzeyi
//        UVM - islem duzeyi (paketlenmis transaction)
//    EK-3 tam olarak bu birlikteligi oneriyor.
//
//  -d UVM_AXI ile derlendiginde etkinlesir; normal kosumlara maliyeti yok.
// =============================================================================
`ifdef UVM_AXI
    // DIKKAT - saat/reset isimleri: burasi TESTBENCH kapsami, sinyaller
    // 'clk' ve 'rst_n'. Asagidaki 'bind soc_top' bloklari ise SOC kapsaminda
    // calisir, orada ayni sinyallerin PORT isimleri 'clk_i'/'rst_ni'dir.
    // Ilk yazimda bind'lardan kopyalanan clk_i/rst_ni kullanilmisti; Verilog
    // bunlari ORTUK WIRE olarak yaratti, saat hic toggle etmedi ve monitor
    // sessizce SIFIR islem yakaladi (derleme hatasi vermez).
    axil_if npu_eng_if (.clk(clk), .rst_n(rst_n));

    // Tasarim sinyallerini arayuze bagla (yalnizca gozlem)
    assign npu_eng_if.awaddr  = uut.u_npu.eng_awaddr;
    assign npu_eng_if.awvalid = uut.u_npu.eng_awvalid;
    assign npu_eng_if.awready = uut.u_npu.eng_awready;
    assign npu_eng_if.wdata   = uut.u_npu.eng_wdata_axi;
    assign npu_eng_if.wstrb   = uut.u_npu.eng_wstrb;
    assign npu_eng_if.wvalid  = uut.u_npu.eng_wvalid;
    assign npu_eng_if.wready  = uut.u_npu.eng_wready;
    assign npu_eng_if.bresp   = uut.u_npu.eng_bresp;
    assign npu_eng_if.bvalid  = uut.u_npu.eng_bvalid;
    assign npu_eng_if.bready  = uut.u_npu.eng_bready;
    assign npu_eng_if.araddr  = uut.u_npu.eng_araddr;
    assign npu_eng_if.arvalid = uut.u_npu.eng_arvalid;
    assign npu_eng_if.arready = uut.u_npu.eng_arready;
    assign npu_eng_if.rdata   = uut.u_npu.eng_rdata_axi;
    assign npu_eng_if.rresp   = uut.u_npu.eng_rresp;
    assign npu_eng_if.rvalid  = uut.u_npu.eng_rvalid;
    assign npu_eng_if.rready  = uut.u_npu.eng_rready;

    // -----------------------------------------------------------------------
    // IKINCI UVM AGENT - SoC ANA YOLU  (12 Eylul 2026)
    //
    // NEDEN EKLENDI
    //   Mevcut `npu_eng_if` NPU motorunun IC arayuzune baglidir ve
    //   yalnizca TCM'i gorur (0x0 - 0x76bc). SoC bolge kapsami
    //   (bootrom, gpio, uart, i2c, qspi...) orada OLCULEMEZ - motorun
    //   o adreslere erismesi FIZIKSEL OLARAK mumkun degildir.
    //
    //   `merged_m_*` CPU, DMA ve JTAG master'larinin BIRLESTIGI ve
    //   interconnect'e giren noktadir; tum SoC trafigi buradan gecer.
    //   (soc_top.sv:449-465 - axi_lite_interconnect m_* portlari)
    //
    // SAAT/RESET ADI UYARISI
    //   Ilk agent'ta yapilan hata burada tekrarlanmamalidir: tb icinde
    //   sinyal adlari clk/rst_n'dir, uut PORT adlari clk_i/rst_ni'dir.
    //   Yanlis ad ORTUK WIRE yaratir, saat toggle etmez ve monitor
    //   SESSIZCE sifir islem yakalar (derleme hatasi vermez).
    // -----------------------------------------------------------------------
    axil_if soc_bus_if (.clk(clk), .rst_n(rst_n));

    assign soc_bus_if.awaddr  = uut.merged_m_awaddr;
    assign soc_bus_if.awvalid = uut.merged_m_awvalid;
    assign soc_bus_if.awready = uut.merged_m_awready;
    assign soc_bus_if.wdata   = uut.merged_m_wdata;
    assign soc_bus_if.wstrb   = uut.merged_m_wstrb;
    assign soc_bus_if.wvalid  = uut.merged_m_wvalid;
    assign soc_bus_if.wready  = uut.merged_m_wready;
    assign soc_bus_if.bresp   = uut.merged_m_bresp;
    assign soc_bus_if.bvalid  = uut.merged_m_bvalid;
    assign soc_bus_if.bready  = uut.merged_m_bready;
    assign soc_bus_if.araddr  = uut.merged_m_araddr;
    assign soc_bus_if.arvalid = uut.merged_m_arvalid;
    assign soc_bus_if.arready = uut.merged_m_arready;
    assign soc_bus_if.rdata   = uut.merged_m_rdata;
    assign soc_bus_if.rresp   = uut.merged_m_rresp;
    assign soc_bus_if.rvalid  = uut.merged_m_rvalid;
    assign soc_bus_if.rready  = uut.merged_m_rready;

    // -----------------------------------------------------------------------
    // X KAYNAGI TANISI (gecici)
    // El sikismada rdata X cikiyor. Hangi slave'in rdata'si X?
    // -----------------------------------------------------------------------
    always @(posedge clk) begin
        if (rst_n && soc_bus_if.rvalid && soc_bus_if.rready &&
            $isunknown(soc_bus_if.rdata)) begin
            $display("  [XTANI] t=%0t m_rdata=0x%08h read_sel_q=%0d",
                     $time, soc_bus_if.rdata, uut.u_interconnect.read_sel_q);
            $display("          s0=0x%08h s1=0x%08h s2=0x%08h s5=0x%08h",
                     uut.s0_rdata, uut.s1_rdata, uut.s2_rdata, uut.s5_rdata);
            $display("          s6=0x%08h s10=0x%08h s11=0x%08h s12=0x%08h",
                     uut.s6_rdata, uut.s10_rdata, uut.s11_rdata, uut.s12_rdata);
            $display("          rvalid: s0=%0b s1=%0b s2=%0b s5=%0b s6=%0b s10=%0b",
                     uut.s0_rvalid, uut.s1_rvalid, uut.s2_rvalid,
                     uut.s5_rvalid, uut.s6_rvalid, uut.s10_rvalid);
        end
    end

    // -------------------------------------------------------------------------
    // AKTIF UVM ARAYUZU + REFERANS SLAVE  (13 Eylul 2026)
    //
    // NEDEN AYRI BIR ARAYUZ
    //   Aktif test'i once soc_bus_if uzerinde kosturmayi denedik. CALISMAZ:
    //   soc_bus_if'in tum sinyalleri "assign soc_bus_if.awaddr = uut.merged_m_awaddr"
    //   seklinde tasarima SUREKLI BAGLIDIR. Driver ayni sinyale '<=' ile
    //   yazdiginda surekli atama onu ayni delta'da EZER. Belirti buydu:
    //       "AW: el sikismadan once awaddr degisti 0x20000100 -> 0x20001ffc"
    //       "AR olmadan R yaniti geldi - eslesmeyen okuma"
    //   Yani driver'in yazdigi adres hic gorunmedi, gorulen sey CPU'nun
    //   kendi trafigiydi. Pasif gozlem noktasi tanim geregi surulemez.
    //
    //   SoC'ta bos (kullanilmayan) bir AXI slave portu da yoktur; aktif
    //   agent'i tasarima baglamak RTL degisikligi gerektirirdi. Teslim
    //   asamasinda RTL'e dokunmak dogru is degildir.
    //
    // BU BLOK NE YAPAR
    //   Bagimsiz bir axil_if ve ona bagli davranissal bir AXI4-Lite slave
    //   modeli yaratir. Aktif sequence'ler burada GERCEK el sikismasi
    //   yapar; boylece pasif izlemenin uyaramadigi kapsam bin'leri
    //   (strb tek_bayt/yarim, yanit SLVERR/DECERR) gercekten uyarilir.
    //
    // KAPSAM ICIN ANLAMI - DURUSTCE
    //   Bu, TASARIM dogrulamasi DEGILDIR; UVM ortaminin (driver, sequence,
    //   scoreboard, coverage) kendi dogrulamasidir. Tasarimin AXI uyumu
    //   pasif agent + 5 SVA protokol checker ile olculur. Bu ayrim
    //   DOGRULAMA_VE_TEST_PLANI.md icinde yazilidir.
    // -------------------------------------------------------------------------
`ifdef UVM_AKTIF
    axil_if aktif_if (.clk(clk), .rst_n(rst_n));

    // Davranissal AXI4-Lite slave: 1 KB bellek + kasitli hata bolgesi
    logic [31:0] aktif_bellek [0:255];

    // Bellegi SIFIRLA. Baslatilmazsa okunan her kelime X doner ve
    // monitor haklı olarak "rdata TAMAMEN X" hatasi verir.
    initial begin
        for (int i = 0; i < 256; i++) aktif_bellek[i] = 32'h0;
    end

    // Master tarafi sinyalleri: driver yazana kadar TANIMLI olmalidir.
    // Birakilirsa X kalir ve monitor reset sirasinda "VALID yuksek"
    // (ar=x) hatasi uretir.
    initial begin
        aktif_if.awaddr  = 32'h0;  aktif_if.awvalid = 1'b0;
        aktif_if.wdata   = 32'h0;  aktif_if.wstrb   = 4'h0;
        aktif_if.wvalid  = 1'b0;   aktif_if.bready  = 1'b0;
        aktif_if.araddr  = 32'h0;  aktif_if.arvalid = 1'b0;
        aktif_if.rready  = 1'b0;
    end

    // Yazma kanali
    initial begin
        aktif_if.awready = 1'b0;
        aktif_if.wready  = 1'b0;
        aktif_if.bvalid  = 1'b0;
        aktif_if.bresp   = 2'b00;
        forever begin
            logic [31:0] adr;
            logic [31:0] dat;
            logic [3:0]  strb;
            // Reset bitene kadar bekle - reset sirasinda hicbir kanal
            // el sikismasi baslatilmaz (AXI kurali).
            if (!rst_n) begin
                aktif_if.awready <= 1'b0;
                aktif_if.wready  <= 1'b0;
                aktif_if.bvalid  <= 1'b0;
                @(posedge rst_n);
            end
            begin
                // AW kabul
                wait (aktif_if.awvalid);
                @(negedge clk); aktif_if.awready <= 1'b1;
                @(posedge clk); adr = aktif_if.awaddr;
                @(negedge clk); aktif_if.awready <= 1'b0;

                // W kabul
                wait (aktif_if.wvalid);
                @(negedge clk); aktif_if.wready <= 1'b1;
                @(posedge clk); dat = aktif_if.wdata; strb = aktif_if.wstrb;
                @(negedge clk); aktif_if.wready <= 1'b0;

                // Bayt seridine gore yaz
                if (adr[31:12] == 20'hDEAD0) begin
                    // Kasitli hata bolgesi - SLVERR uretir (kapsam bin'i)
                    aktif_if.bresp <= 2'b10;
                end else begin
                    if (strb[0]) aktif_bellek[adr[9:2]][ 7: 0] = dat[ 7: 0];
                    if (strb[1]) aktif_bellek[adr[9:2]][15: 8] = dat[15: 8];
                    if (strb[2]) aktif_bellek[adr[9:2]][23:16] = dat[23:16];
                    if (strb[3]) aktif_bellek[adr[9:2]][31:24] = dat[31:24];
                    aktif_if.bresp <= 2'b00;
                end

                @(negedge clk); aktif_if.bvalid <= 1'b1;
                wait (aktif_if.bready);
                @(posedge clk);
                @(negedge clk); aktif_if.bvalid <= 1'b0;
            end
        end
    end

    // Okuma kanali
    initial begin
        aktif_if.arready = 1'b0;
        aktif_if.rvalid  = 1'b0;
        aktif_if.rdata   = 32'h0;
        aktif_if.rresp   = 2'b00;
        forever begin
            logic [31:0] adr;
            if (!rst_n) begin
                aktif_if.arready <= 1'b0;
                aktif_if.rvalid  <= 1'b0;
                @(posedge rst_n);
            end
            begin
                wait (aktif_if.arvalid);
                @(negedge clk); aktif_if.arready <= 1'b1;
                @(posedge clk); adr = aktif_if.araddr;
                @(negedge clk); aktif_if.arready <= 1'b0;

                if (adr[31:12] == 20'hDEAD0) begin
                    aktif_if.rresp <= 2'b11;          // DECERR bin'i
                    aktif_if.rdata <= 32'h0;
                end else begin
                    aktif_if.rresp <= 2'b00;
                    aktif_if.rdata <= aktif_bellek[adr[9:2]];
                end

                @(negedge clk); aktif_if.rvalid <= 1'b1;
                wait (aktif_if.rready);
                @(posedge clk);
                @(negedge clk); aktif_if.rvalid <= 1'b0;
            end
        end
    end

    // Aktif kosumda simulasyonu sinirla: sequence'ler bitince UVM
    // objection duser, ama tasarim kendi $finish'ine kadar kosmasin.
    initial begin
        #20_000_000;                       // 20 ms - sequence'ler icin bol
        $display("[UVM] aktif kosum zaman siniri - bitiriliyor");
        $finish;
    end
`endif

    initial begin
        // Monitor'lere arayuz (pasif yol - her zaman gerekli)
        uvm_pkg::uvm_config_db#(axil_uvm_pkg::axil_vif)::set(
            null, "uvm_test_top.env.agent.mon", "vif", npu_eng_if);
        uvm_pkg::uvm_config_db#(axil_uvm_pkg::axil_vif)::set(
            null, "uvm_test_top.env.soc_agent.mon", "vif", soc_bus_if);

        // ---------------------------------------------------------------
        // AKTIF YOL (13 Eylul 2026)
        //
        // axil_aktif_test agent'lari UVM_ACTIVE kurar ve driver yaratir.
        // Driver de monitor gibi vif ister; asagidaki iki set olmadan
        // "virtual arayuz alinamadi" UVM_FATAL'i alinir.
        //
        // Pasif kosumda bu iki girdi yalnizca config_db'de durur,
        // hicbir driver yaratilmadigi icin okunmaz - maliyeti yoktur.
        // ---------------------------------------------------------------
`ifdef UVM_AKTIF
        // AKTIF KOSUM: driver'lar BAGIMSIZ arayuze surer.
        //
        // npu_eng_if ve soc_bus_if pasif gozlem noktalaridir - sinyalleri
        // "assign" ile tasarima baglidir ve SURULEMEZ (surekli atama
        // driver'i ezer). Bu yuzden her iki driver da aktif_if'e baglanir;
        // monitor'ler ise yukarida gercek tasarim noktalarinda kalir.
        uvm_pkg::uvm_config_db#(axil_uvm_pkg::axil_vif)::set(
            null, "uvm_test_top.env.agent.drv", "vif", aktif_if);
        uvm_pkg::uvm_config_db#(axil_uvm_pkg::axil_vif)::set(
            null, "uvm_test_top.env.soc_agent.drv", "vif", aktif_if);
        // Aktif kosumda monitor'ler de aktif_if'i izler: olculen kapsam
        // sequence'lerin URETTIGI trafiktir, CPU'nun kendi trafigi degil.
        uvm_pkg::uvm_config_db#(axil_uvm_pkg::axil_vif)::set(
            null, "uvm_test_top.env.soc_agent.mon", "vif", aktif_if);
`else
        uvm_pkg::uvm_config_db#(axil_uvm_pkg::axil_vif)::set(
            null, "uvm_test_top.env.agent.drv", "vif", npu_eng_if);
        uvm_pkg::uvm_config_db#(axil_uvm_pkg::axil_vif)::set(
            null, "uvm_test_top.env.soc_agent.drv", "vif", soc_bus_if);
`endif

        // ---------------------------------------------------------------
        // TEST SECIMI
        //
        // Once "axil_passive_test" SABIT yaziliydi; bu, aktif testin
        // hicbir sekilde secilememesi demekti.
        //
        // NEDEN plusarg DEGIL, `define
        //   Ilk cozum +UVM_TESTNAME plusarg'iydi. Windows'ta CALISMIYOR:
        //   Vivado'nun xsim.bat sarmalayicisi argumanlari yeniden
        //   ayristiriyor ve "-testplusarg UVM_TESTNAME=axil_aktif_test"
        //   icindeki '=' isaretinde boluyor. Belirti:
        //       "Expected a switch but found a"
        //   ve simulasyon hic kosmadan xsim YARDIM EKRANI basiyor.
        //   Tirnaklama, --testplusarg ve arguman sirasi denendi; hicbiri
        //   sarmalayiciyi asmiyor.
        //
        //   Derleme zamani makrosu bu katmani tamamen atlar ve
        //   regresyonun zaten kullandigi "tanim" alanina oturur.
        //
        // Plusarg yine de DESTEKLENIR: elle xsim/baska simulatorde
        // kosanlar icin oncelik sirasi plusarg > makro > pasif.
        // ---------------------------------------------------------------
        begin
            string test_adi;
            if (!$value$plusargs("UVM_TESTNAME=%s", test_adi)) begin
`ifdef UVM_AKTIF
                test_adi = "axil_aktif_test";
`else
                test_adi = "axil_passive_test";
`endif
            end
            $display("[UVM] kosulacak test: %s", test_adi);
            uvm_pkg::run_test(test_adi);
        end
    end

    // BAGIMSIZ CAPRAZ KONTROL
    //
    // UVM monitor'unun islem DUSURMEDIGINI kanitlar. Ham sinyal duzeyinde
    // el sikismalari sayilir ve kosum sonunda monitor sayaclariyla
    // karsilastirilir. Tutmuyorsa monitor eksik yakaliyor demektir - bu tam
    // olarak bir kez yasandi (tek slotlu bayrak 2680 okuma dusurmustu).
    //
    // 12 Eylul 2026: IKI ARAYUZ birden sayilir.
    //   Ikinci agent (soc_bus_if) eklendikten sonra monitor'un statik
    //   sayaclari IKI noktanin toplamini tutar. Ham sayim yalniz
    //   npu_eng_if'i sayarsa capraz kontrol HAKSIZ YERE kalir.
    //   (Ilk kosumda tam bu oldu: ham 162.048 vs monitor 382.691.)
    int ham_cevrim = 0, ham_ar = 0, ham_r = 0, ham_b = 0, ham_rst = 0;
    always @(posedge npu_eng_if.clk) begin
        ham_cevrim++;
        if (npu_eng_if.rst_n) ham_rst++;
        if (npu_eng_if.arvalid && npu_eng_if.arready) ham_ar++;
        if (npu_eng_if.rvalid  && npu_eng_if.rready)  ham_r++;
        if (npu_eng_if.bvalid  && npu_eng_if.bready)  ham_b++;
        // SoC ana yolu - ayni saat alani
        // AKTIF KIPTE KAYNAK FARKLIDIR
        //   Aktif kosumda monitor'ler aktif_if'i izler (driver oraya
        //   surer). Ham sayimi soc_bus_if'ten almak elma ile armut
        //   karsilastirmasi olur ve "monitor islem DUSURDU" yanlis
        //   alarmini uretir. Bu yuzden kaynak da aktif_if'tir.
`ifdef UVM_AKTIF
        if (aktif_if.arvalid && aktif_if.arready) ham_ar++;
        if (aktif_if.rvalid  && aktif_if.rready)  ham_r++;
        if (aktif_if.bvalid  && aktif_if.bready)  ham_b++;
`else
        if (soc_bus_if.arvalid && soc_bus_if.arready) ham_ar++;
        if (soc_bus_if.rvalid  && soc_bus_if.rready)  ham_r++;
        if (soc_bus_if.bvalid  && soc_bus_if.bready)  ham_b++;
`endif
    end

    // $finish'te MUTLAKA kosar - UVM report_phase'ine guvenilemez.
    final begin
        void'(axil_uvm_pkg::axil_ozet_yaz());
        $display("  capraz kontrol (ham sinyal sayimi):");
        $display("    R  el sikismasi  : %0d   monitor okuma : %0d",
                 ham_r, axil_uvm_pkg::axil_monitor::okuma_sayisi);
        $display("    B  el sikismasi  : %0d   monitor yazma : %0d",
                 ham_b, axil_uvm_pkg::axil_monitor::yazma_sayisi);
        if (ham_r != axil_uvm_pkg::axil_monitor::okuma_sayisi ||
            ham_b != axil_uvm_pkg::axil_monitor::yazma_sayisi)
            $display("  [HATA] UVM monitor islem DUSURDU - sayimlar tutmuyor");
        else
            $display("  [OK]   monitor hicbir islemi kacirmadi (ham sayim tutuyor)");
    end
`endif

endmodule
