barisyamann/2026_Arkhe/rtl/Cevre_Birimleri/i2c_peripheral.sv

// ============================================================================
//  i2c_peripheral.sv - I2C Master Peripheral with AXI4-Lite Slave Interface
// ============================================================================
//  TEKNOFEST 2026 Chip Design Competition
//
//  Features:
//    - AXI4-Lite Slave for CPU register access (8-bit addr, 32-bit data)
//    - I2C Master with open-drain SDA/SCL
//    - Parameterised system clock (default 48 MHz) and I2C frequency (400 kHz)
//    - Hardware race-condition protection (TX/RX mutual exclusion)
//    - Single always_ff for all registers + FSM (no multiple-driver issues)
//
//  Register Map:
//    0x00  I2C_NBY  [RW]  Number of bytes to transfer (1..4, clamped)
//    0x04  I2C_ADR  [RW]  7-bit slave address in [6:0]
//    0x08  I2C_RDR  [RO]  Read data (1-4 bytes, LSB-first packing)
//    0x0C  I2C_TDR  [RW]  Transmit data (1-4 bytes, LSB-first packing)
//    0x10  I2C_CFG  [RW]  [0] TX_EN  [1] TX_DONE  [2] RX_EN  [3] RX_DONE
// ============================================================================

module i2c_peripheral #(
    parameter int SYS_CLK_FREQ = 48_000_000,   // System clock in Hz
    parameter int I2C_FREQ     = 400_000        // I2C SCL frequency in Hz
) (
    // ----------------------------------------------------------------
    // System
    // ----------------------------------------------------------------
    input  logic        clk,
    input  logic        rst_n,

    // ----------------------------------------------------------------
    // AXI4-Lite Slave - Write Address Channel
    // ----------------------------------------------------------------
    input  logic [7:0]  s_axi_awaddr,
    input  logic [2:0]  s_axi_awprot,
    input  logic        s_axi_awvalid,
    output logic        s_axi_awready,

    // ----------------------------------------------------------------
    // AXI4-Lite Slave - Write Data Channel
    // ----------------------------------------------------------------
    input  logic [31:0] s_axi_wdata,
    input  logic [3:0]  s_axi_wstrb,
    input  logic        s_axi_wvalid,
    output logic        s_axi_wready,

    // ----------------------------------------------------------------
    // AXI4-Lite Slave - Write Response Channel
    // ----------------------------------------------------------------
    output logic [1:0]  s_axi_bresp,
    output logic        s_axi_bvalid,
    input  logic        s_axi_bready,

    // ----------------------------------------------------------------
    // AXI4-Lite Slave - Read Address Channel
    // ----------------------------------------------------------------
    input  logic [7:0]  s_axi_araddr,
    input  logic [2:0]  s_axi_arprot,
    input  logic        s_axi_arvalid,
    output logic        s_axi_arready,

    // ----------------------------------------------------------------
    // AXI4-Lite Slave - Read Data Channel
    // ----------------------------------------------------------------
    output logic [31:0] s_axi_rdata,
    output logic [1:0]  s_axi_rresp,
    output logic        s_axi_rvalid,
    input  logic        s_axi_rready,

    // ----------------------------------------------------------------
    // I2C Physical Interface (active-low open-drain)
    // ----------------------------------------------------------------
    // -------------------------------------------------------------------------
    // I2C hatlari - AYRIK yon sinyalleri (tri-state modul icinde DEGIL)
    //
    // ASIC akisinda tri-state yalnizca pad halkasinda olabilir. I2C acik
    // drenajdir: hat ya asagi cekilir ya birakilir, asla yukari surulmez.
    // Bu yuzden *_o daima 0'dir ve tum bilgi *_oe'dedir.
    // -------------------------------------------------------------------------
    output logic        sda_o,
    output logic        sda_oe,
    input  wire         sda_i,
    output logic        scl_o,
    output logic        scl_oe,
    input  wire         scl_i,

    // ----------------------------------------------------------------
    // Interrupt Output (TX_DONE veya RX_DONE olduğunda aktif)
    // ----------------------------------------------------------------
    output logic        i2c_irq
);

    // ================================================================
    //  Local Parameters
    // ================================================================
    // Divide each SCL period into 4 equal quarters (phases 0-3).
    //   Phases 0,3 : SCL LOW   |  Phases 1,2 : SCL HIGH
    //   Phase 0    : SDA setup |  Phase 2    : SDA sample point
    // -----------------------------------------------------------------
    // TAM 400 kHz SCL  (9 Eylul 2026)
    //
    // Sartname EK-2: "SCL saat frekansi 400 kHz SABIT hizinda olacaktir."
    //
    // ONCEDEN: QUARTER = SYS_CLK / (4 * I2C_FREQ) idi. 50 MHz'de bu
    // 31,25 eder; tamsayi bolme 31 verir ve gercek SCL 403,2 kHz cikar
    // (+%0,8 sapma, hedefin USTUNDE).
    //
    // COZUM: dort ceyregin TOPLAMI tam periyodu vermelidir. 50 MHz'de
    //     SCL periyodu = 50e6 / 400e3 = 125 cevrim   (TAMSAYI)
    // 125 dorde esit bolunmez, ama son ceyrege kalani vererek toplam
    // korunur:
    //     31 + 31 + 31 + 32 = 125  ->  SCL = 50e6/125 = 400,000 kHz
    //
    // LOW/HIGH orani (31+32)/(31+31) = 1,016 olur; I2C Fast-mode
    // t_LOW >= 1,3 us ve t_HIGH >= 0,6 us isterlerini rahatca saglar
    // (burada t_LOW = 1,26 us, t_HIGH = 1,24 us).
    //
    // Ornekleme noktasi faz 2'nin BASINDA oldugu icin bu uzatmadan
    // etkilenmez; bit_done faz 3'un sonunda oldugu icin dogal olarak
    // uzayan ceyrekle birlikte kayar.
    // -----------------------------------------------------------------
    localparam int PERIYOT     = SYS_CLK_FREQ / I2C_FREQ;        // 125 @ 50 MHz
    localparam int QUARTER     = PERIYOT / 4;                    // 31
    localparam int SON_CEYREK  = PERIYOT - 3 * QUARTER;          // 32
    localparam int CW      = $clog2(SON_CEYREK) > 0 ? $clog2(SON_CEYREK) : 1;

    // ================================================================
    //  I2C FSM States
    // ================================================================
    typedef enum logic [3:0] {
        ST_IDLE     = 4'd0,
        ST_START    = 4'd1,
        ST_ADDR_BIT = 4'd2,
        ST_ADDR_ACK = 4'd3,
        ST_WR_BIT   = 4'd4,
        ST_WR_ACK   = 4'd5,
        ST_RD_BIT   = 4'd6,
        ST_RD_ACK   = 4'd7,
        ST_STOP     = 4'd8
    } state_t;

    // ================================================================
    //  Internal Signals
    // ================================================================

    // -- Peripheral registers --
    logic [31:0] reg_nby;           // 0x00

    // -------------------------------------------------------------------------
    // AXI4-Lite WSTRB destegi
    //
    // wr_val: etkin olmayan baytlarda YAZMACIN ESKI degerini tasiyan birlesik
    // yazma verisi. Bu birimin yazmaclari uzerinde karsilastirma (clamp) ve
    // bit bazli mantik oldugu icin maske yerine birlesik deger kullanmak daha
    // dogru: kodun geri kalani degismeden calisir.
    //
    // Eskiden wstrb goz ardi ediliyordu; sb/sh ile bayt yazmak TUM kelimeyi
    // eziyordu - AXI4-Lite ihlali.
    // -------------------------------------------------------------------------
    logic [31:0] wr_mask;

    assign wr_mask = {{8{s_axi_wstrb[3]}}, {8{s_axi_wstrb[2]}},
                      {8{s_axi_wstrb[1]}}, {8{s_axi_wstrb[0]}}};

    // Hedef yazmaca gore birlesik deger uretir
    function automatic logic [31:0] wr_val(input logic [31:0] old_v);
        wr_val = (old_v & ~wr_mask) | (s_axi_wdata & wr_mask);
    endfunction


    logic [31:0] reg_adr;           // 0x04
    logic [31:0] reg_rdr;           // 0x08
    logic [31:0] reg_tdr;           // 0x0C
    logic [3:0]  reg_cfg;           // 0x10  (only bits [3:0] used)

    // I2C_CFG icin birlesik deger. Tum kontrol bitleri bayt 0'dadir; bayt 0
    // etkin degilse eski deger korunur ve asagidaki mantik hicbir sey
    // degistirmez.
    logic [31:0] cfg_wr;
    assign cfg_wr = ({28'd0, reg_cfg} & ~wr_mask) | (s_axi_wdata & wr_mask);


    // -- I2C FSM --
    state_t      state;
    logic [2:0]  bit_cnt;           // 0..7  bit position in current byte
    logic [2:0]  byte_cnt;          // 0..3  current byte index
    logic [7:0]  shift_out;         // TX shift register (MSB sent first)
    logic [7:0]  shift_in;          // RX shift register (MSB received first)
    logic        op_rw;             // Latched direction: 0 = write, 1 = read
    logic [2:0]  op_nby;            // Latched byte count (1..4)
    logic [6:0]  op_addr;           // Latched 7-bit slave address
    logic [31:0] op_tdr;            // Latched transmit data
    logic [31:0] rx_data;           // Accumulated received bytes
    logic        sda_sampled;       // SDA captured at sample point

    // -- I2C timing --
    // tick_cnt SON_CEYREK'e kadar saymalidir (QUARTER'dan bir buyuk olabilir),
    // bu yuzden genislik CW+1 bit.
    logic [CW:0]   tick_cnt;        // Counts clk cycles within a quarter
    logic [1:0]    phase;           // SCL quarter-phase (0..3)

    // Bu cevrimde kullanilacak ceyrek uzunlugu. Son ceyrek periyodun
    // kalanini tasir; boylece dort ceyregin toplami tam PERIYOT eder.
    logic [CW:0]   ceyrek_uzunluk;
    assign ceyrek_uzunluk = (phase == 2'd3) ? (CW+1)'(SON_CEYREK)
                                            : (CW+1)'(QUARTER);
    logic          i2c_active;
    // Saat germe sinyalleri (kullanimdan once bildirilmeli - asagida
    // surulurler; ayrintili gerekce zamanlama uretecinde aciklanmistir)
    logic [1:0]    scl_snk;         // iki kademeli senkronizator
    logic          scl_hat;         // senkronize edilmis SCL hat degeri
    logic          germe_dur;       // slave hatti tutuyor -> sayaci dondur
    logic          bit_done;        // Pulse: end of a full SCL bit period
    logic          sample;          // Pulse: SDA sample point (mid SCL-high)

    // -- I2C bus control --
    // sda_oe / scl_oe artik MODUL PORTUDUR (tri-state ayrimi sonrasi);
    // burada yeniden bildirilmemeli. Tam proje derlemesi bunu yalnizca
    // uyari veriyordu, tek basina derlemede ise HATA:
    //   [VRFC 10-9336] redeclaration of ANSI port 'sda_oe' is not allowed
    logic          sda_in;          // SDA bus read-back

    // -- AXI internal --
    logic          axi_wr_en;
    logic          axi_rd_en;
    logic [31:0]   rd_mux;

    // ================================================================
    //  Open-Drain Bus Assignments
    // ================================================================
    // Acik drenaj: cikis degeri daima 0, surulup surulmedigini *_oe belirler
    assign sda_o = 1'b0;
    assign scl_o = 1'b0;
    assign sda_in = sda_i;                   // Read-back (harici pull-up)

    // Interrupt: TX_DONE veya RX_DONE olduğunda aktif
    assign i2c_irq = reg_cfg[1] | reg_cfg[3];
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
