barisyamann/2026_Arkhe/(commit log)

2026-06-12 DMA, JTAG, 3to1 Arbiter entegrasyonu, NPU done ve testbench duzeltmeler
2026-06-14 Kaynak kodlar düzeltildi bug fix
    [axi_lite_interconnect.sv, axil_arbiter_2to1.sv, axil_arbiter_3to1.sv, dma_controller.sv, jtag_debug.sv, npu_accelerator.sv, npu_compute_engine.sv, npu_csr.sv]
2026-08-15 FPGA kanit paketi eklendi: utilization, timing, power raporlari ve bitstream
2026-08-15 Fix golden testbench memory read driver
    [tb_npu_golden.sv]
2026-08-15 tb_soc_top: self-checking dogrulama eklendi, PC trace TRACE_ON ifdef'ine alindi
2026-08-18 G05: NPU kesme zinciri ve ISR kuruldu; yoklama kaldirildi, WFI kullaniliyor. Testbench'e UART cozucu eklendi (UART TX ilk kez dogrulandi)
2026-08-18 G05: NPU ve Timer kesmeleri, ISR, WFI ile uyku. Mesgul bekleme dongusu timer kesmesiyle degistirildi. Testbench'e UART cozucu eklendi
2026-08-18 G06: UART-stream -> DMA -> hizlandirici bellegi veri yolu (EK-1 s.21)
    Girdi tensoru artik dis dunyadan geliyor; CPU tasima isine karismiyor.
    UART2 RX (1 Mbps) -> stream FIFO -> UARTS_RDR32 (paketli, 0x4003_0020)
    -> DMA (SRC_FIXED) -> TCM 0x2001_0000 -> NPU
    Donanim:
    - dma_controller: CTRL[2]=SRC_FIXED, CTRL[3]=DST_FIXED. Bir cevre
    biriminin veri yazmacindan akis okumak icin sart; UARTS_RDR32 tek
    adrestir ve her okumada FIFO ilerler.
    - uart_stream_peripheral: UARTS_RDR32 (offset 0x20) dort bayti tek
    kelimede paketliyor. Kelime hazir degilse arready dusuk kaliyor,
    DMA bekliyor - gecersiz veri dondurmek yerine geri bastiriliyor.
    Duzeltilen hatalar:
    - Paketleyicide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
2026-08-18 evidence: sistem testi kanit logu tazelendi (G05+G06 dahil)
    Onceki log 16 Agustos'tandi; kesme zinciri, UART cozucusu ve
    UART-stream/DMA veri yolu icinde yoktu.
    Yeni log kenar tetikli kesme izleyicisiyle alindi: DMA kesmesi
    onceki halde 190 satir basiyordu, simdi iki satir - yukselen kenar
    ve temizlenme. Aradaki fark ISR gecikmesini de olcuyor: 3,74 us.
    56,04 ms simulasyon, 0 hata, 50 satir.
2026-08-18 evidence: FPGA v5 olcumu (kesme zinciri + UART-stream veri yolu)
    WNS +2,431 ns WHS +0,035 ns
    16.856 LUT (%26,59) · 5.207 FF (%4,11) · 13 BRAM · 9 DSP
    v4'e gore +21 LUT, +38 FF; BRAM ve DSP degismedi. WNS 0,099 ns eridi:
    UART-stream paketleyici kayitlari ve DMA sabit adres coklayicilari
    kritik yolu kil payi uzatti. Marj yeterli, mudahale gerekmiyor.
2026-08-18 G07: UART_RDR bayt okuma duzeltildi, paketleyicinin bayt calmasi onlendi
    1) UART_RDR (0x08) bir eksik bayt donduruyordu
    sync_fifo cikisi yazmaclidir; o_rd_data i_rd_en'den bir cevrim sonra
    gecerli olur. AXI okumasi ayni cevrimde tamamlandigi icin her zaman bir
    ONCEKI bayt donuyordu: ilk okuma cop, son bayt hic okunamiyordu.
    Okuma iki asamali yapildi (rdr_fetch_r -> rdr_valid_r).
    FIFO bossa okuma bloklamiyor, sifir donduruyor. Bloklamak, durum
    yazmacina bakmadan okuyan bir yazilimi kilitlerdi.
    2) UARTS_RDR32 toplayicisi bayt caliyordu
    Toplayici FIFO bos olmadigi surece KOSULSUZ bayt cekiyordu. Yazilim
    EK-2'nin tanimladigi UART_RDR yazmacindan okumaya calissa bile baytlar
    toplayiciya gidiy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
2026-08-18 G07: UART_RDR bayt yolu icin sistem testi eklendi
    Onceki commit'teki iki duzeltme hicbir test tarafindan uyarilmiyordu.
    CPU artik DMA bittikten sonra UARTS_LEVEL'i yoklayip dort bayt bekliyor,
    UART_RDR'den okuyup "RDR: A1B2C3D4" yaziyor; testbench satiri birebir
    karsilastiriyor.
    Tek satir iki duzeltmeyi birden koruyor:
    - FIFO okuma gecikmesi geri alinirsa sonuc kayar (RDR: 00A1B2C3)
    - pack_arm geri alinirsa toplayici dort bayti yutar, UARTS_LEVEL
    hic 4'e ulasmaz ve CPU yoklama dongusunde kalir
    Olculen: 57,414530 ms, 0 hata. UART_RDR testi ~1,4 ms ekledi.
2026-08-18 G07: veri yolu hata kesmesi (R8) + timer SLVERR hatasi
    obi_to_axi_simple AXI yanit kodunu (bresp/rresp) hic okumuyordu. Bir
    kole SLVERR/DECERR dondurdugunde CPU normal tamamlanma goruyor,
    haritalanmamis yazma sessizce yutuluyor, hatali okuma cop veriyi gercek
    gibi donduruyordu.
    Kurulan yol:
    AXI kolesi SLVERR -> kopru (bir cevrimlik darbe + adres)
    -> jtag_debug (yapiskan) -> irq_vector[20] -> ISR
    Yazmaclar jtag_debug'a kondu; ayri bir AXI kolesi eklemek 607 satirlik
    elle acilmis ara baglantida ~60 noktaya dokunmayi gerektirirdi.
    0x4008_0014 FAULT_ST [0] hata var, [1] buyruk kopru, [2] veri kopru
    0x4008_0018 FAULT_ADDR hatayi doguran adres
    0x4008_001C FAULT_CLR 1 yaz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
2026-08-18 G07: lint temizligi + 9/9 cevre biriminde AXI4-Lite WSTRB uyumlulugu
    Ayri lint araci kurulu degildi; Vivado'nun sentez logu kendi
    modullerimiz icin tarandi (CV32E40P cekirdegi haric).
    Latch: 0. Iki yanlis pozitif elendi (bloklayici atamali yerel
    degiskenlerin optimizasyon artiklari - npu_compute_engine). Kucuk
    duzeltme: jtag_debug'da bus_rdata_result kullanimindan once bildirildi.
    ANA BULGU: sentez logu 100 adet "wstrb unconnected" uyarisi verdi -
    DOKUZ cevre biriminin hepsinde (timer, i2c, jtag_debug, uart x2, qspi,
    npu_csr, dma, gpio). AXI4-Lite wstrb, hangi baytlarin yazmaya dahil
    oldugunu belirtir; yok sayilinca sb/sh ile bayt yazmak DAIMA tum
    kelimeyi eziyordu. Yazilimimiz hep kelime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
2026-08-18 G07: tri-state ayrimi - soc_top ASIC'e hazir sinir (RTL seviyesi tamamlandi)
    ASIC akisinda ucdurumlu surucu yalnizca pad halkasinda bulunabilir;
    sentez araclari modul icindeki 'z surumunu esleyemez. LibreLane'in
    sertlestirecegi modul soc_top oldugu icin sinir orada cizildi.
    qspi_master : inout qspi_io0..3 -> qspi_io_o/_oe/_i [3:0]
    i2c_peripheral : inout sda, scl -> sda_o/_oe/_i, scl_o/_oe/_i
    soc_top : 6 x inout -> ayrik ucluler
    QSPI'da cikis-etkin HAT BASINADIR; eski kosullu 'z atamalari birebir
    tasindi (tek hatli modda io0, ikilide io0-io1, dortlude dordu birden).
    I2C acik drenajdir: *_o daima 0, tum bilgi *_oe'de. Hat asla yukari
    surulmez, harici pull-up ce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
2026-08-18 R10: OBI->AXI koprusunde islem basina bir cevrim kazanimi
    ST_IDLE istek geldiginde yalnizca adresi mandalliyor, AXI'ye hicbir sey
    surmuyordu; adres fazi bir sonraki cevrimde basliyordu. Her islemde bir
    cevrim bosa gidiyordu.
    Artik istek geldigi cevrimde AR (veya AW+W) DOGRUDAN suruluyor. Kole
    hazirsa el sikisma ayni cevrimde tamamlanir ve dogrudan veri/yanit
    fazina gecilir.
    AXI uyumu korundu: kole hazir degilse VALID yuksek kalarak eski duruma
    gecilir ve adres addr_q'dan surulur - ayni deger, kararli.
    Olculen (NPU'yu etkilemez; NPU TCM'e Port B'den dogrudan erisir):
    Acilis fazi : DMA baslangici 16.220.610 -> 15.533.430 (687 us)
    Sistem testi : 42,69 ms -> 41,96 ms, 0 hata
    Kazanc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
2026-08-18 R3: I2C oz testi + islevsel kapsama genisletmesi; R10 geri alindi
    R3 - KAPSAMA
    Denetimdeki oranlar (statement %46,6 / branch %30,1 / toggle %21,5) DMA,
    UART-stream ve kesmeler hic calismazken olculmustu. Bugun hepsi gercek
    veriyle uyariliyor. Yedi yeni islevsel kapsama noktasi eklendi: dort
    kesme kaynagi, DMA'nin alti durumu, UART-stream FIFO doluluk bolgeleri,
    NPU sinif cikisi, hata koprusu kaynagi, AXI yanit kodlari ve
    kesme x sinif caprazi.
    I2C OZ TESTI - kapsamadaki en buyuk gercek delik kapandi
    I2C sartnamenin ZORUNLU tuttugu bir cevre birimi ama bugune kadar
    hicbir test onu uyarmiyordu. Denetimin R3'teki elestirisi tam da buydu:
    dusuk kapsami "kullanilmayan bloklar" diye savunmak ya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
    [main.c, obi_to_axi_simple.sv, tb_soc_top.sv]
2026-08-18 B8: i2c blok testbench'i gercekten calisir hale getirildi - 7/7 gecti
    BULGU: i2c_peripheral_tb hicbir seyi dogrulamiyordu.
    DUT (.*) ile baglaniyordu ama modul portlari s_axi_*, testbench sinyalleri
    s_axil_* adini tasiyor. Adlar eslesmedigi icin AXI portlarinin HICBIRI
    baglanmiyordu; testbench sinyalleri bosluga suruyordu. Derleniyor,
    kosuyor, "PASS" yazdirabiliyordu - ama DUT'a hic dokunmuyordu.
    Bu, denetimin B8'de tarif ettigi durumun en net ornegi.
    RTL tarafinda duzeltilenler (tri-state ayrimindan kalan artiklar):
    - sda_oe / scl_oe hem port hem ic sinyal olarak bildirilmisti.
    Tam proje derlemesi UYARI veriyordu, tek basina derlemede HATA:
    [VRFC 10-9336] redeclaration of ANSI p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
2026-08-18 B9: GERCEK QSPI BOOT ilk kez uctan uca dogrulandi - 0 hata
    QSPI adres fazi duzeltmesinden (747f734) sonra REAL_BOOT akisi
    calistirildi ve TAMAMI GECTI.
    Boot ROM -> QSPI flash -> I-RAM -> jalr -> uygulama
    Bu zincir bugune kadar HIC dogrulanmamisti: varsayilan testbench hizli
    acilis kullaniyor (I-RAM'e dogrudan yukleme) ve QSPI yolunu atliyordu.
    Adres fazi hatasi da tam bu yuzden gorunmuyordu.
    Kosum: 48,80 ms, 0 hata, 11 denetim
    fc_acc/probs hizli acilisla BIREBIR AYNI (0/1050/1050/1995)
    JTAG, DMA, UART-stream, I2C, veri yolu hatasi - hepsi gecti
    TESTBENCH: zaman asimlari acilis moduna gore ayarlandi.
    Gercek boot'ta yukleyici 8 kB uygulamayi flash'tan okur; prescaler 4'te
    SCK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
    [tb_soc_top.sv]
2026-08-18 B8 KAPANDI: uart_tb ve tb_jtag_debug self-checking - 21/21 ve 14/14
    uart_tb.sv
    ----------
    check() ve gozcu vardi ama hata durumunda "Lutfen kontrol edin" yazip
    $finish ile NORMAL cikiyordu - otomasyon acisindan basarili sayiliyordu.
    Dosyanin basliginda "Self-checking yapi (manuel inceleme gerektirmez)"
    yazmasina ragmen tam olarak manuel inceleme istiyordu.
    Zaman asimi da $finish ile bitiyordu; asili kalan test de basarisizdir.
    Ikisi de $fatal yapildi, hic denetim kosmama durumu da hata sayildi.
    Sonuc: 21 denetim, 0 hata (CPB 50/434, uc stop bit modu, TX/RX
    bayraklari, dort veri deseni loopback, FIFO, kesme).
    tb_jtag_debug.sv - YENIDEN YAZILDI
    -----------------------------------
    Eski surum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
2026-08-18 R3: regresyon betigi - 6/6 test, 55 denetim, tek komutla
    Sartname s.297: "regression ve coverage sonuclarinin raporlanmasi
    degerlendirme puanini yukseltecektir."
    scripts/run_regression.py tum blok testlerini derleyip kosuyor ve
    ozet tablo basiyor. Hata varsa sifir olmayan cikis kodu doner - CI'ya
    dogrudan baglanabilir.
    uart GECTI 21 denetim
    i2c GECTI 7 denetim
    qspi GECTI 3 denetim
    jtag_debug GECTI 14 denetim
    npu_blok GECTI 9 denetim
    npu_golden GECTI 1 denetim
    ---------------------------------
    6/6 gecti, 55 denetim, ~18 saniye
    Betigi yazarken iki hata cikti, ikisi de duzeltildi:
    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
2026-08-20 B2: 23 SRAM makrosu entegre edildi, sistem testi makro kipinde GECTI
    Makro: sky130_sram_2kbyte_1rw1r_32x512_8 (SKY130A PDK, OpenRAM uretimi)
    512 kelime x 32 bit, bayt granuler yazma, Port0 RW + Port1 R
    683,1 x 416,54 um = 0,285 mm2
    Kullanim (23 ornekleme, 6,54 mm2):
    NPU TCM 30 kB -> 15 makro u_npu/u_npu_sram
    I-RAM 8 kB -> 4 makro u_instruction_ram
    D-RAM 8 kB -> 4 makro u_data_ram
    Kosullu derleme: USE_SRAM_MACRO tanimliyken gercek makro, tanimsizken
    cikarimsal dizi (FPGA Block RAM cikarimi korunuyor). Her iki kipte de
    regresyon geciyor.
    Flip-flop sayisi ~391.000 -> ~14.000. Ilk sentez denemesi ABC asamasinda
    bir saatten fazla takilmisti; sebebi bu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
    [npu_compute_engine.sv, npu_csr.sv, npu_tcm_sram.sv, sky130_sram_2kbyte_1rw1r_32x512_8.v, sram_module.sv, tb_soc_top.sv]
2026-08-20 ASIC: ilk basarili sentez - 23 makro netlist'te, 7,17 mm2
    evidence/asic/OLCUMLER.md olusturuldu. FPGA tarafindaki OLCUMLER.md'nin
    karsiligi; her degisikligin bedelini kaydetmek icin taban noktasi.
    Standart hucre : 47.926 (0,631 mm2)
    SRAM makrosu : 23 (6,54 mm2)
    Toplam cekirdek : ~7,17 mm2
    Flip-flop : 10.908
    Lint hatasi : 0
    FLIP-FLOP DUSUSU: ~391.000 -> 10.908
    Makro oncesi Yosys/ABC 391 bin flip-flop uzerinde calisiyordu ve sentez
    bir saatte tamamlanamadi. Bu bir performans sorunu degil, ASIC'te
    bellegin cikarimsal dizi olarak birakilamayacaginin kaniti.
    SARTNAME DOGRULAMASI:
    grep -c "sky130_sram_2kbyte_1rw1r_32x512_8" soc_top.nl.v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
    [npu_tcm_sram.sv, sky130_sram_2kbyte_1rw1r_32x512_8.v, sram_module.sv]
2026-08-20 Belge duzeltmeleri, versions.txt, ASIC ara sonuclari
    DAYANAKSIZ DOGRULAMA IDDIASI GERI CEKILDI
    -----------------------------------------
    tb/T2.1_core_trace/compare_trace.py "Spike ISS referans modeli ile %100
    uyumlu" iddiasini uretiyordu. Denetimde ortaya cikti ki:
    - Spike ISS hicbir zaman kurulmadi ve kosturulmadi. "Referans model"
    dedigi sey kaynak koda elle yazilmis 20 elemanli sabit bir diziydi.
    - Dizi guncel bootloader'a da uymuyordu: 0x08 ve 0x0a adreslerindeki
    RV32C sikistirilmis (2 baytlik) buyruklari hesaba katmiyor, her
    buyrugu 4 bayt sayiyordu.
    compare_trace.py kaldirildi. Yerine trace_check.py kondu: referansi
    uydurmuyor, dogrudan bootloader.elf'in objdump cikti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
2026-08-20 Makro guc baglantisi ve halo duzeltmesi; 5. kosum yamasi hazirlandi
    3. KOSUM DUSTU - iki gercek sorun ortaya cikti.
    1) MAKRO GUCU BAGLI DEGILDI (gozden kacmisti)
    PDN adimi 46 uyari veriyordu:
    [PDN-0231] u_data_ram.g_sram[0].u_macro is not connected to any
    power/ground nets.
    23 makro x 2 pin. Bu haliyle makrolarin fiziksel tasarimda gucu yok,
    LVS gecmez. PDN_CONNECT_MACROS_TO_GRID zaten true idi ama tek basina
    yetmiyor - hangi pinin hangi aga baglanacagi acikca verilmeli.
    Ust seviye ag adlari DEF SPECIALNETS bolumunden (VPWR/VGND), makro
    pinleri LEF'ten (vccd1/vssd1) okundu:
    PDN_MACRO_CONNECTIONS: [".*u_macro VPWR VGND vccd1 vssd1"]
    4. kosumd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
2026-08-21 Yerlesim duzlemi ureticisi - elle hesap yerine betik
    Bes ASIC kosumu boyunca makro izgarasi ve DIE_AREA elle hesaplandi.
    Betige donusturuldu; kosum gecmisi de icine yazildi.
    Mevcut geometriyi birebir yeniden uretiyor: 3832,40 x 3999,24 = 15,33 mm2.
    UST KENAR PAYI AYRI PARAMETRE
    3, 4 ve 5. kosumun ucu de ayni hatayla dustu:
    [DRT-1231] Pin u_data_ram.g_sram[N].u_macro/... no access point
    Ucunde de dusen makro EN UST SIRADAYDI (y = 3332,7); ustunde die
    kenarina 250 um vardi. Anten onariminin diyotlari orayi doldurunca
    pin erisimi kapandi. Bu yuzden ust pay artik ayri ayarlaniyor.
    Senaryolar:
    ust 250 (mevcut) 15,33 mm2 makro %42,7
    ust 500 16,28 mm2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
2026-08-21 Regresyon yeni yapiya uyarlandi, olcum belgelendi
    run_regression.py: npu_blok ve npu_golden testleri artik
    npu_weights_pkg.sv'yi kaynak listesine aliyor (modulden ONCE) ve
    agirlik .mem kopyalamasi kaldirildi - agirliklar RTL'e gomulu.
    test_input_pattern.mem kaldi; o testin GIRDISI, agirlik degil.
    evidence/asic/READMEMH_BULGUSU.md: cozum ve olcum bolumu eklendi.
    OLCUM SONUCU - fc_weights mantik olarak
    Standart hucre 47.926 -> 87.850 (+39.924, +%83)
    Cip alani 0,631 -> 1,028 mm2 (+%63)
    Flip-flop 10.908 -> 11.586 (+678)
    const-x silinen 32+ -> 0 COZULDU
    Tahmin araligi 40.000-90.000 idi; gercek 39.924 cikti. Yosys
    memory_bmux2rom ile 259.143 donusum yapip ver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
    [run_regression.py]
2026-08-21 Vivado uyumunun maliyeti olculdu ve belgelendi
    Ayni tasarim, iki bicim, Yosys sentezi:
    Standart hucre 87.850 -> 109.963 (+22.113, +%25)
    Sentez suresi 20:32 -> 42:42 (+%108)
    Flip-flop 11.586 -> 11.586 (ayni)
    SRAM makrosu 23 -> 23 (ayni)
    Sebep: unpacked dizi Yosys'in memory_bmux2rom yolunu tetikliyor ve ROM
    kendi ic gosterimiyle optimize ediliyor. Parcali packed bicimde tablo
    siradan sabit vektordur, ustune 4 yollu case secici ekleniyor.
    Kabul edilebilir: die'da %13 doluluk. Alternatif Vivado'nun hic
    calismamasiydi. ifdef ile araca gore bicim secmek dusunuldu ve
    REDDEDILDI - tam olarak kurtulmaya calistigimiz araclar-arasi ayrisma
    budur.
    6. kosum durumu: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
2026-08-21 Lisans dizini dolduruldu - teslim gerekliligi
    asic/licenses/ BOSTU. THIRD_PARTY.md satir 18 acikca
    licenses/cv32e40p-LICENSE dosyasini gosteriyordu ama dosya yoktu.
    Eklendi:
    cv32e40p-LICENSE Solderpad v0.51, saticidan degistirilmeden
    (rtl/cv32e40p-master/LICENSE)
    Apache-2.0.txt standart Apache 2.0 metni
    README.md bilesen-lisans eslesme tablosu, SPDX kimlikleri
    Bes bilesen kapsandi: CV32E40P, PULP common cells (SHL-0.51);
    SKY130 PDK, SRAM makrosu, LibreLane (Apache-2.0).
    SKY130 ve LibreLane kurulumlari lisans metnini ayri dosya olarak
    dagitmiyor; metin standart kaynaktan alindi, projeye ozel degisiklik
    icermiyor. README bunu belirtiyor.
    Makro mode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
2026-08-21 Karar gunlugu: teslim sonrasi yeniden degerlendirilecek iki madde
    FPU=0 ve NPU agirliklarinin mantik olarak sentezlenmesi bu teslim icin
    KAPALI ama kalici degil. Ikisi icin de yeniden bakma kosullari ve
    gereken olcumler yazildi.
    FPU=0
    Kayan nokta soft-float ile calisir, 20-50 kat yavas. Agir FP isi
    gerekirse (MFCC, PID, sensor fuzyonu) darbogaz olur.
    Bu teslimde eklenmedi: setup payi henuz kapanmadi, tam dongu 3+ saat,
    10 gun kaldi. ASIC'teki maliyeti henuz OLCULMEDI.
    NPU agirliklari
    145.024 bit kombinasyonel ROM. Netlist dogruluyor: 11.586 flip-flop
    (%10,5), 98.377 kombinasyonel (%89,5), 0 latch. Yazmaca konsaydi
    145.024 flip-flop gerekirdi.
    Bilinen bedel: fc_idx[3] fanout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
2026-08-22 README Final Ciktilar Bolum 9 yapisina gore yeniden yazildi
    13 zorunlu baslik da dolduruldu. Teslim denetleyicisi dogruladi:
    eksik README basligi 13 -> 0.
    ICERIK
    1 Tasarim ozeti port listesi, saat/reset, hedef frekanslar
    2 Arac ve ortam LibreLane v3.0.6, PDK commit, flake.lock pinleri
    3 Akisin calistirilmasi make asic_run, olculen sureler, donanim onerisi
    4 RTL ve akis girdileri filelist.f, include, tanimlar, tutarlilik denetimi
    5 SRAM ve makrolar 23 ornek, instance adlari, guc pinleri, PVT varsayimi
    6 Zamanlama kisitlari iki saat, asenkron grup, iki false path + gerekce
    7 Fiziksel tasarim die, makro izgarasi, halo/kenar payi GEREKCELE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
    [boot_rom_pkg.sv, gen_rom_paketleri.py, npu_compute_engine.sv, npu_weights_pkg.sv, run_regression.py, tb_soc_top.sv]
2026-08-22 Dogrulama derinlestirildi: 5 RTL hatasi bulundu, regresyon 66 -> 293 denetim
    RTL DUZELTMELERI
    qspi_master: yazma yolunda iki hata (PP testi ilk kez yazilinca cikti)
    1. WRITE_DATA cikis surucusu kenar kontrolunun icindeydi; duruma
    girilen cevrimde io0 bayat ADRES bitini tasiyor, ilk veri biti
    bir SCK cevrimi gec cikiyordu (0x78 -> 0x3C).
    2. tx_byte_idx==3 dali her zaman yeni kelime cekiyordu; case
    icindeki 2'd3 kolu ULASILAMAZDI, yani her kelimenin 4. bayti
    hic gonderilmiyordu. 256 baytlik sayfa programlamada 64 bayt
    yanlis olurdu. Boot yolu etkilenmemisti (yalnizca READ kullanir).
    dma_controller: AW ve W'nin AYNI cevrimde kabulunu sart kosuyordu.
    AXI4-Lite'ta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
2026-08-23 asic: filelist denetleyicisi LibreLane runs/ dizinlerini her derinlikte atlasin
    Denetleyici yalnizca ust duzey run/ dizinini atliyordu. LibreLane
    ciktilarini <tag>/runs/RUN_<tarih>/ altina yazar; asic/uart_tx_smoke/runs/
    altindaki uretilmis netlistler (.nl.v/.pnl.v) 'asic/ altinda RTL' sanilip
    akis daha baslamadan duruyordu. Uretilmis netlist kaynak degildir.
2026-08-23 evidence: F2 QSPI flash baglantisi ve programlama yordami belgelendi
    Iki sessiz tuzak (STARTUPE2 saat yolu, bitstream uzerine ofset), pin
    atamalari, Vivado programlama adimlari ve boot ROM imajini yeniden
    uretme zorunlulugu yazildi. Bu bilgi hicbir yerde kayitli degildi.
2026-08-23 NPU agirliklari acilista flash'tan TCM'e yukleniyor + weights_ready korumasi
    FC agirliklari TCM/SRAM'e tasindiginda ortaya cikan asil sorun cozuldu:
    SRAM UCUCUDUR, uretilmis cipte guc verildiginde TCM bostur. Simulasyonda
    testbench $readmemh ile dolduruyordu; gercek cipte bunu yapacak kimse
    yoktu. Yani o haliyle uretilen cipte NPU HER SESE AYNI CEVABI verirdi.
    BIR: WEIGHTS_READY KORUMASI (npu_csr.sv)
    assign start_o = reg_start && reg_weights_ready;
    CTRL bit 4 bayragi kurar (yapiskan), STATUS bit 3'ten geri okunur.
    Bayrak kurulmadan START kabul edilmez. Boylece "agirliksiz kosma"
    sessiz bir yanlis sonuc yerine acik bir davranisa donusur.
    Bayragi yalnizca SISTEM reseti (rst_n) temizler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
    [boot_rom_pkg.sv, gen_flash_image.py, main.c, npu_csr.sv, run_regression.py, tb_soc_top.sv]
2026-08-23 CONV_MAC uc asamali boru hattina cevrildi - ASIC kritik yolu ikiye bolundu
    SORUN
    Yerlestirme-sonrasi STA'da 130 setup ihlali vardi:
    nom_tt WNS -4,00 ns 130 ihlal
    nom_ss WNS -18,76 ns 1000+ ihlal
    nom_ff temiz
    Ihlallerin bitis yazmaclari netlist'ten cikarildi:
    121 u_npu.u_npu_engine.conv_acc
    8 u_npu.u_npu_engine.rq_ab
    1 u_core.alu_operand_a_ex
    fc_weight_word veya fc_acc bitisli TEK BIR IHLAL YOK.
    TESHIS DUZELTMESI
    Onceki raporda bu ihlaller "FC agirliklarinin SRAM'e tasinmasinin
    bedeli" diye yazilmisti. YANLISTI. Yollar TCM SRAM'inden BASLIYOR ama
    CONV_MAC'te BITIYOR - konvolusyon zaten girdiyi TCM'den okuyordu
    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
2026-08-23 Dort sartname isteri test edildi: 256B sayfa, UART_CFG[0], REUSE, prescaler
    Uyum raporunda "KANIT EKSIK" / "KRITIK" isaretli dort madde kapatildi.
    Hepsi once OLCULDU, sonra duzeltildi veya dogrulandi.
    1) QSPI 256 BAYTLIK SAYFA (sartname s.1056-1057, zorunlu)
    Mevcut PP testi yalnizca 4 BAYT yaziyordu. Artik 64 kelime (256 bayt)
    yazilip TAMAMI geri okunarak denetleniyor. Her kelime indise bagli
    farkli desen tasiyor - tek tip desen kaymalari gizlerdi.
    Bu sirada gercek bir altyapi sorunu cikti: test flash modeli yalnizca
    32 BAYTTI (TEST_WORDS=8) ve gecersiz adres icin sessizce 0x00
    donduruyordu. Yani 256 baytlik bir test yazilsaydi bile sessizce
    sifir okur, "gectI" gorunurdu. Model 512 bayta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
2026-08-24 NPU adres yolu yazmaclandi - 275 setup ihlali hedefleniyor
    Yerlestirme-sonrasi STA (nom_ss) ihlallerini netlist eslemesiyle
    siniflandirdim:
    D-RAM SRAM -> CV32E40P 322 ihlal en kotu -4,50 ns
    NPU mantik -> NPU TCM SRAM 275 ihlal en kotu -5,42 ns
    CV32E40P -> CV32E40P 258 ihlal en kotu -5,91 ns
    NPU -> NPU 87
    UART -> UART 33
    Ilk siniflandirmam YANILTICIYDI: max.rpt icinde normal flip-flop'lar
    sentezlenmis adla (_121995_) gorunur, yalnizca SRAM makrolari
    hiyerarsik adini korur. Ham metne bakinca NPU kaynakli yol 3 gorundu;
    netlist eslemesiyle gercek sayi 362 cikti.
    Bunun icin iki analiz betigi eklendi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
    [npu_compute_engine.sv]
2026-08-24 Spike ISS karsilastirmasi ve UVM AXI4-Lite passive agent
    Sartname s.569 (Spike ISS beklenmektedir) ve 4.2.2 / 5.2 (AXI arayuzlerinin
    UVM agent'lariyla protocol check duzeyinde dogrulanmasi) kapatildi.
    SPIKE ISS
    Spike 1.1.1-dev kuruldu ve kosturuldu. DTR'deki "ilk 20 buyruk 20/20
    eslesti" iddiasi gercek bir kosuma dayanmiyordu; elle yazilmis sabit bir
    PC listesine karsi karsilastirma yapiliyordu.
    Gercek olcum: 409 buyruk, 0 PC uyusmazligi, 0 makine kodu uyusmazligi.
    sw_nexys/src/core_test.c - cevre birimi kullanmayan cekirdek testi.
    Spike ciplak cekirdegi modeller; main.c UART'a yazdigi anda izler
    platform farkindan ayrisir.
    Tohumlar YEREL volatile: static olsalardi .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
2026-08-24 asic: 6. kosum ciktilari - LVS gecti, KLayout DRC temiz, GDS uretildi
    Buyuk ikili dosyalar Git LFS ile tutuluyor. SDF ve IR-drop CSV'leri
    sikistirildi; araclar .gz bicimini dogrudan okuyor.
    Acik: Magic DRC 7659 (tamami nwell.4), hold 7 kosede, max cap/slew.
    Gecen: Netgen LVS, KLayout DRC, Checker.XOR.
    [metrics.csv, wire_lengths.csv]
2026-08-24 asic: 6. kosum bulgulari - hold ve max cap/slew kok nedenleri duzeltildi
    HOLD (8 ihlal, max_ff)
    Kok neden: RUN_POST_GRT_RESIZER_TIMING false idi. Hold yalnizca CTS
    sonrasi TAHMINI parazitiklerle onarildi; gercek yonlendirme gecikmeleri
    eklendikten sonraki ihlalleri yakalayacak gecis hic kosmadi.
    Ayrica RSZ_CORNERS tanimsizdi - hold onarimi hizli kosede yapilmali,
    ihlaller tam da orada (max_ff, -40C/1,95V).
    Ihlallerin hicbiri CV32E40P'nin kendi mantiginda degil:
    UART2 RX sayaci/FSM 2, NPU->SRAM 3, I-RAM->CPU 2, D-RAM adres 1
    Duzeltme: RUN_POST_GRT_RESIZER_TIMING true,
    GRT_RESIZER_HOLD_SLACK_MARGIN 0.05 -> 0.1,
    RSZ_CORNERS = tt + ff + ss
    MAX CAP / M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
2026-08-24 asic: PL_TIMING_DRIVEN geri alindi - OpenROAD ic hatasi
    7. kosum 28-openroad-globalplacement adiminda coktu:
    [INFO GPL-0100] Timing-driven iteration 1/2, virtual: false.
    [CRITICAL RSZ-2007] buffering pin _061835_/X: wire step options empty
    OpenROAD boyutlandiricisinin tamponlama algoritmasinin ic hatasi. Ayar
    mesru ve LibreLane tarafindan destekleniyor; bu surum bu tasarimda o kod
    yoluna girince cokuyor.
    KAYIP SINIRLI: coktugu andan hemen once kosan repair_design basariyla
    bitti ve SDC duzeltmemizin calistigini kanitladi:
    1576 fanout + 941 slew + 786 capacitance ihlali BULUNDU
    final: +1,6% alan, 153 boyutlandirma, 12648 tampon, 2452 ag onarildi
    6. kosumda bu sayilar sifir g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
2026-08-25 evidence: 7. kosum analizi - saat surucu modeli hatasi ve kazanclar
    7. KOSUM ILK KEZ BASTAN SONA TAMAMLANDI (117 adim, 4s51dk).
    KAZANCLAR
    Anten 23 ag / 33 pin -> 6 ag / 6 pin
    LVS gecti
    KLayout DRC 0
    Yonlendirme DRC 0
    GERILEME VE KOK NEDENI
    nom_tt setup WNS +0,947 -> -0,763
    max_ss setup WNS -6,314 -> -17,081
    max_ff hold reg->reg 8 -> 70
    Sebep: set_driving_cell [all_inputs] yazilmisti ve SAAT PORTLARI da
    listeye giriyordu. inv_2 kucuk bir ic evirici; saat giris aginin 0,562 pF
    yukunu surunce clkbuf girisinde 2,99 ns (tt) / 4,24 ns (ss) kenar uretti.
    Bozukluk raporla sinirli kalmadi: CTS saat agacini bu modele gore kurdu.
    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
2026-08-25 asic: makro yerlesimi gruplara gore toplandi + 8. kosum kaniti
    MAKRO YERLESIMI
    Onceki durum: 4x6 izgara SIRAYLA dolduruluyordu, grup sinirlarina
    bakilmiyordu. I-RAM'in 4 makrosundan biri sag ucta (2899, 2100), uc
    tanesi bir alt sirada solda kaliyordu; D-RAM'de aynisi. Her iki bellek
    grubu cipin TAM GENISLIGINE (3,3 mm) yayilmisti.
    tt kosesindeki en kotu yol tam da 'u_data_ram SRAM -> CPU' idi.
    Yeni duzen:
    sira 1-3 : NPU TCM (12)
    sira 4 : NPU TCM ( 3) + bos yuva
    sira 5-6 : I-RAM 2x2 (sol) | D-RAM 2x2 (sag)
    Ayak izi: I-RAM 3332x1033 -> 1566x1033
    D-RAM 3332x1033 -> 1566x1033
    DEGISMEYENLER: cip boyutu, kanal genisligi (200 um), halo (30 um),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
2026-08-25 rtl: UART FIFO kritik yolu kesildi + hold onarimi guclendirildi
    FIFO KRITIK YOLU (9. kosum ss worst path)
    u_uart2.u_rx_fifo.rd_ptr_r[0] -> u_uart2.u_rx_fifo.mem[25][0]
    98 hucre, -8,026 ns. En kotu SEKIZ bitis noktasinin tamami ayni
    FIFO'nun mem[...] hucreleriydi.
    Kok neden sync_fifo.sv'de:
    assign o_level = wr_ptr_r - rd_ptr_r; // 9 bit cikarma
    assign o_full = (o_level == DEPTH[PTR_W:0]); // 9 bit karsilastirma
    if (i_wr_en && !o_full) mem[...] <= i_wr_data; // 2048 FF yazma izni
    Duzeltme iki asamali:
    1) Dolu/bos tespiti CIKARICIDAN AYRILDI. Isaretciler fazladan sarma
    biti tasidigi ve DEPTH ikinin kuvveti oldugu icin dolu durumu
    dogru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
2026-08-25 asic: 10. kosum hold ayarlari geri alindi - ikisini birden kaybettirdi
    10. KOSUM DENEYI BASARISIZ
    Degisen: GRT_RESIZER_HOLD_SLACK_MARGIN 0,1 -> 0,30
    PL_RESIZER_HOLD_SLACK_MARGIN 0,1 -> 0,20
    GRT/PL_RESIZER_FIX_HOLD_FIRST false -> true
    Sonuc (9. kosum -> 10. kosum):
    nom_ss setup -6,665 -> -15,269
    max_ss setup -8,026 -> -17,619
    max_tt setup +0,915 -> +0,531
    hold reg->reg 687 -> 1147
    Suclu tek satirda:
    [INFO RSZ-0032] Inserted 11749 hold buffers.
    FIX_HOLD_FIRST boyutlandiriciya 'once hold' dedirtti, o da veri
    yollarina 11.749 geciktirme tamponu ekledi. Her tampon gecikme demek;
    ss setup 8,6 ns co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
    [run_regression.py]
2026-08-28 asic: arkhe25 imzalama paketi (34,2 MHz, LVS temiz, KLayout DRC 0)
    78/78 adim tamamlanan arkhe25 kosumunun teslim ciktilari.
    - LVS Passed, KLayout DRC 0 hata, anten 1 net / 1 pin
    - Dokuz kose STA: gereken periyot 29,23 ns, yani 34,2 MHz
    - Tek gercek reg-to-reg hold ihlali: max_ff kosesinde -49 ps
    - max_ss teki -0,2071 hold bir IO yoludur; orada r2r hold +0,9517
    GDS, DEF, netlistler ve raporlar sikistirilmis olarak eklendi (122 MB).
    Dizine ozel .gitattributes ile LFS devre disi birakildi: dosyalarin hepsi
    100 MB sinirinin altinda ve mevcut LFS deposu 957 MB ile 1 GB'lik ucretsiz
    kotanin sinirinda.
    [metrics.csv]
2026-09-08 kanit: dogrulama belgeleri, FPGA kart kaydi ve bellek imajlari
    evidence/dogrulama/SRAM_OKUMA_BORU_HATTI_DOGRULAMA.md
    SRAM okuma yolundaki kombinasyonel bypass'in kaldirilmasinin
    fonksiyonel dogrulamasi: 347 denetim, Spike ISS 409/0, yogunluk
    deneyleri tablosu.
    evidence/asic/ZAMANLAMA_INCELEME_REHBERI.md
    Bagimsiz bir incelemecinin zamanlama sonuclarini nasil dogrulayacagi.
    Yarim cevrim yolu (SRAM dusen kenarda surer, CPU yukselen kenarda
    yakalar) ayrica aciklandi.
    evidence/fpga/kart_testi_20260826.log
    Nexys A7-100T uzerinde canli UART kaydi: 8 ardisik cikarim, global
    reset olmadan, siniflandirmalar dogru (NO / SILENCE / YES).
    sw_nexys/build/*.hex
    Bes bellek imaji surum ko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
    [send_audio_to_fpga.py]
2026-09-08 Prepare d45_anten2 final delivery with verified artifacts and FPGA demos
    [dataset_full.csv, manifest.csv, metrics.csv, robustness.csv, samples.csv, wire_lengths.csv]
2026-09-08 fpga: TEKNOFEST demo tarafi - UART2 pinleri, DEMO_MODE imaji ve 156/156 golden sonucu
    Yarisma paketiyle gelen demo_harness.py araci iki ayri seri port ister.
    UART2 daha once karta HIC cikmiyordu (nexys_top icinde rxd sabit 1'e,
    txd bosa baglanmisti); Pmod JB uzerinden harici 3,3 V UART-TTL modulu ile
    disari verildi.
    DEMO_MODE ile derlenen ayri bir kart imaji eklendi. Normal imajdan iki
    farki var:
    1. Cikarimlar arasi 3 saniyelik bekleme yok. Arac vektorleri arka arkaya
    gonderiyor; bekleme zaman asimina yol aciyordu.
    2. UART_RDR bayt yolu dogrulama blogu atlaniyor. O blok cerceve basina
    1960 DEGIL 1964 bayt tuketiyordu; arac tam 1960 bayt gonderdigi icin
    fazladan istenen 4 bayt bir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
    [robustness.csv, samples.csv]
2026-09-08 dogrulama: Spike kenar durumlari, UVM sinyal kararliligi ve i2c yazmac denetimleri
    Uc dogrulama alani da genisletildi. Toplam denetim 377 -> 395.
    1) SPIKE ISS: 409 -> 484 buyruk
    Onceki core_test.c normal degerleri uyariyordu; ISS karsilastirmasinin
    asil degeri KENAR DURUMLARINDA ortaya cikar - bir cekirdek normalde
    dogru, sinirda yanlis olabilir ve bunu ancak referans model yakalar.
    Eklenenler:
    - mulhsu: dokumanda listeliydi, kodda YOKTU
    - bolme kenar durumlari (RISC-V spec Bolum 7.2): x/0 = -1, x%0 = x,
    INT_MIN/-1 = INT_MIN, INT_MIN%-1 = 0. RISC-V'de bolme istisna
    URETMEZ; tanimli deger dondurur ve yanlis uygulama normal
    testlerde gorunmez.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
2026-09-09 docs: juri sunumu icerik dosyasi
    docs/SUNUM_ICERIGI.md - sunum hazirlayacak ekip icin kaynak belge.
    KAPSAM (istenen sekiz baslik)
    1 kapak ve uc rakamlik ozet
    2 sistem mimarisi - blok diyagram, 13 satirlik bellek haritasi,
    fiziksel buyukluk (die, hucre sayisi, tel uzunlugu)
    3 islemci - CV32E40P + Spike ISS karsilastirmasi
    4 cevre birimleri - yedisi TEKER TEKER (UART x2, I2C, QSPI, GPIO,
    Timer, DMA, JTAG); her biri icin ozellik, denetim sayisi, kapsama
    5 NPU - alti adimli boru hatti, TCM yerlesimi, 156/156 sonucu
    6 bus - AXI4-Lite, SVA + UVM iki katman, 81.032 islem
    7 bellek - 46 kB SRAM / 23 makro, ASIC-FPGA ayrimi
    8 boot - flash -> I-RAM + TCM akisi
    9 do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
2026-09-09 dogrulama: i2c NACK yolu ve bayt sayisi varyasyonlari, juri ozetine kapsama bolumu
    1) I2C - 29 -> 38 denetim, branch %70,6 -> %80,7
    Iki gercek bosluk olculerek bulundu:
    a) NACK yolu HIC uyarilmiyordu. Testteki sanal kole her zaman ACK
    veriyordu; i2c_peripheral.sv ST_ADDR_ACK durumundaki NACK dali
    (sda_sampled yuksek -> ST_STOP) calismiyordu. Gercek veriyolunda
    adres NACK'i en sik karsilasilan durumdur: yanlis adres, cihaz
    takili degil, cihaz mesgul. rx_addr_and_nack gorevi eklendi.
    b) Butun islemler NBY=2 ile kosuluyordu. Bayt sayaci mantigi
    (byte_cnt + 1 < op_nby ve shift_out secim case'i) yalnizca iki
    bayt yolunda calisiyordu. NBY=1 (tek bayt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
2026-09-09 fpga: Vivado implementasyon raporlari eklendi
    Depo kokunde izlenmeyen dort Vivado raporu fpga/nexys_demo_20260908/reports/
    altina alindi:
    timing_impl.rpt yerlestirme sonrasi zamanlama (CLK100MHZ 100 MHz)
    timing_synth.rpt sentez sonrasi zamanlama
    utilization_impl.rpt kaynak kullanimi - Slice LUT 8114 (%12,80),
    LUT as Memory 64, 63400 LUT'luk cihazda
    power_impl.rpt toplam yonga ustu guc 0,129 W
    Bu raporlar FPGA gerceklemesinin bagimsiz kaniti; ASIC akisiyla iliskisi
    yoktur ve asic/ dizinine dokunulmamistir.
    provenance/package_files.json dort dosya icin guncellendi (1378 -> 1382).
2026-09-09 fpga: tam cevre birimi demosu - 34/34, JTAG dahil
    Yedi cevre birimini tek tek, kart uzerinde dogrulanabilir bicimde
    calistiran demo. Yarismada juri hangi birimi gormek isteyecegini
    onceden bilemedigimiz icin hepsi kapsandi.
    GPIO / Timer / I2C / QSPI / DMA / UART-stream / JTAG hata ayiklama
    JTAG, AXI yazmac arayuzu uzerinden gosterilir; harici adaptor
    olmadan da hata ayiklayicinin bellege yazip okudugu kanitlanir.
    TAP ayrica Pmod JC'ye cikarildi (TCK=JC1 TMS=JC2 TDI=JC3 TDO=JC4),
    GPIO_TXEN Pmod JD'ye alindi.
    BULUNAN GERCEK KUSURLAR
    bootloader.S - CHUNK_COUNT 8 idi, yalnizca 2 kB kopyaliyordu
    (8 x 64 x 4). Ayni dosyanin yorumu 32 islem gerektigini soyluyor
    ve link betigi 8 kB ayiriyo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
2026-09-09 fpga: NPU demosu - altin referansla birebir, 15/15
    NPU'yu kart uzerinde tb/npu_golden/ ile AYNI vektorle kosturur ve
    AYNI beklenen degerlerle karsilastirir:
    girdi q[i] = ((37*i + 13) mod 256) - 128
    cikti olasiliklar Q0.12 = [0, 225, 326, 3543]
    sinif 3 (NO)
    Ikisi de simulasyon beklentisiyle birebir esletti. Boylece "RTL'de
    gecti" degil "silikonda da ayni sonucu veriyor" diyebiliyoruz.
    Girdi formulle uretiliyor; formulun test_input_pattern.mem ile ayni
    490 kelimeyi urettigi once dogrulandi, 2 kB'lik tablo gomulmedi.
    AGIRLIK ZINCIRI KANITLANDI
    Kart uzerinde olculdu: WEIGHTS_READY biti kurulu, 4000/4000 kelime
    dolu, ilk kelime 0x060804FF = fc_weights_packed32.mem ile ayni.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
2026-09-09 kanit: sartname uyumu ve dort sapmanin belgelenmesi
    Sartname v1.3 ile uyum madde madde kaydedildi ve dort sapma acikca
    belgelendi. Sartname alternatif bilesen kullanimi ve yorum farklarinin
    raporda/sunumda belirtilmesini sart kosuyor; bu belge o yukumlulugu
    karsiliyor.
    1) QSPI FLASH PARCASI - S25FL128S [BELGELENMEMISTI]
    Sartname MT25QL256ABA8E12'yi referans verir; biz Nexys A7 kartinin
    uzerinde lehimli olan Spansion S25FL128S'i kullaniyoruz. Bu sapma
    bugune dek hicbir yerde belgelenmemisti - gercek bir eksikti.
    Durumumuz rahat: S25FL128S sartnamedeki 17 komutun 17'sini de
    destekliyor, RTL'de de hepsi tanimli. DDK'nin benzer uc basvuruya
    verdigi cevaplar emsal (2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
2026-09-09 i2c: SCL tam 400,000 kHz - sartname isteri karsilandi
    Sartname EK-2: "SCL saat frekansi 400 kHz SABIT hizinda olacaktir."
    ONCEKI DURUM
    QUARTER = SYS_CLK_FREQ / (4 * I2C_FREQ) ile SCL periyodu dort ESIT
    ceyrege bolunuyordu. 50 MHz'de bu 31,25 eder; tamsayi bolme 31 verir
    ve gercek SCL 403,2 kHz cikiyordu - hedefin %0,8 USTUNDE.
    KOK NEDEN
    Sorun sistem saatinde degil, esit ceyrek varsayimindaydi:
    SCL periyodu = 50e6/400e3 = 125 cevrim <- TAMSAYI
    125 / 4 = 31,25 <- tamsayi DEGIL
    Yani tam 400 kHz uretilebilirdi; yalnizca 125'i dorde esit bolmek
    mumkun degildi. Onceki degerlendirmemde "50 MHz'de tam 400 kHz
    matematiksel olarak uretilemez" demi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
2026-09-09 dogrulama: sartname uyum testleri - 84 denetim, 4 cevre birimi
    YENI TEST SINIFI
    Mevcut blok testleri "tasarim dogru calisiyor mu" sorusunu sorar.
    Bu testler farkli bir soru sorar: "SARTNAMEDE YAZAN CUMLE ne diyorsa
    TAM OLARAK o mu oluyor?"
    Her denetim sartnamenin ilgili cumlesini yorum olarak tasir ve o
    cumlenin dogrudan karsiligini olcer. Juri "su maddeyi sagliyor
    musunuz" diye sordugunda cevap tek bir test ciktisidir.
    sartname_timer 25 denetim EK-2 s.20-21
    sartname_gpio 15 denetim EK-2 s.20
    sartname_uart 20 denetim EK-2 s.21-22
    sartname_qspi 24 denetim EK-2 s.24-27
    --------------------------------------------
    TOPLAM 84 denetim 0 hata
    Dordu de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
    [qspi_master.sv, run_regression.py, tb_sartname_gpio.sv, tb_sartname_qspi.sv, tb_sartname_timer.sv, tb_sartname_uart.sv]
2026-09-09 dogrulama: islevsel kapsama %83 -> %92, UART-stream uyum testi eklendi
    SARTNAME EK-3: "dogrulama, tanimlanan islevsel coverage noktalariyla
    her zaman %100'u hedeflemelidir."
    ILK OLCUM: %83,33 (36 bin'den 27'si)
    cov_npu_class %50 4 sinifin 2'si
    cov_gpio %60 5 desenin 3'u
    cov_uart2_fifo %40 5 bolgenin 2'si
    cross irq x class %50
    KOK NEDEN 1 - SISTEM TESTI IKI SINIF URETIYORDU
    Sistem testi yalnizca 0x55 (NO) ve 0x80 (SILENCE) gonderiyordu.
    Altin referans modeliyle (tb/npu_golden/golden_reference.py) tarama
    yapilarak dort sinifi da ureten sabit desenler bulundu:
    0x00 -> 3 NO logits [-128, 76, 77, 114]
    0x68 -> 1 UNKNOWN logits [-128, 127, 127, 127]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
2026-09-10 Islevsel kapsama %100 (52/52) ve C_kapanis kosum bulgulari
    KAPSAMA OLCUMU DUZELTILDI
    Rapor yalnizca sistem_gercek_boot veritabanindan uretiliyordu, bu
    yuzden olcum %92,08'de takilmisti. Yeni kapsanan noktalar baska
    testlerde uretiliyor. xcrg'nin -cov_db_dir ile tum veritabanlarini
    birlestirmesi calismiyor ("No Functional Coverage Databases have
    been found") ama tek veritabani -cov_db_name ile sorunsuz rapor
    veriyor. islevsel_kapsam() her veritabani icin ayri rapor uretip
    noktalari BIRLESTIRIYOR. Bu, daha once hic gorulmeyen kapsama
    noktalarini da ortaya cikardi (cov_class, cov_fifo_level,
    cov_pack_cnt).
    KAPATILAN UC BOSLUK
    cov_uart2_fifo 2/5 -> 5/5
    Test UART2'ye yal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
2026-09-10 C_kapanis tamamlandi: LVS ve KLayout DRC temiz, hold/slew acik
    KOSUM 80 ADIMDA BITTI, final/ uretildi (GDS, LEF, netlist, SDF, SPEF).
    GECEN IMZA DENETIMLERI
    LVS (netgen) Circuits match uniquely
    KLayout imza DRC 0 ihlal (256 kural kategorisi tarandi)
    Detayli yonlendirme DRC 0
    Anten net / pin 0 / 0
    Guc dagitim agi 0 / 0
    Setup dokuz kosede de POZITIF, en kotu +0,810 ns
    Toplam guc 86,2 mW
    ACIK KALAN
    Hold: dokuz kosenin sekizinde ihlal, en kotu WNS -0,653 ns
    (max_tt), en kotu TNS -4,623 ns (max_ff).
    Slew/cap/fanout: en kotu kosede 17.065 / 1911 / 66.
    ONCEKI BIR IFADEM DUZELTILDI
    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
2026-09-10 Saat agi teshisi: skew, hold ihlalinden 2,5-291 kat buyuk
    DIS INCELEME DOGRULANDI VE KENDI TESHISIM DUZELTILDI
    Dis bir inceleme raporu geldi; her iddiasi kurulu arac ve kendi
    loglarimiz uzerinden sinandi.
    ANA TEZI DOGRU. C_kapanis final/metrics.json olcumu:
    Kose Hold skew Hold WNS Oran
    max_ss_100C_1v60 -3,622 -0,320 11 x
    nom_ss_100C_1v60 -3,257 -0,011 291 x
    max_tt_025C_1v80 -2,170 -0,653 3,3 x
    max_ff_n40C_1v95 -1,640 -0,646 2,5 x
    Saat skew'i her kosede hold ihlalinden 2,5-291 KAT buyuk. Yani
    hold ihlalleri saat agi dengesizliginin ARTIGIDIR.
    Bu benim onceki teshisimi kismen curutur.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
    [metrics.csv]
2026-09-10 Protokol ve sinir degeri testleri; RSZ-0090 makro kisiti belgelendi
    YENI TESTLER (regresyon 24 -> 26 test, 593 -> 602 denetim)
    tb_axi_protokol.sv 6 denetim
    AXI4-Lite'in SERBEST biraktigi ama testlerimizin HIC denemedigi
    davranislar: B ve R kanali geri basinci. Mevcut testler
    BREADY/RREADY'yi hep yuksek tutuyordu.
    BVALID, BREADY gelene kadar yuksek kaliyor 10/10 cevrim
    RREADY dusukken RVALID/RDATA degismiyor dogrulandi
    tb_sinir_degerleri.sv 129 ic kontrol
    Dar alanlarda yapilan aritmetigin sinir degerlerde tasip
    tasmadigini tarar (QSPI presc=63 hatasinin sinifi).
    I2C op_nby: reg_nby 0..63 icin her zaman 1..4 araliginda,
    tasma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
2026-09-11 Teslim paketi K_diyot kosumuna gecirildi - dogrulama temiz
    BEYAN EDILEN CALISMA NOKTASI: 23 ns (43,5 MHz)
    Dokuz PVT kosesinin tamaminda setup ve hold POZITIF, setup TNS SIFIR.
    | Kose | Setup WNS | Setup TNS | Hold WNS |
    |------------------|----------:|----------:|---------:|
    | min_ss_100C_1v60 | +1,5562 | 0,0 | +1,1638 |
    | nom_ss_100C_1v60 | +0,7078 | 0,0 | +1,1717 |
    | max_ss_100C_1v60 | +0,3965 | 0,0 | +1,1817 |
    | min_tt_025C_1v80 | +5,7672 | 0,0 | +0,5841 |
    | nom_tt_025C_1v80 | +5,2083 | 0,0 | +0,5885 |
    | max_tt_025C_1v80 | +4,9112 | 0,0 | +0,5943 |
    | min_ff_n40C_1v95 | +7,3622 | 0,0 | +0,3738 |
    | nom_ff_n40C_1v95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
    [metrics.csv]
2026-09-13 S_final2 teslim paketi; depo yapisi sartname Tablo 8'e gore duzenlendi
    ASIC KOSUSU (S_final2)
    - SPICE cikarimi GDSII gorunumunden yapildi (MAGIC_EXT_USE_GDS=true):
    1.809.268 transistor, black-box girdisi yok. PDF Bolum 6.2'nin
    "Nihai GDSII gorunumunden cikarilan ve LVS'de kullanilan SPICE
    netlisti" zorunlu ciktisi artik tam karsilaniyor.
    - Netgen LVS: Circuits match uniquely
    - Zamanlama (9 PVT kosesi, 23,148 ns): setup 9/9 ve hold 9/9 pozitif,
    TNS sifir, ihlalli yol yok
    - KLayout DRC 0, routing DRC 0, XOR 0, anten 0/0
    - config.yaml kosuda fiilen kullanilan yapilandirmayla esitlendi
    (resolved.json ile 14 anahtar karsilastirildi, fark yok)
    DEPO YAPISI
    - final_t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
    [metrics.csv, wire_lengths.csv]
2026-09-13 Buyuk fiziksel ciktilar Git LFS ile eklendi
    098d1b0 commit'ini tamamlar. O commit'te haric tutulan buyuk
    fiziksel akis ciktilari bu commit'te Git LFS uzerinden eklenmistir.
    Eklenen (34 dosya, ~4.57 GB):
    asic/results/gds/soc_top.gds - nihai GDSII
    asic/results/def/soc_top.def - nihai DEF
    asic/results/spice/*.spice - GDS'ten cikarilan SPICE (MAGIC_EXT_USE_GDS)
    asic/results/netlist/*.v - PnR sonrasi netlist
    asic/results/*/*.odb, *.spef, *.sdf - veritabani / parazit / gecikme
    asic/reports/power/net-V{PWR,GND}.csv
    asic/reports/timing/*/max.rpt - 9 kose STA raporu
    asic/macros/*/gds/*.gds - SRAM makro GDS
    LFS kurallari .gitattribu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
    [net-VGND.csv, net-VPWR.csv, soc_top__max_ff_n40C_1v95.sdf, soc_top__max_ss_100C_1v60.sdf, soc_top__max_tt_025C_1v80.sdf, soc_top__min_ff_n40C_1v95.sdf, soc_top__min_ss_100C_1v60.sdf, soc_top__min_tt_025C_1v80.sdf]
2026-09-13 Dogrulama incelemesi duzeltmeleri; FPGA demo kanitlari; aktif UVM testi
    DIS INCELEME BULGULARI
    1. Saat/SDC netligi (asic/README.md §6)
    design.sdc icindeki "20.0" satirinin ne oldugu belgelendi: kullanilan
    deger degil, CLOCK_PERIOD tanimsizsa devreye giren yedek dal. Uc
    bagimsiz kanit eklendi (pnr_resolved.sdc -period 14.0000, akis
    loglari "clk_period = 14 ns", STA saat kenari 11.574 = 23.148/2).
    2. Frekans: 43,5 MHz -> 43,2 MHz
    Dokuz kose STA gercekten 23,148 ns ile alinmis. SUNUM_ICERIGI ve
    JURI_TEKNIK_OZET eski d45_anten2 sonuclarini (uc kosede negatif
    setup) anlatiyordu; S_final2'nin gercek slack'leriyle degistirildi -
    tamami pozitif, worst setup +0,2782 / hold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
    [robustness.csv, samples.csv]
2026-09-13 asic/README §12.1: Git LFS kullanimi ve yedek arsiv bilgileri
    GIT LFS BOLUMU (yeniydi)
    100 MB ustu dosyalar Git LFS ile saklanir. Bu depoda YAZILI DEGILDI:
    depoyu 'git lfs install' yapmadan klonlayan biri GDS/DEF/ODB yerine
    birkac yuz baytlik isaretci metni indirir ve dosyalari bozuk sanir.
    Klonlama komutlari ve dogrulama adimlari eklendi:
    git lfs ls-files -> 34 dosya
    git lfs fsck -> "Git LFS fsck OK"
    BOYUT DUZELTMELERI
    Tabloda GDS 365 MB ve DEF 288 MB yaziliydi; gercek degerler 382 MB
    ve 301 MB. Eksik satirlar da eklendi (ODB 783 MB, MAG 492 MB,
    KLayout GDS 215 MB, powered netlist 227 MB, SPICE 119 MB,
    net-VPWR.csv 110 MB). asic/ toplami: 249 dosya / 4,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
2026-09-14 FPGA bitstream'leri guncel RTL'den yeniden uretildi; Demo C (ESP32 I2C) eklendi
    BITSTREAM TUTARSIZLIGI GIDERILDI
    Dis inceleme "FPGA bitstream eski RTL'den" diye kirmizi isaretlemisti ve
    haklıydi: bitstream 9 Eylul'e aitti, sonrasinda RTL'de uc commit vardi
    (d808380 QSPI adres kipi, ba35ada uc modulde AXI W kanali veri kaybi,
    098d1b0 I2C saat germe / JTAG / NPU).
    Her iki bitstream de 14 Eylul'de GUNCEL RTL'den yeniden uretildi:
    Demo A nexys_top.bit WNS +1,207 WHS +0,033 TNS/THS 0 DRC 0 hata
    Demo C nexys_usb_top.bit WNS +1,270 WHS +0,023 TNS/THS 0 DRC 0 hata
    Artik FPGA ve ASIC ayni kaynaktan; "sunumda anlattiginiz RTL bu mu"
    sorusunun cevabi EVET.
    DEMO A - SKOR KARSILAS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
    [robustness.csv, samples.csv]
2026-09-14 asic/: rapor yerlesimi sartname Tablo 8'e hizalandi
    BAGLANTISIZ PIN RAPORU signoff/ ALTINA TASINDI
    Final Istenen Ciktilar dokumani Tablo 8'de reports/ altinda on bir alt
    dizin tanimlar; 'connectivity' bunlardan biri DEGILDIR. Baglantisiz pin
    sonuclari §5.6'da fiziksel signoff kalemleri arasinda sayilir.
    asic/reports/connectivity/full_disconnected_pins_table.txt
    -> asic/reports/signoff/full_disconnected_pins_table.txt
    asic/reports/connectivity/odb-reportdisconnectedpins.log
    -> asic/reports/signoff/odb-reportdisconnectedpins.log
    asic/reports/connectivity/runtime.txt
    -> asic/reports/signoff/odb-reportdisconnectedpins-runtime.txt
    (signoff/ altinda ad cakismasini onlem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
